jackpham-rgb/MEproject2026F/docs/draft/README.md

# Draft concept notes

`Project_Notes_ConceptA.docx` (also in the team Google Doc) is an **early draft written for the
concept / PDR stage**. Its numbers and parts (lazy-susan, 4.7 in can, 2 bushings, block CAD) are
out of date. The current design is in `docs/03_detail_design.md`, `docs/04_wiring.md` and
`docs/05_bom.md`.
