jackpham-rgb/MEproject2026F/docs/draft/Project_Notes_ConceptA.docx

# ME 2331 Project

notes on how robot works, what it is made of, why picked each part, and the parts list

# 1. What it has to do

An empty soda can (2.4 in wide, 4.7 in tall, about 15 g) stands upright on the table, 5 in from the robot. The robot has to flip it upside down and put it down, standing on its own, at a second spot. That spot is also 5 in from the robot, and 90 degrees from original position. It has to run on an Arduino Uno with no one touching it after the start button, assume we don't need fancy sensor to detect where is the can originally.

# 2. The main idea (Concept A: claw + wrist flip + turntable)

The robot sits at the corner, and works like a small crane:

- Turntable: the whole robot turns around a vertical axis at the robot's location. This is what moves the can 90 degrees, at 5 in.
- Lift: the arm can move up and down a little (about 0.6 in) on the column.
- Wrist: at the end of the arm, a wrist turns the gripper 180 degrees. This is what flips the can upside down.
- Gripper: 2 arms that close on the middle of the can.

So the robot does 4 simple moves one after another: grip, lift, flip, turn, then lower and let go. Every move is done by its own servo, so each step is easy to test by itself.

Since the turntable is right at the robot's location, the 90 degrees is exactly what the requirement asks for: the robot itself visibly turns 90 degrees, and the can stays 5 in away the whole time.

[PUT GIF HERE: conceptA_claw_turntable.gif] (Concept A, the full move)

## Why it needs the lift

The can is gripped in the middle, 2.35 in above the table. But the corner of the can (bottom edge) is 2.64 in from the middle (√(1.2² + 2.35²)). So if the wrist flips the can without lifting, the corner digs about 0.29 in into the table. Lifting 0.6 in first gives about 0.3 in of room.

[PUT GIF HERE: conceptA_claw_turntable_no_lift_hits_table.gif] (same move with no lift: the table turns red where the can hits it)

# 3. step by step

1. Home: at power-on, all 4 servos go to their start angles. Servos already know their own angle, so no home switch is needed.
2. Wait: the robot waits for someone to press the start button.
3. Optional: Detect: an IR sensor in the gripper checks that a can is really between the arms.
4. Grip: a small servo closes the arms to a set angle, just past where the pads touch the can (found by testing), so the can won't be dent. A normal servo can't tell the Arduino when it has stopped, so we use a fixed angle and let the soft pads do the squeezing.
5. Lift: the lift servo raises the arm about 0.6 in, so the can is off the table.
6. Flip: the wrist servo turns the gripper 180 degrees, so the can is now upside down. It starts slow, speeds up, and slows down again at the end, to make sure the whole thing won't shake and the can won't slip out.
7. Turn: the turntable servo turns the whole arm 90 degrees, slowly in the same way, so the can is now above the target.
8. Lower: the lift servo goes back down the same 0.6 in. The can was flipped around its own middle, so it lands exactly on the table, no drop.
9. Release: the arms open. The can stands upside down on the target spot.
10. Optional: Return: only after the can is taken away, press the button again: the lift goes up, the wrist turns back, and the arm turns back to the start. Not before: the open arms are still on both sides of the can and would knock it over.
11. Optional: the LED stays on when done.

If anything goes wrong (no can, can slips), the robot stops and opens the arms. That is called a fault.

Why slow at the start and end of every move? The can is empty and only 15 g. A fast stop can make it swing in the arms or shake loose, so every servo move is eased in and out (about 1–1.5 s per move).

# 4. Why this design and not the others

looked at 4 ideas. Our ranking: A → B → D → C.

## A. Claw + wrist flip + turntable (picked)

The most natural one: most people would vote for it, because it moves the can the way a person would. The robot turns 90 degrees right in front of you, so it clearly meets the requirement.

Downside: lots of failure points. 4 servos work one after another, and each can be a little off (turntable angle, lift binding, wrist not reaching a full 180 degrees). And it needs the lift, or the can hits the table (see the GIF in section 2).

[PUT GIF HERE: conceptA_claw_turntable.gif] (optional here, same GIF as section 2)

## B. Cradle flip + drag

A tall cradle holds the can, flips it in place, sets it down upside down, then drags it 90 degrees along the table. It is more complicated in movement: dragging an upside-down can on its thin rim can wobble or tip it.

[PUT GIF HERE: conceptB_cradle_drag.gif]

## D. Mirror flip

One arm turns 180 degrees around a diagonal shaft, and that flips and moves the can in one motion, with only 2 motors. It is technically true to the requirement (the can ends 90 degrees away at 5 in, measured from the robot's corner), but it can be called the lazy option: the arm swings 180 degrees and the robot never turns 90 degrees itself. So it won't be the first pick. It also needs a precise gear motor with encoder and a shaft height built to ±0.04 in.

[PUT GIF HERE: conceptD_mirror_flip.gif]

## C. Multi-joint pincer arm

A real robot arm (base, shoulder, elbow, wrist) that lifts, swings and rolls the can. The most beautiful one, but the hardest and most complicated: 5 servos, hard math (inverse kinematics), and it gets wobbly at a 5 in reach.

[PUT GIF HERE: conceptC_pincer_arm.gif]

## Decision matrix

Each idea scored 1 (bad) to 5 (good) on what matters most for our team. Weight = how important.

Criteria | Weight | A | B | D | C
Clearly meets the 90° around the robot requirement | 0.25 | 5 | 5 | 2 | 4
Can lands upright and upside down reliably | 0.20 | 4 | 2 | 4 | 4
Few failure points (fewer motors) | 0.15 | 2 (4 servos) | 2 (4) | 5 (2) | 1 (5)
Simple parts and electronics | 0.15 | 4 (servos only) | 4 | 2 (motor + encoder + driver) | 3
Simple movement and code | 0.15 | 4 (one move at a time) | 3 | 3 | 1 (inverse kinematics)
Easy to build (tolerances) | 0.10 | 3 | 3 | 2 (±0.04 in) | 2
Total (out of 5) | | 3.85 | 3.30 | 3.00 | 2.75

## How the total is calculated

For each idea: multiply each score by its weight, then add them up. The weights add up to 1.00, so the total is still out of 5.

Example, Concept A:

- 90° requirement: 5 × 0.25 = 1.25
- Lands reliably: 4 × 0.20 = 0.80
- Few failure points: 2 × 0.15 = 0.30
- Simple parts: 4 × 0.15 = 0.60
- Simple movement: 4 × 0.15 = 0.60
- Easy to build: 3 × 0.10 = 0.30

Total = 1.25 + 0.80 + 0.30 + 0.60 + 0.60 + 0.30 = 3.85

Same way: B = 1.25 + 0.40 + 0.30 + 0.60 + 0.45 + 0.30 = 3.30, D = 0.50 + 0.80 + 0.75 + 0.30 + 0.45 + 0.20 = 3.00, C = 1.00 + 0.80 + 0.15 + 0.45 + 0.15 + 0.20 = 2.75.

Check: even if every criteria is weighted the same (just the average of the 6 scores), the order stays A (3.67), B (3.17), D (3.00), C (2.50).

# 5. Main parts and what each one does

- Base plate: holds everything down and keeps the robot in the right spot on the table. It would be helpful to add weight to keep the base heavy, since the arm reaches out 5 in and could tip the robot.
- Turntable (lazy susan bearing + turntable servo): turns the whole robot 90 degrees. The bearing carries the weight, so the servo only has to turn it.
- Column: stands on the turntable and holds the lift.
- Lift carriage + lift servo: slides up and down the column on 2 guide rods with LM6UU bearings, about 0.6 in, so the can can flip without hitting the table.
- Arm: reaches out from the column so the middle of the can is 5 in from the robot's turning point.
- Wrist + wrist servo: at the end of the arm, turns the gripper 180 degrees to flip the can.
- Gripper (palm + 2 arms): V-shaped arms that center the can by themselves when they close, with soft pads. Grips the can in the middle (2.35 in high).

# 6. Materials and why

Part | Material | Why
Base, turntable plate, column, lift carriage, arm, wrist mount, palm, arms | PLA (3D printed) | Cheap, easy to print, stiff enough for these small loads. No heat or outdoor use, so we don't need ABS or PETG.
arm pads | TPU (flexible print) or silicone sheet | Grippy. The can doesn't slip with a light squeeze, and the soft pad keeps the can from denting.
Turntable bearing | Lazy susan bearing, 3–4 in (steel) | Holds the weight of the arm and can so the turntable servo doesn't carry it on its own shaft. Makes the turn smooth and less wobbly.
Lift guide | 2 × 6 mm steel rods + 2 LM6UU linear bearings | Smooth up and down. The arm sticks out about 3 in, which tilts the carriage like a drawer pulled by one corner: a printed plastic slide would jam (we calculated it), the LM6UU bearings slide freely.
Base weight | Steel washers or bolts | Keeps the robot from tipping when the arm reaches out 5 in with the can.
Fasteners | M3 screws and nuts | Standard size, fits most small electronics and printed parts.

# 7. Electronics:

- Arduino Uno: the brain, required.
- Turntable servo (MG996R, 180°): strong servo for turning the whole arm 90 degrees.
- Lift servo (MG90S): raises and lowers the arm about 0.6 in, through a small lever or rack.
- Wrist servo (micro servo that really reaches 180°, or a 270° micro servo): flips the can. Many cheap servos stop around 170°, so this one has to be checked or we use a 270° one.
- Gripper servo (SG90 or MG90S): opens and closes the arms.
- 5–6 V power supply for the servos, 5 A or more (buck converter or adapter): 4 servos can pull a lot of current at the same time (the MG996R alone can pull about 2.5 A). If the servos ran off the Uno's 5 V pin, it would reset the Uno in the middle of a move.
- Big capacitor (1000 µF) on the servo power: smooths out the current spikes when servos start moving.
- Start button: starts the run.
- Optional: IR sensor: checks the can is in the arms before starting.
- Optional: FSR (force sensor): measures grip force (stop at about 1.5 N) and confirms the can is really held before lifting.

No motor driver and no encoder needed: servos already hold their own angle, and the Arduino Servo library runs all 4 from any pins.

# 8. Bill of Materials (BOM)

# | Item | Qty | Source | Est. cost | Notes

1 | Arduino Uno R3 | 1 | ELEGOO kit | —
2 | MG996R servo (180°) | 1 | Buy | $8–10 | Turntable
3 | MG90S servo | 1 | Buy | $4 | Lift
4 | Micro servo with full 180° (or 270° micro servo) | 1 | Buy | $5–8 | Wrist flip, check the range
5 | SG90 or MG90S servo | 1 | Kit / buy | $0–4 | Gripper
6 | Lazy susan bearing, 3–4 in | 1 | Buy / hardware store | $4 | Turntable
7 | 6 mm steel rod ~3 in + LM6UU linear bearings | 2 + 2 | Buy | $6 | Lift guide (needed, a printed slide jams)
8 | 5–6 V buck converter, 5 A or more | 1 | Buy | $6 | Servo power
9 | Power supply 7–12 V, 3 A or more | 1 | Buy / lab | $10
10 | 1000 µF capacitor | 1 | Kit / buy | $1 | Servo power
11 | Push button | 1 | Kit | — | Start
12 | IR proximity module (TCRT5000 or KY-032) | 1 | Kit / buy | $1–2 | Optional, can detect
13 | FSR 402 force sensor + 10 kΩ resistor | 1 | Buy | $7 | Optional
14 | TPU filament or silicone sheet | A small sheet | Buy | $2 | arm pads
15 | Steel washers / bolts | Some | Hardware store | $2 | Base weight
16 | 3D printed parts (base, turntable plate, column, lift carriage, arm, wrist mount, palm, 2 arms) | 9 | Print (PLA) | filament
17 | M3 screws, nuts, wires, headers | — | Kit / buy | $5
| Total to buy (beyond the Arduino kit) | | | about $50–65 | about $40–55 without the optional parts

# 9. Check after buying

- Check the wrist servo really turns a full 180 degrees. If not, switch to a 270° servo.
- Find the exact servo angles: turntable at start and at 90°, lift up and down, gripper open and closed on a can.
- Check the lift slides smoothly and goes up at least 0.6 in.
- Squeeze a few scrap cans to see when they dent, then set the gripper angle below that.
- Model the parts in SolidWorks and check the robot doesn't tip with the arm reaching out.
- Measure the can's top rim size.
