jackpham-rgb/MEproject2026F/docs/drawings/CA-101_base.png

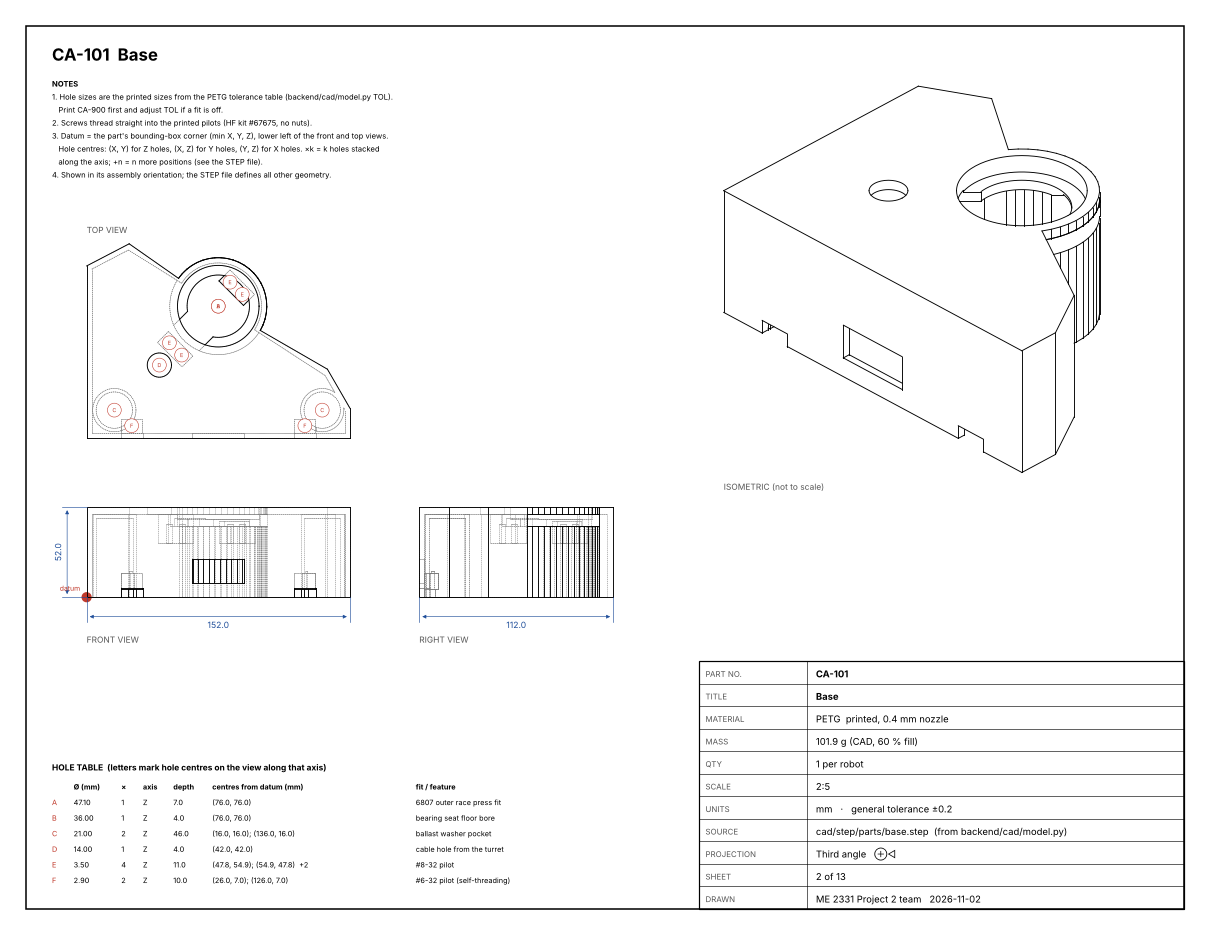
docs/drawings/CA-101_base.png
