jackpham-rgb/MEproject2026F/docs/drawings/CA-102_electronics_tray.png

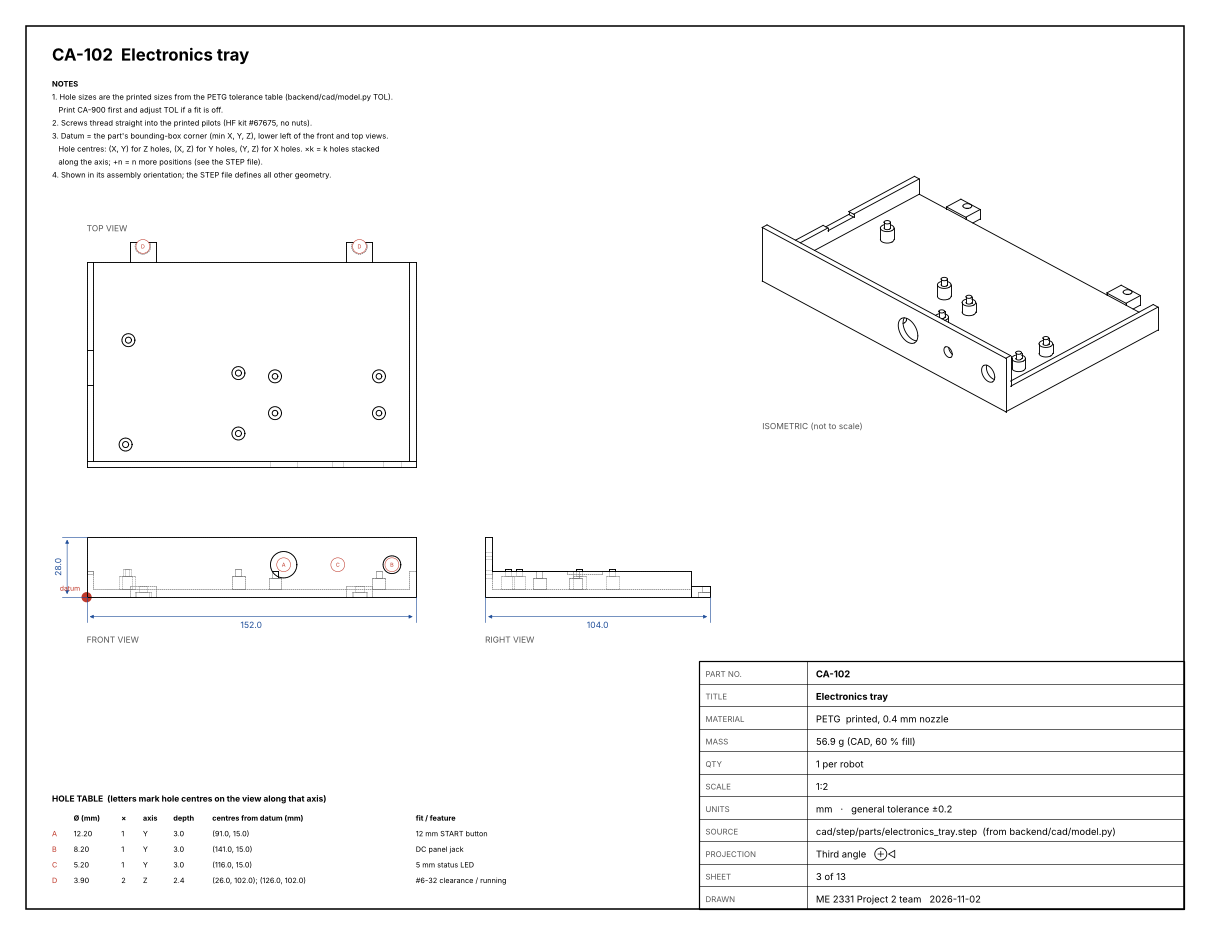
docs/drawings/CA-102_electronics_tray.png
