jackpham-rgb/MEproject2026F/docs/drawings/CA-201_turret_plate.png

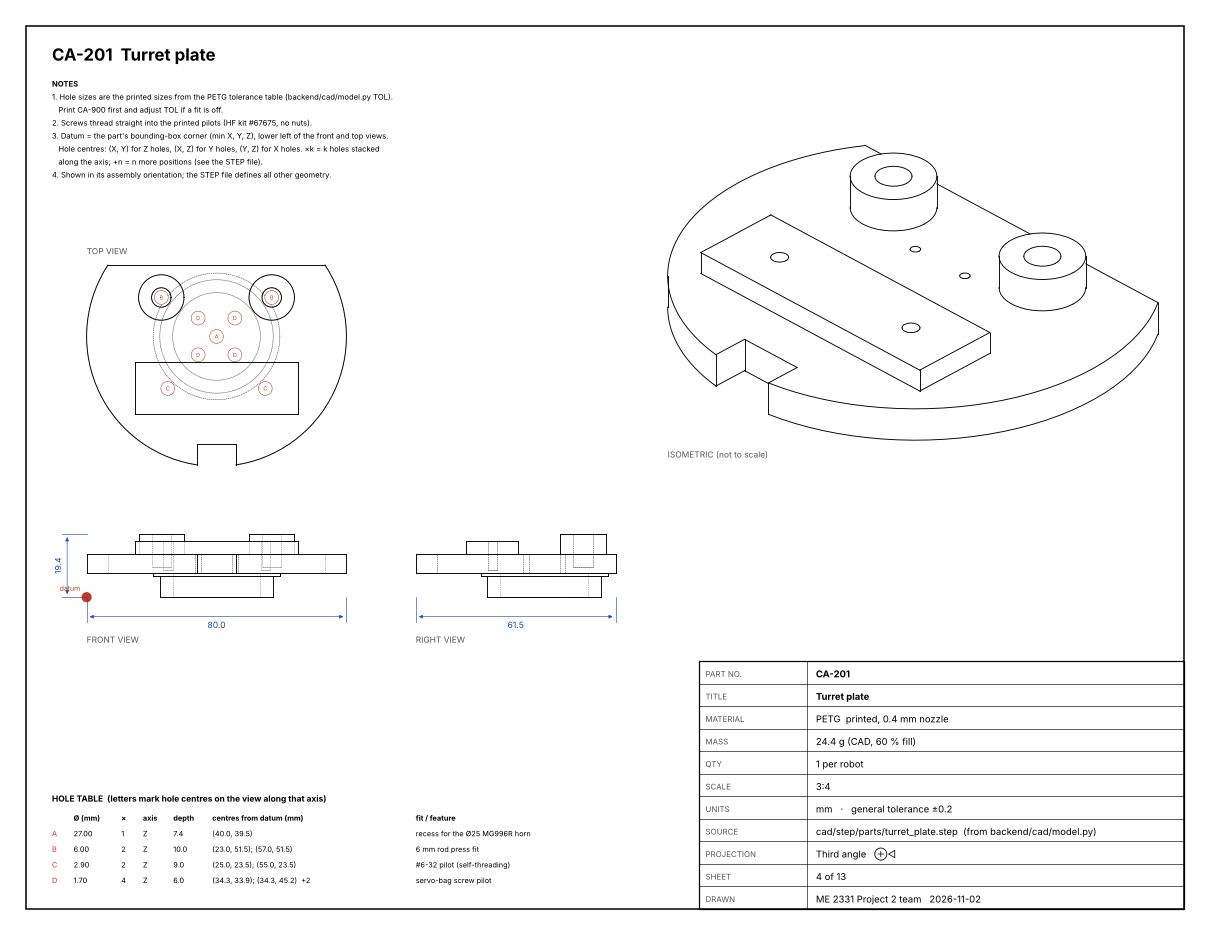
docs/drawings/CA-201_turret_plate.png
