jackpham-rgb/MEproject2026F/docs/drawings/CA-202_spine.png

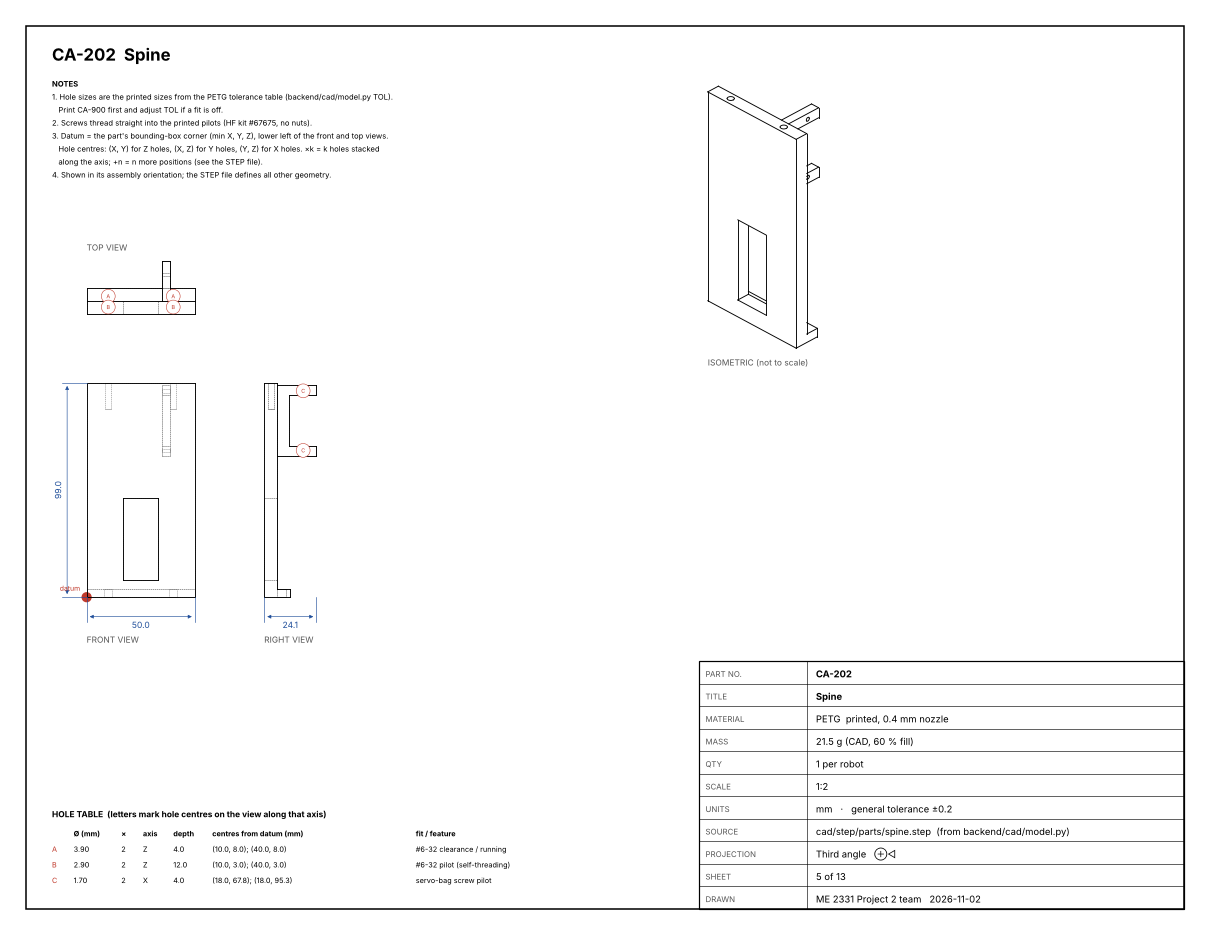
docs/drawings/CA-202_spine.png
