jackpham-rgb/MEproject2026F/docs/drawings/CA-203_top_cap.png

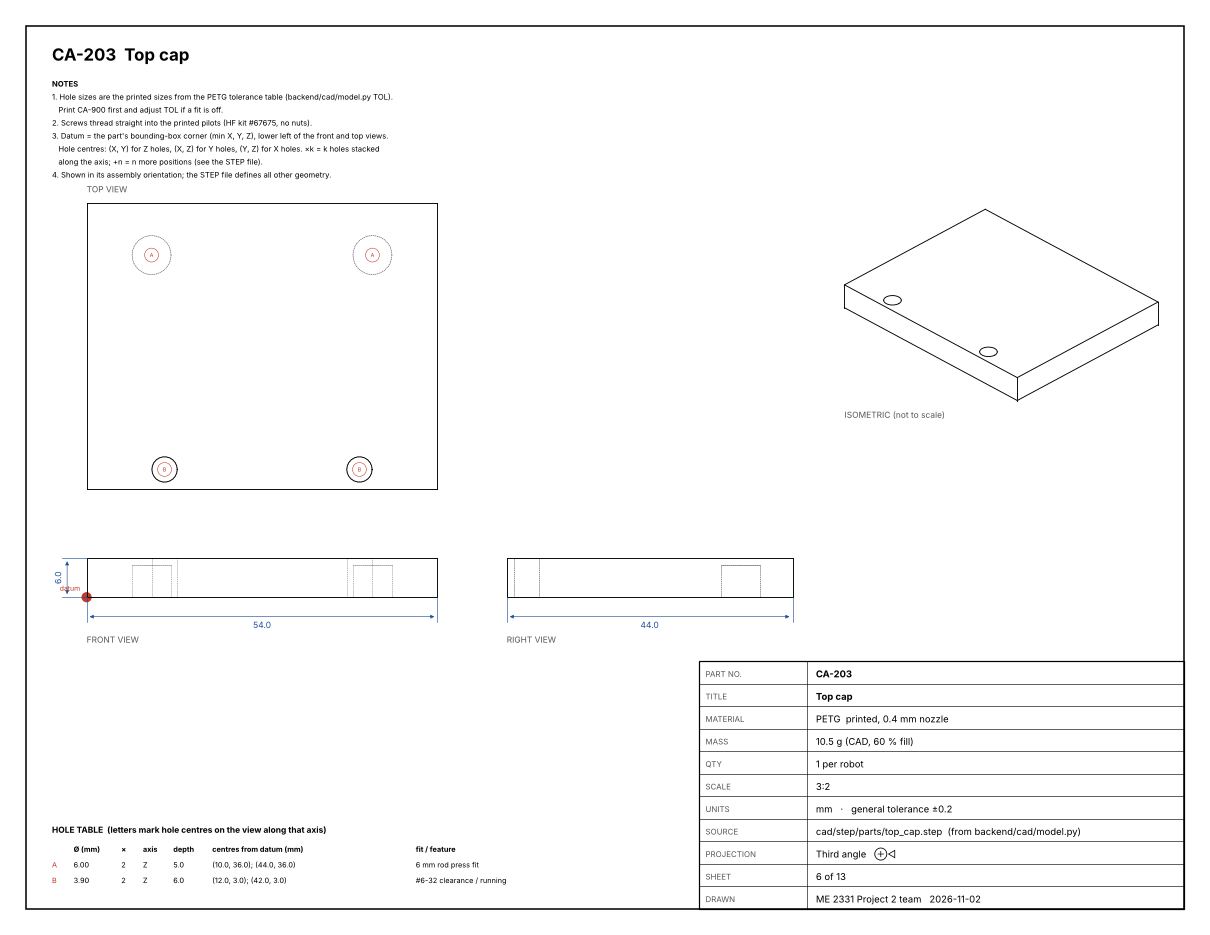
docs/drawings/CA-203_top_cap.png
