jackpham-rgb/MEproject2026F/docs/drawings/CA-301_carriage_arm.png

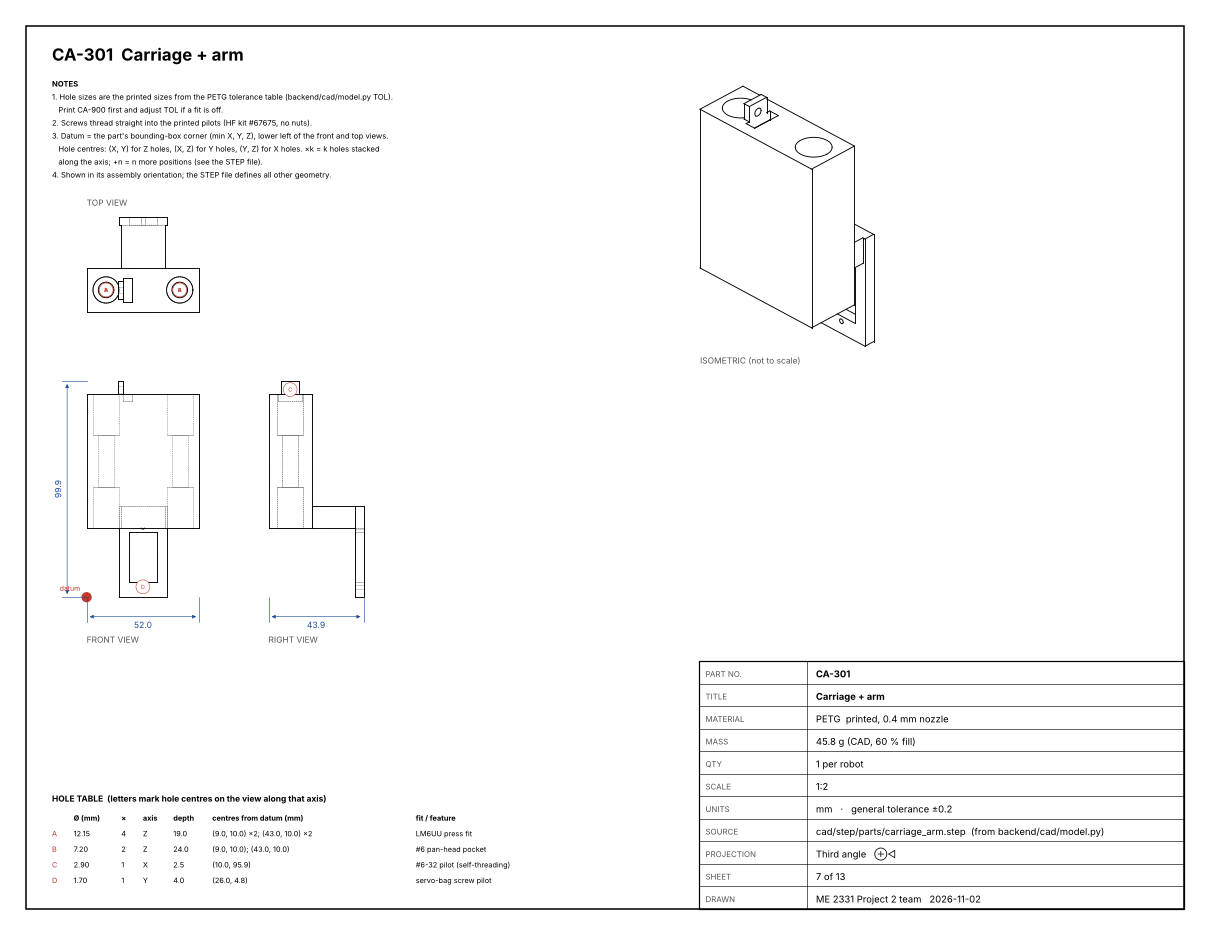
docs/drawings/CA-301_carriage_arm.png
