jackpham-rgb/MEproject2026F/docs/drawings/CA-302_lift_link.png

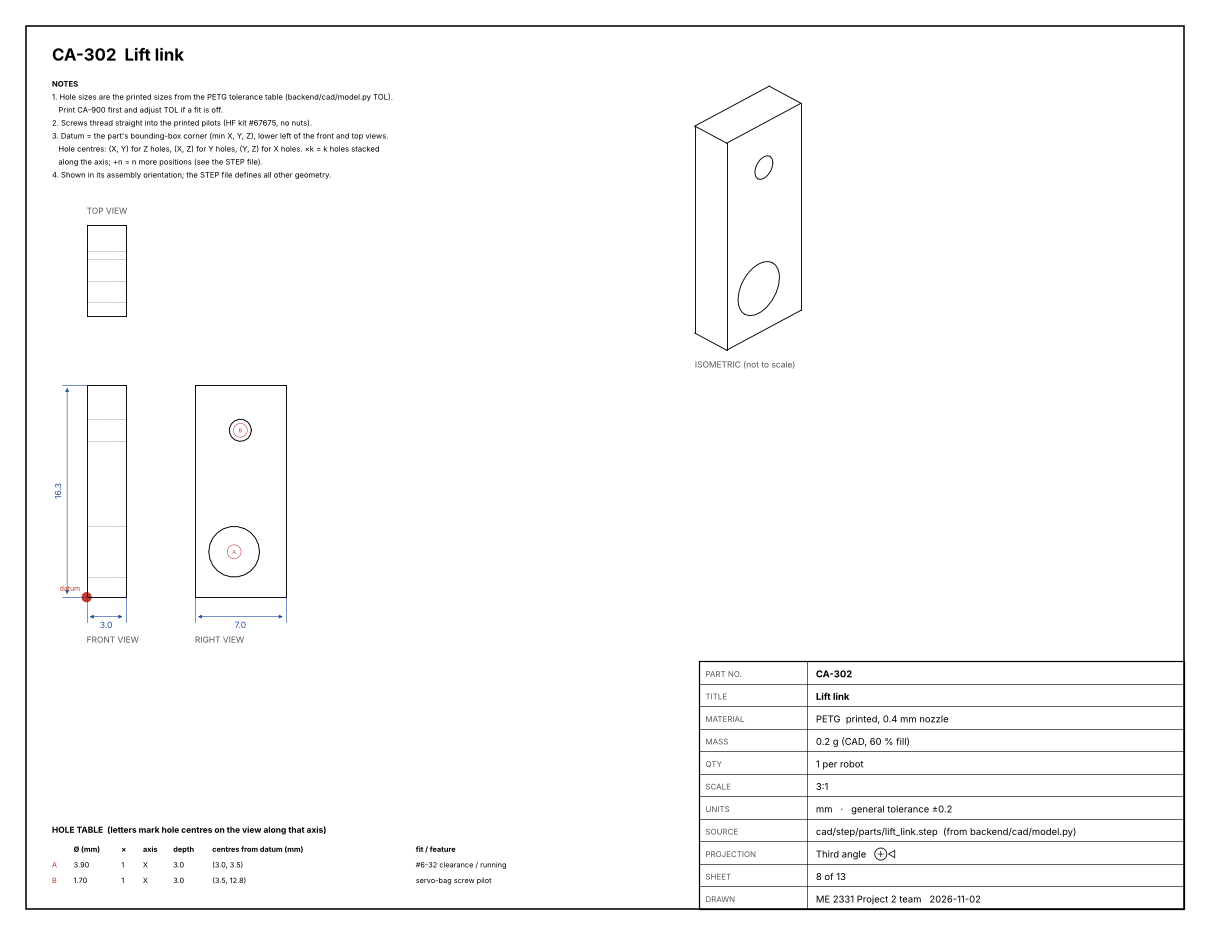
docs/drawings/CA-302_lift_link.png
