jackpham-rgb/MEproject2026F/docs/drawings/CA-401_gripper_frame.png

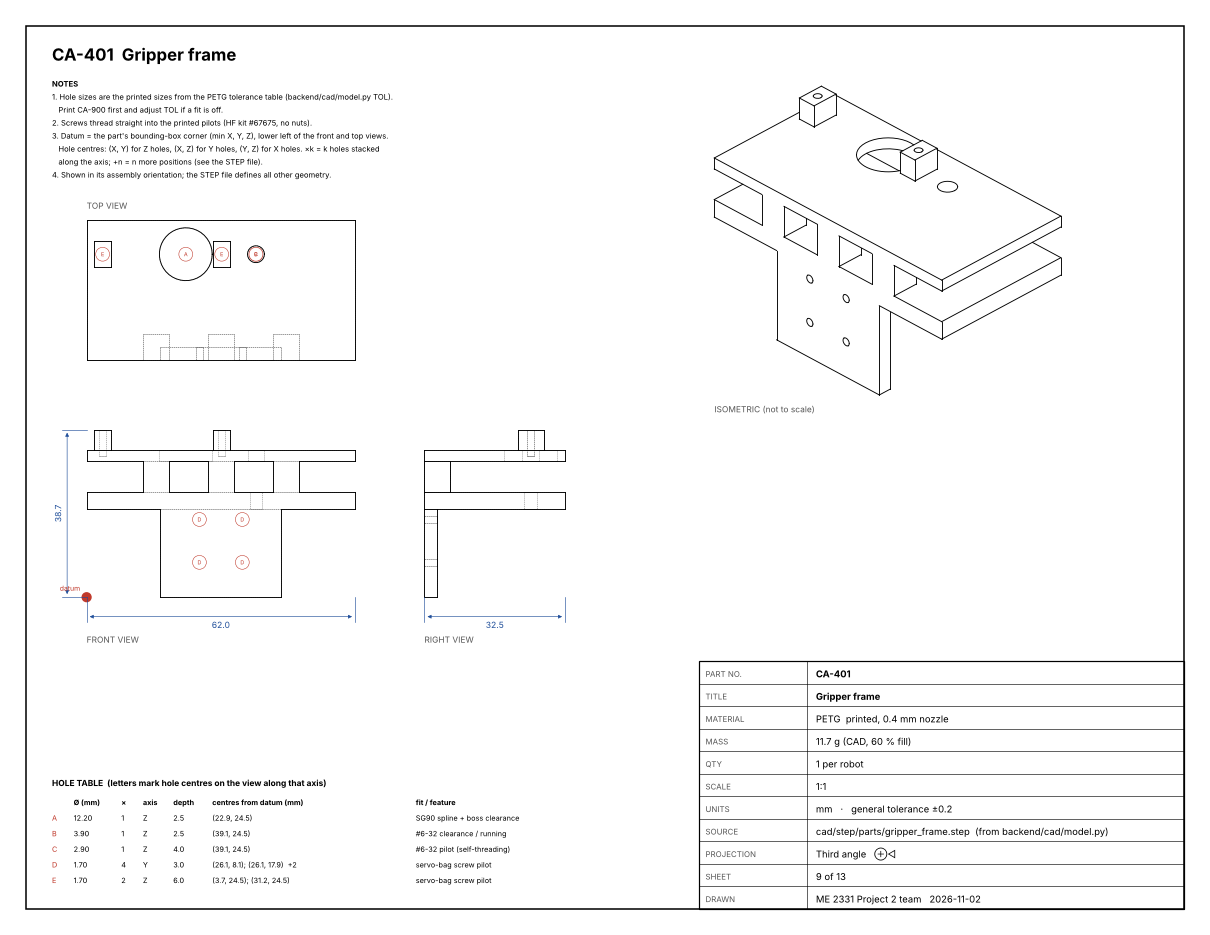
docs/drawings/CA-401_gripper_frame.png
