jackpham-rgb/MEproject2026F/docs/drawings/CA-402_finger_R.png

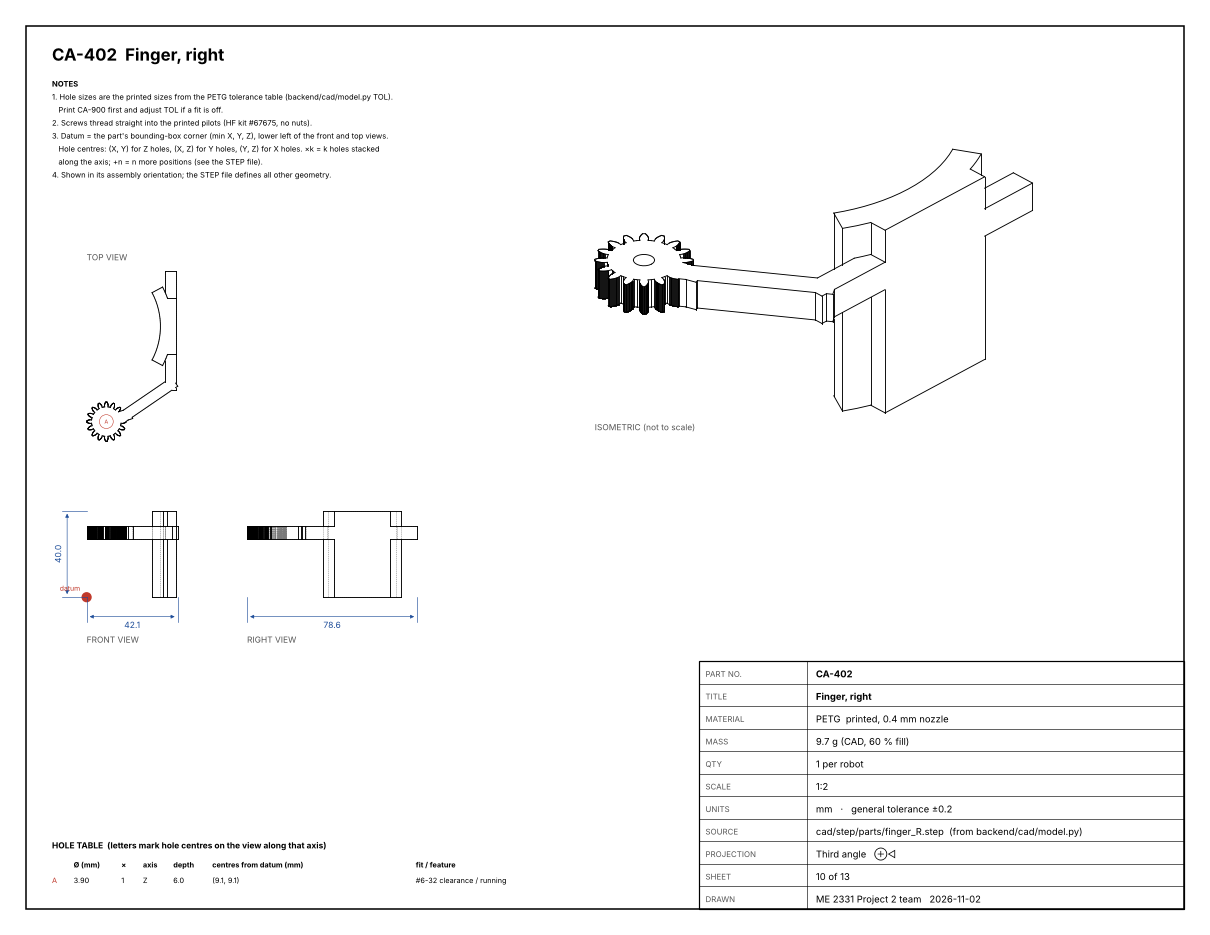
docs/drawings/CA-402_finger_R.png
