jackpham-rgb/MEproject2026F/docs/drawings/CA-403_finger_L.png

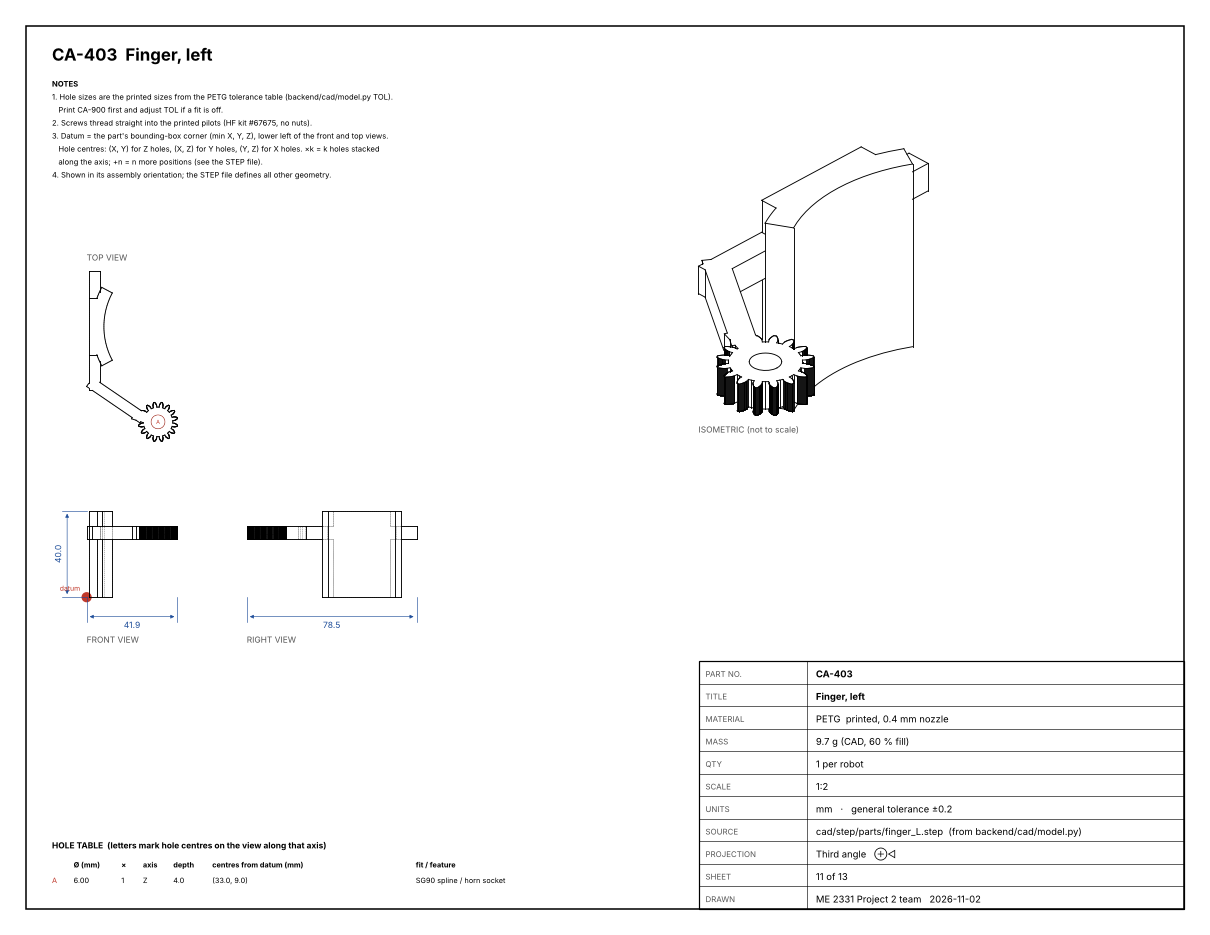
docs/drawings/CA-403_finger_L.png
