jackpham-rgb/MEproject2026F/docs/drawings/CA-404_can_bumper.png

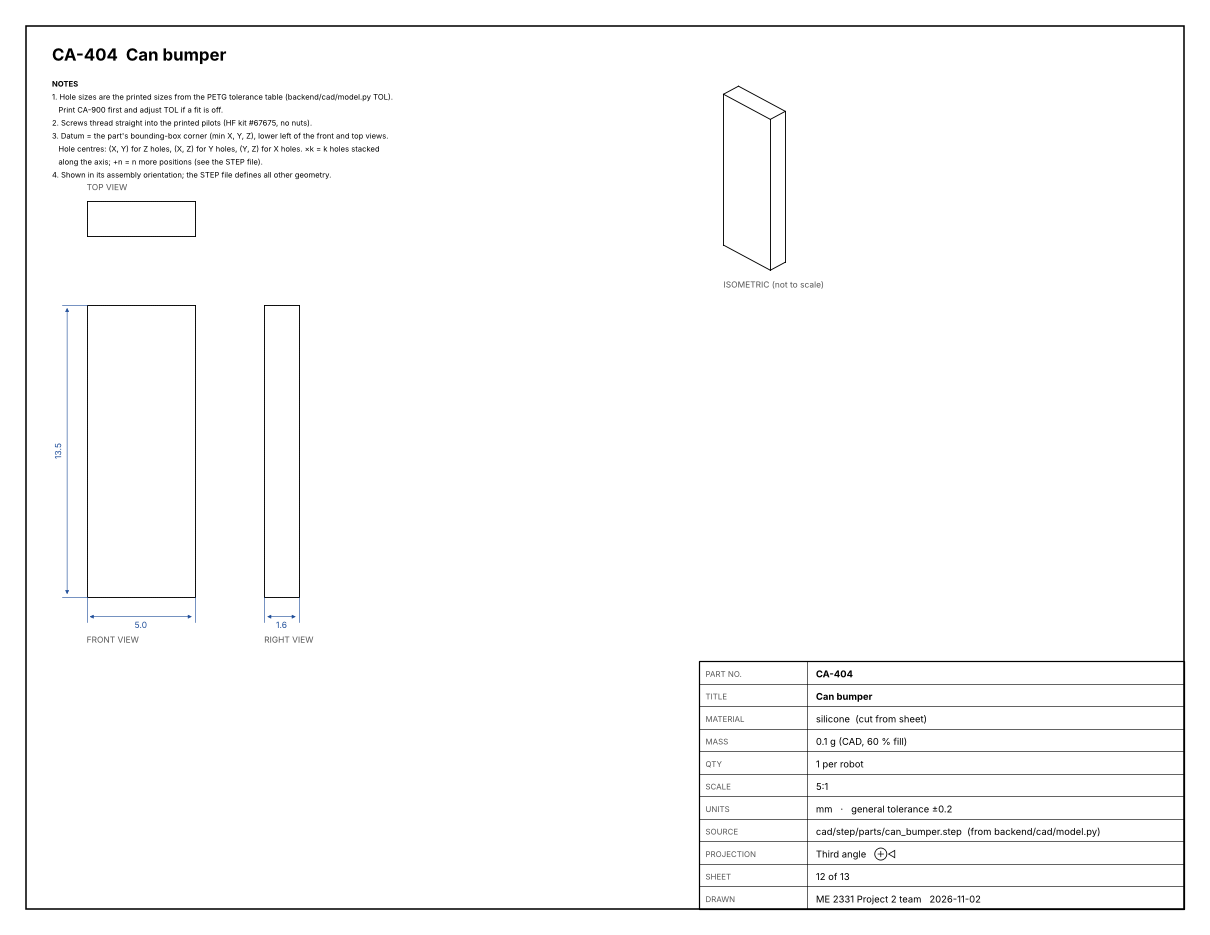
docs/drawings/CA-404_can_bumper.png
