jackpham-rgb/MEproject2026F/docs/drawings/CA-900_tolerance_coupon.png

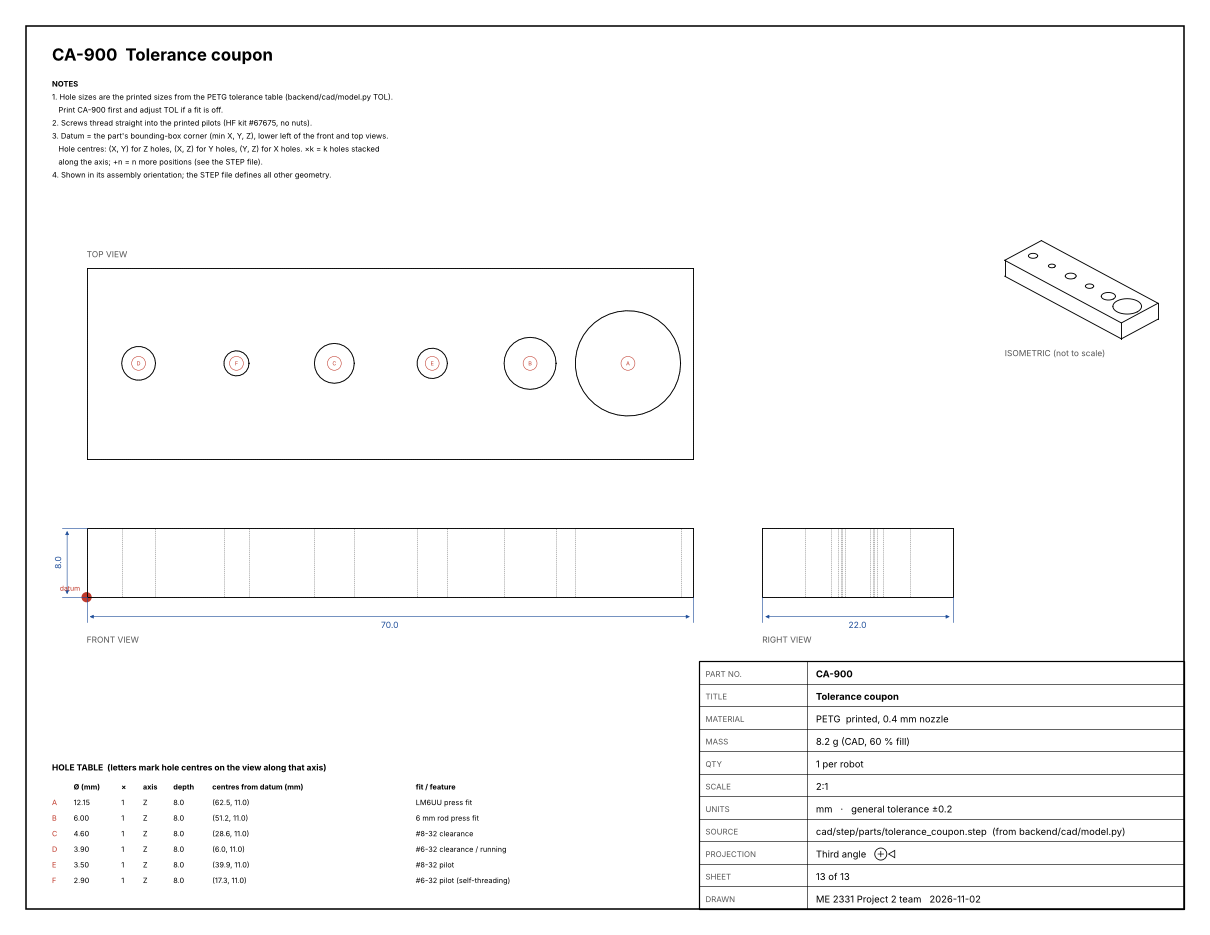
docs/drawings/CA-900_tolerance_coupon.png
