jackpham-rgb/MEproject2026F/docs/manual/part_electronics_tray.png

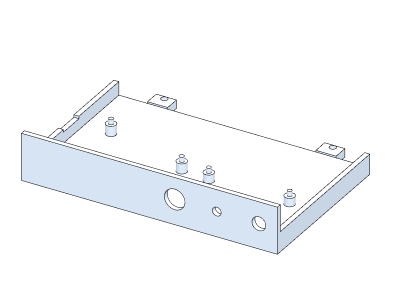
docs/manual/part_electronics_tray.png
