jackpham-rgb/MEproject2026F/EE/out/power_final.png

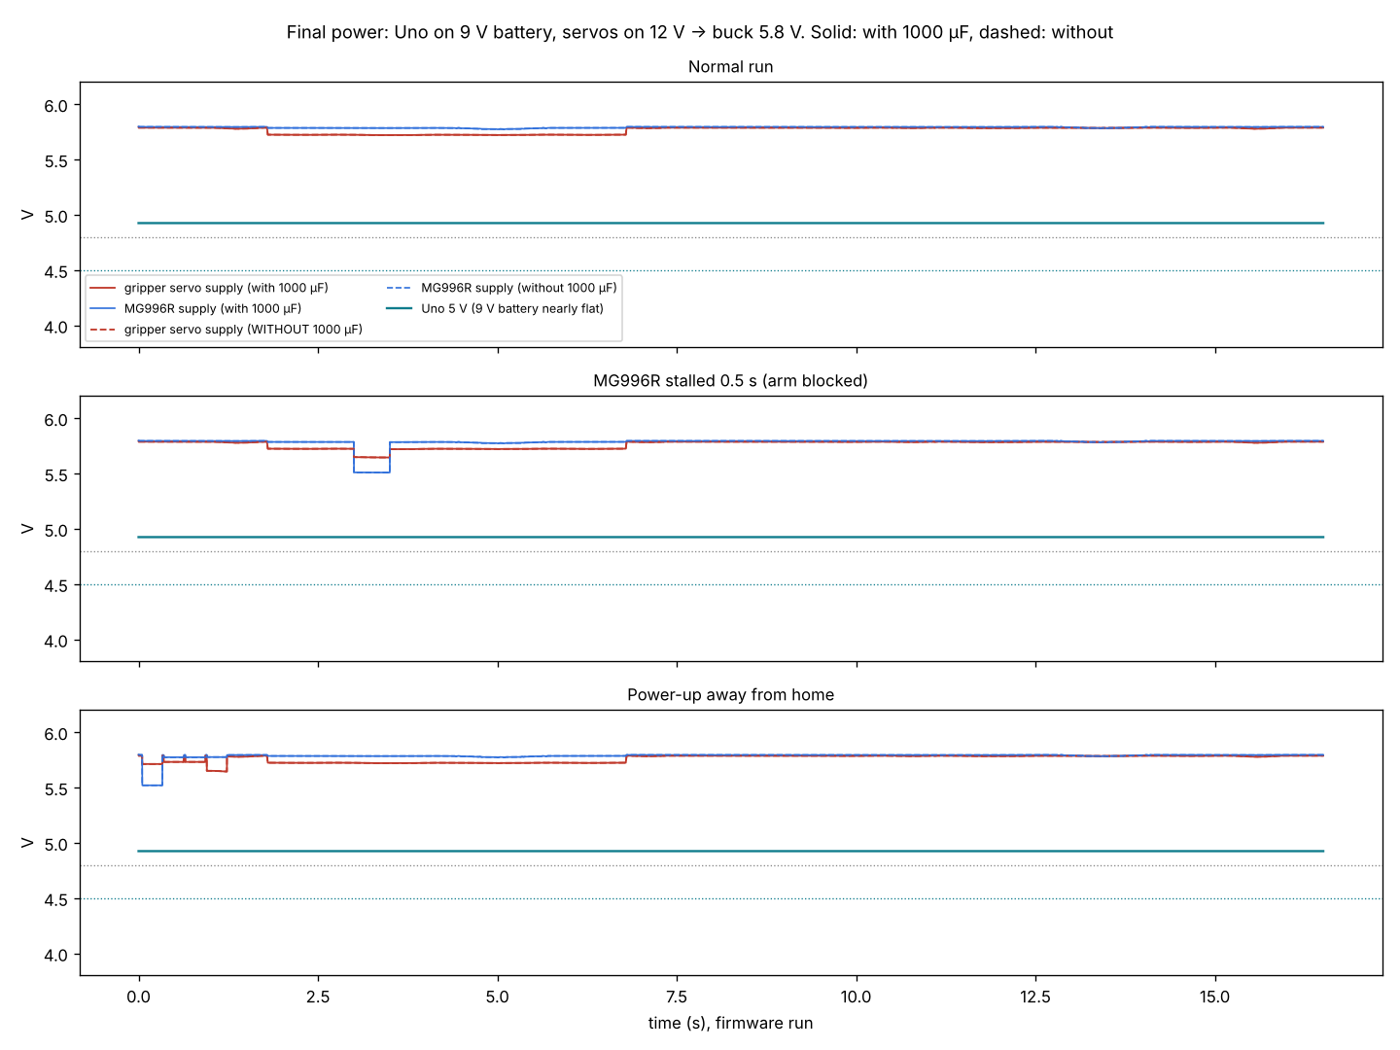
EE/out/power_final.png
