jackpham-rgb/MEproject2026F/sim/concept_a_clearance.png

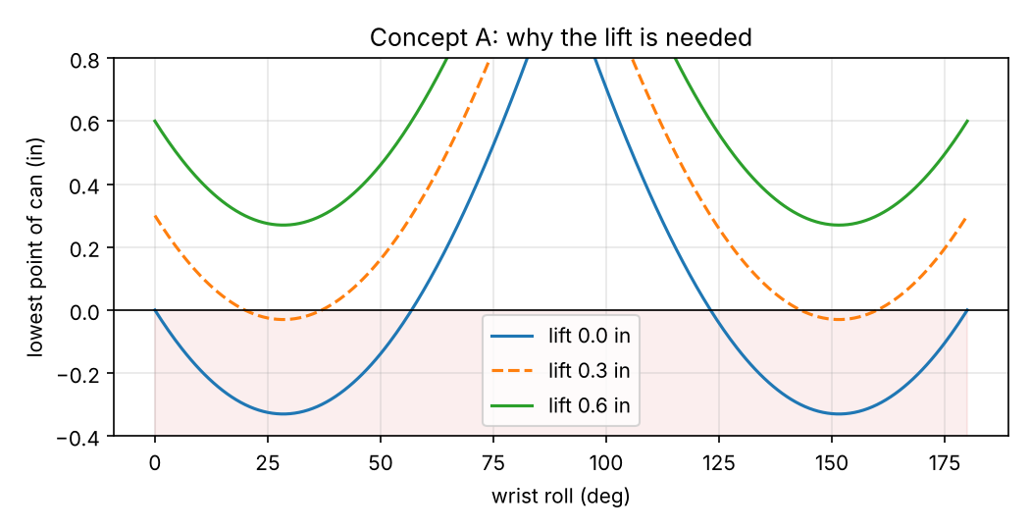
sim/concept_a_clearance.png
