jackpham-rgb/MEproject2026F/sim/concept_a_sequence.png

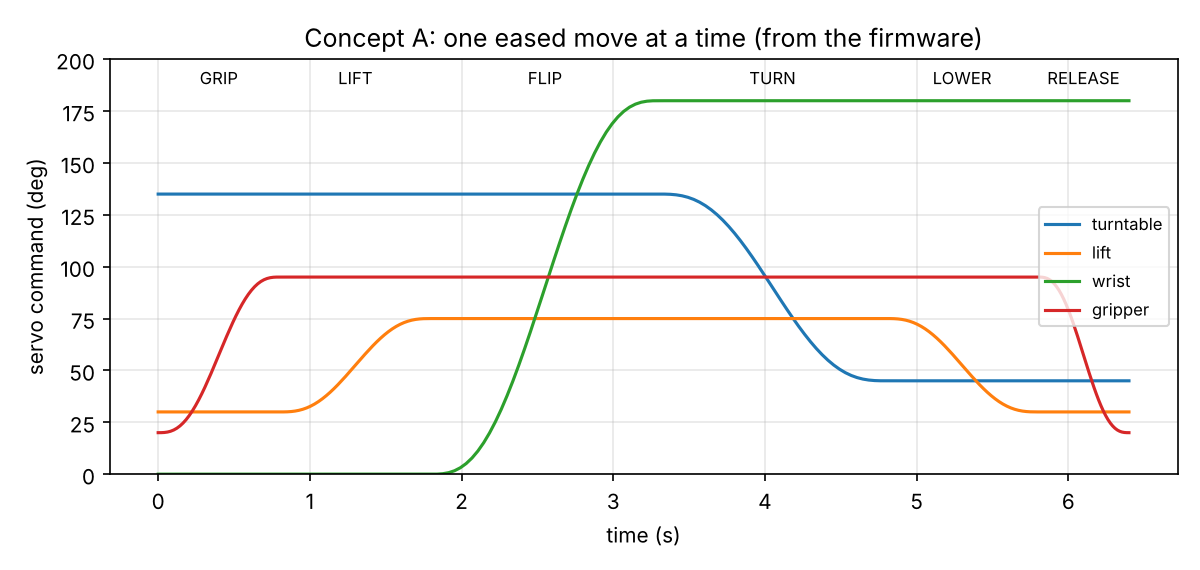
sim/concept_a_sequence.png
