jackpham-rgb/MEproject2026F/viewer/gifs/conceptA_claw_turntable.gif

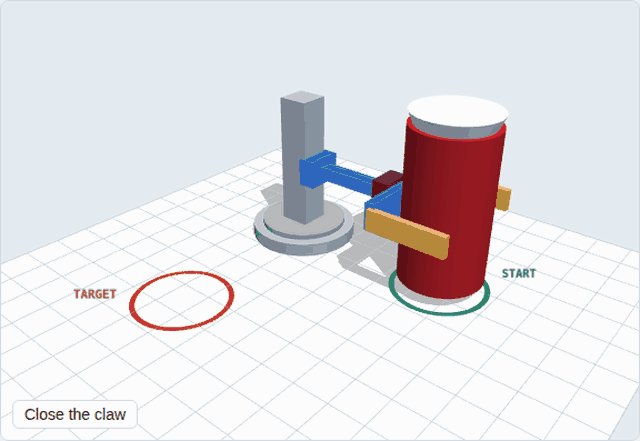
viewer/gifs/conceptA_claw_turntable.gif
