jackpham-rgb/MEproject2026F/viewer/gifs/conceptB_cradle_drag.gif

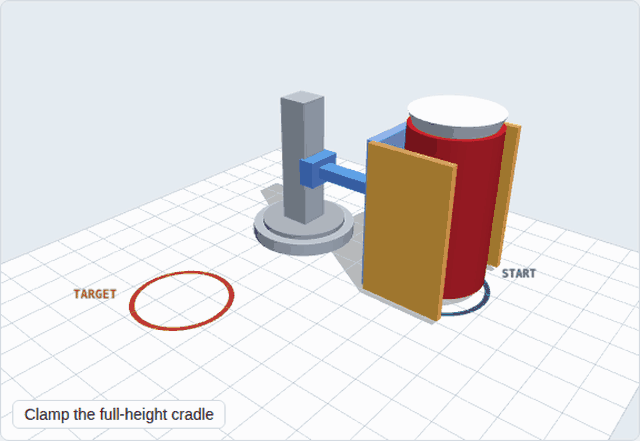
viewer/gifs/conceptB_cradle_drag.gif
