jackpham-rgb/MEproject2026F/viewer/gifs/conceptD_mirror_flip.gif

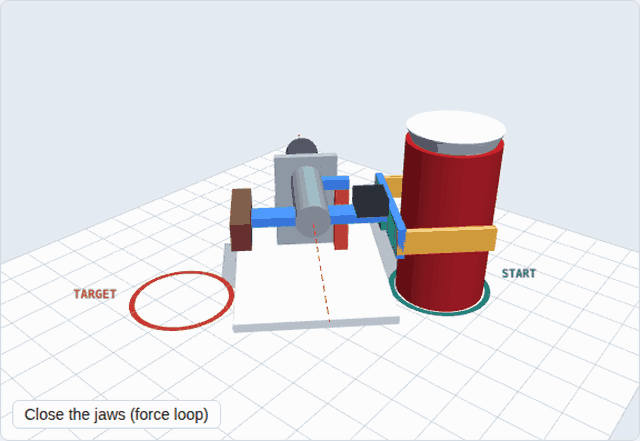
viewer/gifs/conceptD_mirror_flip.gif
