jackpham-rgb/MEproject2026F/docs/decision_matrix_and_bom.xlsx

Sheet: Concepts
Concept decision matrix (binary)
1 = yes / good, 0 = no / bad. Totals and ranks are formulas: change a blue score and they update. B and D tie on points; the tie goes to the concept that meets criterion 1 (the spec's 90° turn), which matches the team's weighted matrix (A 3.85, B 3.30, D 3.00, C 2.75).
# | Criterion (1 = yes / good, 0 = no / bad) | A: claw + wrist flip + turntable | Why (the number behind the score) | B: cradle flip + drag | Why (the number behind the score) | C: multi-DOF pincer arm | Why (the number behind the score) | D: mirror flip (diagonal axis) | Why (the number behind the score)
1 | Robot visibly turns 90° about its own location | 1 | Turntable at the corner turns 90°; can stays 5 in (127 mm) out | 1 | Same turntable, 90° | 1 | Base yaw joint turns 90° | 0 | One 180° roll about a 45° axis; the robot never rotates, the 90° only shows in plan view
2 | Can is held for the whole move (never slid or dropped) | 1 | Held GRIP → RELEASE; lowered to z = 0.00 mm before opening (CAD check) | 0 | Dragged 7.9 in (5 in × π/2) on its thin rim | 1 | Held until set down | 1 | Held; released 2 mm (0.08 in) above the table
3 | Landing spot set by geometry, not fine tuning | 1 | Flip about the can centre: lowering 0.6 in = lift 0.6 in; ±2° turn = ±0.17 in | 0 | Rim friction on the table decides where it stops | 0 | 3-joint inverse kinematics; ~1° backlash per servo stacks to ~0.3 in | 1 | Exact by symmetry of the 180° roll
4 | 3 or fewer actuators (fewer failure points) | 0 | 4 servos | 0 | 4 actuators | 0 | 5 servos | 1 | 2: gearmotor + grip servo
5 | Hobby servos only (no encoder, motor driver or PID) | 1 | 4 servos, open loop | 1 | Servos | 1 | Servos | 0 | Gearmotor + encoder + driver; closed loop needed (overshoot > 0.9° hits the table)
6 | One move at a time, each testable on its own | 1 | 6 steps: grip, lift, flip, turn, lower, release | 1 | Clamp, lift, flip, drag, release | 0 | Joints must move together for a straight path | 1 | One flip move
7 | No build-critical dimension tighter than ±1 mm | 1 | Lift gives +0.27 in (6.9 mm) table clearance; slots and pilots from the tolerance coupon | 1 | Cradle fits loosely around the can | 0 | Link lengths feed the IK; errors add up at the 5 in reach | 0 | Axis height ±0.04 in (±1 mm) or the rim hits the table
8 | Servo torque margin ≥ 3× | 1 | CAD loads: lift 5×, wrist 30×, turntable > 100× (weight on the bearing) | 1 | Similar servos and loads to A | 0 | Shoulder holds arm + can at 5 in: ~1.5 kg·cm vs 1.8 for an MG90S (1.2×) | 1 | 18 mN·m (0.18 kg·cm) after the counterweight
9 | Can path stays clear of the robot body | 1 | No collisions in 289 poses (CAD solid check) | 1 | Can stays outside the base | 1 | Can stays outside the base | 0 | Can passes over the robot; base must stay low
10 | No separate lift axis needed | 0 | Needs a 0.6 in lift: without it the can digs 0.33 in into the table | 0 | Same in-place flip, same lift | 1 | Shoulder lifts the can | 1 | Can arrives moving straight down; +0.06 in clearance mid-flip
 | TOTAL (number of 1s)
 | Share of criteria met
 | Rank (ties broken by criterion 1)

Sheet: Power source
Power source decision matrix (binary)
Stall currents: MG996R 2.5 A, MG90S 0.7 A, SG90 0.65 A. Normal run peak 0.65 A. Rows 1 and 5-7 are ngspice results (backend/ee/ee_calcs.py): the 12 V + buck design keeps the Uno at 5.00 V and the servos at >= 5.5 V in a stall; the 5 V direct design is simpler but dips below both limits.
# | Criterion (1 = yes / good, 0 = no / bad) | 9 V battery (PP3) + buck | Why (the number behind the score) | 4×AA NiMH (servos) + 9 V (Uno) | Why (the number behind the score) | 2S LiPo 7.4 V + buck | Why (the number behind the score) | 12 V wall adapter + XL4015 buck 5.8 V (selected) | Why (the number behind the score) | 5 V 4 A wall adapter, direct | Why (the number behind the score)
1 | Covers a 2.5 A MG996R stall without current-limiting | 0 | A PP3 gives ~0.5–1 A; under 2.5 A it collapses | 1 | NiMH AA cells handle 2–3 A | 1 | LiPo handles > 10 A | 1 | ngspice: 12 V side 1.79 A of 2 A; buck 3.1 A of 5 A | 1 | ngspice: 3.16 A of 4 A
2 | No batteries to charge, replace or monitor | 0 | ~500 mAh, voltage drops as it drains | 0 | Two packs to keep charged | 0 | Needs balance charging | 1 | Wall power | 1 | Wall power
3 | One power source for the whole robot | 1 | One battery | 0 | Two packs (servos and Uno) | 1 | One pack | 1 | One plug | 1 | One plug
4 | No extra power board to set up | 0 | Buck must be set with a meter | 1 | 4.8 V pack, nothing to set | 0 | Buck must be set | 0 | Buck set to 5.8 V once with a meter | 1 | Fixed 5 V
5 | Servos stay ≥ 4.8 V (rated) in a stall | 0 | Battery sags below the buck's input need | 0 | 4.8 V nominal pack sags under 2.5 A | 1 | Buck holds its output | 1 | ngspice: min 5.50 V | 0 | ngspice: min 4.25 V (cord + adapter drop)
6 | Uno stays ≥ 4.5 V (16 MHz minimum) in a stall | 0 | Same sagging battery feeds VIN | 1 | Uno on its own 9 V | 1 | 7.4 V on VIN → 5 V | 1 | ngspice: 5.00 V, Uno on its own regulator | 0 | ngspice: min 4.43 V, shares the servo rail
7 | USB can stay plugged in for calibration (Serial Monitor) | 1 | Uno on VIN: switches USB power off | 1 | Uno on VIN | 1 | Uno on VIN | 1 | Uno on VIN above 6.6 V: switches USB power off | 0 | Adapter on the 5V pin: two 5 V sources fight
8 | No special charger, no fire-risk cell | 1 | Alkaline, disposable | 0 | Needs a NiMH charger | 0 | LiPo charger + fire-safe bag | 1 | None | 1 | None
9 | Power parts cost ≤ $12 | 1 | ~$3 battery + $5 buck | 0 | ~$12 cells + $2 holder + $15 charger | 0 | ~$15 pack + $20 charger + $5 buck | 0 | ~$8 adapter + $5 buck = $13 | 1 | ~$9 adapter
 | TOTAL (number of 1s)
 | Share of criteria met
 | Rank

Sheet: BOM
Bill of materials: Concept A
Prices are typical online prices (EST). Printed masses from the CAD (cad/check/mass_table.csv).
Type | Part no. | Item | Spec / material | Qty | Source | Unit $ (EST) | Line $ | Mass (g) | What it does / used for | Why we need it | Alternative considered → why not
designed | CA-101 | Base | PETG | 1 | 3D print |  |  | 101.9 | Bearing tower, MG996R pocket, ballast pockets; sweep sector cut away | Holds the turntable and gives the robot its footprint (CG stays ≥ 39 mm inside it in every pose) | Flat plywood/acrylic plate → the tower, servo pocket and sweep cut-out would be several glued pieces
designed | CA-102 | Electronics tray | PETG | 1 | 3D print |  |  | 56.9 | Uno, buck, servo rail, button / LED / DC-jack panel | Keeps the electronics and wires out of the arm's 175° sweep | Loose on the table → wires can snag the turning arm and the button moves around
designed | CA-201 | Turret plate | PETG | 1 | 3D print |  |  | 24.4 | D plate + hub pressed into the 6807 bore, rod bosses | Puts the column's weight and tipping load on the bearing, so the servo only turns it | Column screwed to the servo horn → the servo spline carries all the bending load
designed | CA-202 | Spine | PETG | 1 | 3D print |  |  | 21.5 | Column back + lift-servo bracket | Ties the rods to the turret and holds the lift servo | Aluminium extrusion → extra cost and brackets for no gain at this load
designed | CA-203 | Top cap | PETG | 1 | 3D print |  |  | 10.5 | Captures the rod tops | Keeps the 2 rods parallel so the 4 LM6UU slide without binding | Rods held only at the bottom → they splay and the carriage jams
designed | CA-301 | Carriage + arm | PETG | 1 | 3D print |  |  | 45.8 | 4 LM6UU pockets, arm, wrist-servo bracket | One print: the arm can't work loose; bearings 43 mm apart keep the jam ratio at 0.018 | Separate arm screwed on → the joint sags under the can's 2.6 in offset
designed | CA-302 | Lift link | PETG | 1 | 3D print |  |  | 0.2 | Crank pin to carriage | Turns the lift servo's 45° swing into a 15.3 mm (0.6 in) straight lift | Printed rack and pinion → more teeth to print, more backlash
designed | CA-401 | Gripper frame | PETG | 1 | 3D print |  |  | 11.7 | Flange + 2 plates + posts | Holds the gripper servo and both finger axles on the wrist horn | Servo bracket from a kit → doesn't hold geared fingers at the right centre distance (16.2 mm)
designed | CA-402 | Finger, right | PETG | 1 | 3D print |  |  | 9.7 | Gear m1 16T + arm + curved pad | Geared to the left finger so one servo closes both arms equally and centres the can | One fixed + one moving arm → pushes the can off-centre
designed | CA-403 | Finger, left | PETG | 1 | 3D print |  |  | 9.7 | Mirror; gear has the servo-spline socket | As CA-402 | As CA-402
designed | CA-404 | Can bumper | Silicone sheet | 1 | Cut |  |  | 0.1 | Cut from the pad sheet, glued to the gripper frame | Sets how deep the can sits in the gripper, so every grip and landing is the same | No stop → grip depth varies with how the can is placed
designed | CA-900 | Tolerance coupon | PETG | 1 | 3D print |  |  | 8.2 | 6 test holes | Checks screw, rod and bearing fits on our printer before ~300 g of parts | Print the parts first → one wrong fit wastes hours of printing
purchased | CA-P01 | Arduino Uno R3 | ATmega328P board + USB cable | 1 | Kit (have) | $0 |  |  | Controller | Required by the assignment; runs the 4 servos and the button | Nano / ESP32 → no benefit, the Uno is in the kit
purchased | CA-P02 | Servo MG996R | Metal gear, 180°, 9.4 kg·cm | 1 | Amazon | $9 |  |  | Turntable (D9) | Metal gears keep the swinging arm from wobbling at the 5 in reach | SG90 → plastic gears, backlash shows up as ±0.1 in at the can
purchased | CA-P03 | Servo MG90S | Metal gear micro, 1.8 kg·cm | 2 | Amazon | $4 |  |  | Lift (D10) + wrist (D6) | Lift margin 5×, wrist 30×; metal gears so the wrist lands at 180° (500–2500 µs pulse in code) | Stepper motors → need drivers and homing switches; 270° servo → a 2nd servo type for no gain
purchased | CA-P04 | Servo SG90 | Micro, 1.6 kg·cm | 1 | Kit (have) | $0 |  |  | Gripper (D5) | A light squeeze is what we want: 0.4 N holds the can, it dents at ~8 N per arm | MG90S → stronger than needed, more risk of crushing the can
purchased | CA-P05 | Ball bearing 6807-2RS | 35 × 47 × 7 mm | 1 | Amazon / VXB | $5 |  |  | Turntable | Carries the arm's weight and tipping moment so the servo only turns it | 4 in lazy-susan → too tall, it collided with the wrist in the CAD check; servo alone → side load on the spline
purchased | CA-P06 | Linear bearing LM6UU | 6 mm ID × 12 mm OD × 19 mm | 4 | Amazon | $1 |  |  | Lift carriage | Jam ratio 0.018, the lift can't stick | Printed slide → jam ratio 0.55, it can bind
purchased | CA-P07 | Steel rod 6 mm (h6), 300 mm long | Cut to 2 × 112 mm | 1 | Amazon | $5 |  |  | Lift guide rods | Straight, hard track for the LM6UU | Printed rails → too rough and soft for the bearings
purchased | CA-P08 | Wall adapter 12 V, 2 A | Regulated, 5.5 × 2.1 mm plug | 1 | Amazon | $8 |  |  | Uno VIN + buck input | Power matrix 7/9: wall power, one plug, and the Uno keeps its own regulator (5.00 V even in a servo stall) | 5 V 4 A adapter direct → simpler (6/9) but Uno dips to 4.43 V in a stall and USB can't stay plugged in; 9 V battery → can't supply 2.5 A (4/9)
purchased | CA-P09 | Buck converter XL4015 | 5 A, set to 5.8 V | 1 | Amazon | $5 |  |  | Servo rail | Holds the servos at 5.8 V (≥ 5.5 V in a stall, ngspice) and keeps their current off the Uno's supply | No buck (5 V adapter direct) → servos sag to 4.25 V and the Uno to 4.43 V in a stall
purchased | CA-P10 | DC panel jack | 5.5 × 2.1 mm, panel mount | 1 | Amazon | $1 |  |  | Power input | Adapter plugs into the robot; no loose wires to pull out | Screw terminal → wires pull out when bumped
purchased | CA-P11 | Electrolytic capacitor | 1000 µF, ≥ 10 V | 1 | Kit (have) | $0 |  |  | Servo rail | Covers fast current steps at the servo rail (1 A for 100 µs → 0.10 V droop) | None → larger dips each time a servo starts
purchased | CA-P12 | Push button | 12 mm momentary | 1 | Kit (have) | $0 |  |  | START (D4) | Spec: one start, then no human input. A button is one wire, one pin, nothing to pair or lose | IR remote → receiver + library + batteries, stray IR can trigger it; timer → can't choose when it starts
purchased | CA-P13 | LED + 220 Ω resistor | 5 mm | 1 | Kit (have) | $0 |  |  | Status (D13) | Blinking = moving, on = done: tells you when to lift the can off before homing | Serial Monitor only → needs a laptop at the demo
purchased | CA-P14 | Mini breadboard | 170 tie points | 1 | Kit (have) | $0 |  |  | Servo rail | Splits the buck's 5.8 V to the 3 micro servos (each < 1 A, inside a contact's rating) | Soldered perfboard → harder to change while calibrating
purchased | CA-P15 | Jumper wires | M-M / M-F | 20 | Kit (have) | $0 |  |  | Signals, ground | Connects the servo signals, button and LED | Soldered wires → harder to fix
purchased | CA-P16 | Servo extension lead | 300 mm ×3 + 500 mm ×1 (mixed pack) | 4 | Amazon | $1 |  |  | Lift, wrist: 300; gripper: 500; 1 × 300 cut for the MG996R | Routed in 3D (cad/wiring/wiring_report.txt): gripper lead runs 500 mm with its 3 loops (wrist flip, lift, 90° turn), so 250 + 300 is too short; lift / wrist need 340 / 411 mm. One is cut so the MG996R's + / − go to the buck terminals | None → leads pull tight at the end of the turn; MG996R stall current would run through breadboard contacts (~1 A)
purchased | CA-P17 | Zip ties + adhesive tie mounts | 100 mm × 2.5 mm ties, 20 mm mounts | 8 | Amazon / hardware store | $0.5 |  |  | Tie points: arm beam, carriage side, back of spine, base floor, tray | Holds each lead at the rigid points so only the 3 service loops move (cad/wiring/) | Hot glue only → hard to re-route while calibrating; loose wires → snag in the 175° sweep
purchased | CA-P18 | Machine screw #6-32 × ½″ | Pan Phillips, HF kit #67675 | 8 | Have | $0 |  |  | Tray 2, spine 2, top cap 2, link 1, gear axle 1 | Threads into printed pilots, no nuts needed | Glue → can't take apart to fix or adjust
purchased | CA-P19 | Machine screw #8-32 × ½″ | Pan Phillips, HF kit #67675 | 4 | Have | $0 |  |  | MG996R flange | The MG996R's 4.6 mm flange holes fit #8 | #6 → loose in the flange
purchased | CA-P20 | Servo-bag screws | Come with the servos | 14 | With servos | $0 |  |  | Servo tabs, horns, crank | Sized for the servo tabs and horns | Kit screws → too big for the micro-servo tabs
purchased | CA-P21 | Silicone rubber sheet | 1/16 in (1.6 mm), ~6 × 6 in | 1 | Amazon | $6 |  |  | Finger pads + can bumper | Grippy pads (μ ≈ 0.6) keep the squeeze needed low (0.4 N), so the can isn't dented | Bare PETG pads → slippery, needs a harder squeeze; TPU → a second filament for 1 g of parts
purchased | CA-P22 | Steel washers + rubber feet | ~100 g of washers, 4 feet | 1 | Hardware store | $3 |  |  | Base | Weight and friction so the turning reaction doesn't slide the base | Clamp to the table → the demo table may not allow it
purchased | CA-P23 | PETG filament | 1.75 mm, ~0.35 kg | 1 | Have | $0 |  |  | Printed parts | Tougher than PLA and creeps less under the press fits (bearing, LM6UU, rods) | PLA → press fits loosen over time
 |  | Total spend beyond what we have
 |  | Printed PETG (robot parts, excl. coupon)
