jackpham-rgb/MEproject2026F/cad/step/concept_a_assembly.step

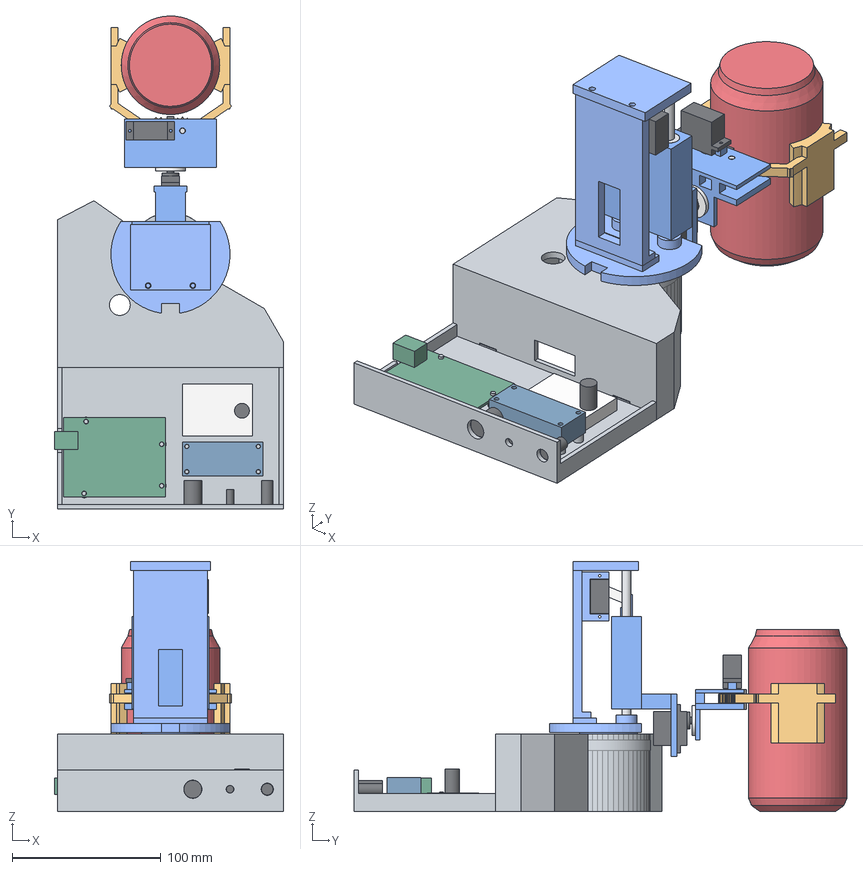
[picture p34: CAD file, 2026-11-05]
cad/step/concept_a_assembly.step
154.0 x 331.1 x 168.0 mm
base
electronics_tray
bearing_6807
turntable_servo_MG996R
arduino_uno
buck_XL4015
mini_breadboard
capacitor_1000uF
start_button
status_led
dc_jack
turret_plate
turntable_horn
rod_L
rod_R
spine
top_cap
lift_servo_MG90S
lift_crank
carriage_arm
LM6UU_L1
LM6UU_L2
LM6UU_R1
LM6UU_R2
lift_link
wrist_servo
wrist_horn
gripper_frame
can_bumper
gripper_servo_SG90
axle_R
finger_R
finger_L
test_can
