jackpham-rgb/MEproject2026F/cad/claw/claw.step

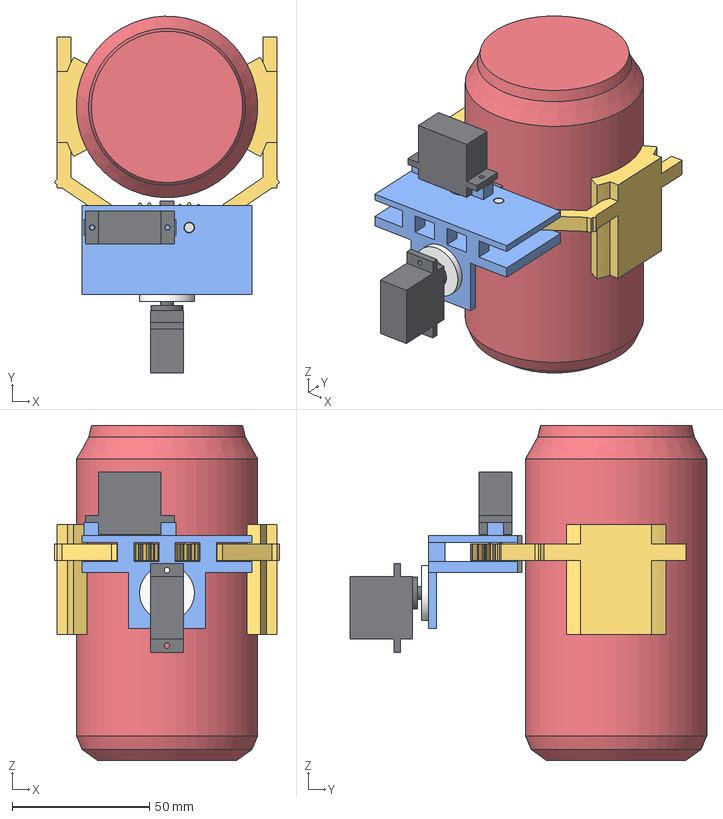
[picture p35: CAD file, 2026-11-03]
cad/claw/claw.step
82.1 x 130.1 x 122.2 mm
gripper_frame
can_bumper
gripper_servo_SG90
axle_R
wrist_horn
wrist_servo
finger_L
finger_R
test_can
