jackpham-rgb/MEproject2026F/cad/print/plates/plate0_coupon.3mf

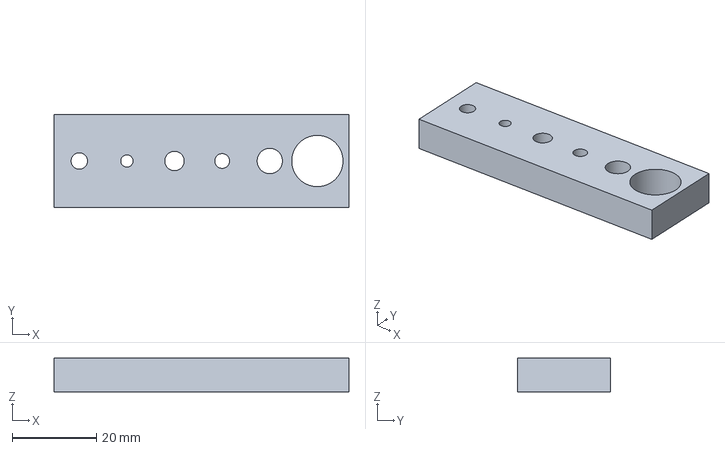
[picture p36: CAD file, 2026-11-08]
cad/print/plates/plate0_coupon.3mf
70.0 x 22.0 x 8.00 mm
