jackpham-rgb/MEproject2026F/cad/print/stl/CA-101_base.stl

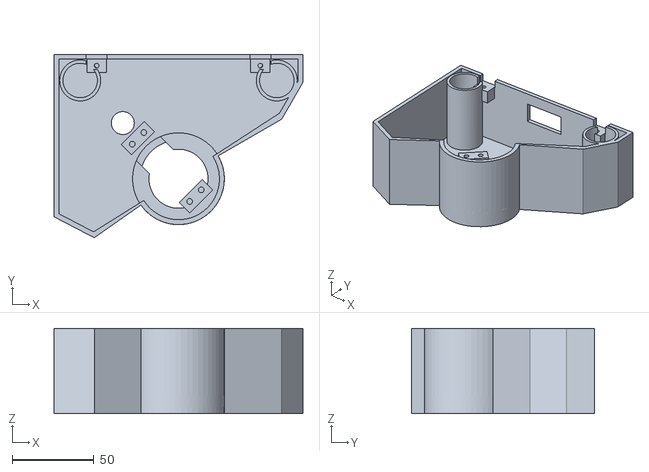
[picture p37: CAD file, 2026-11-05]
cad/print/stl/CA-101_base.stl
152.0 x 112.0 x 52.0
