jackpham-rgb/MEproject2026F/cad/step/parts/lift_link.step

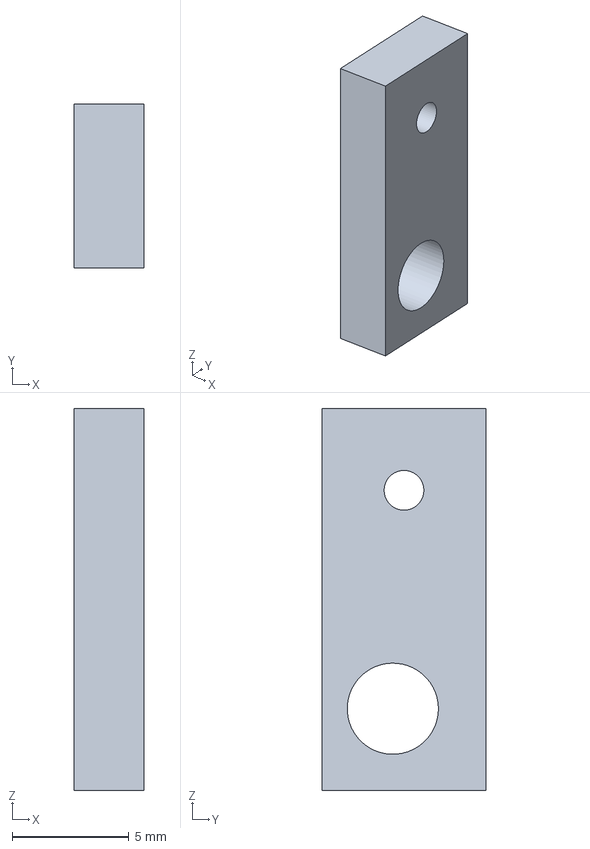
[picture p38: CAD file, 2026-11-05]
cad/step/parts/lift_link.step
3.00 x 7.00 x 16.3 mm
