jackpham-rgb/MEproject2026F/cad/wiring/wiring_harness.step

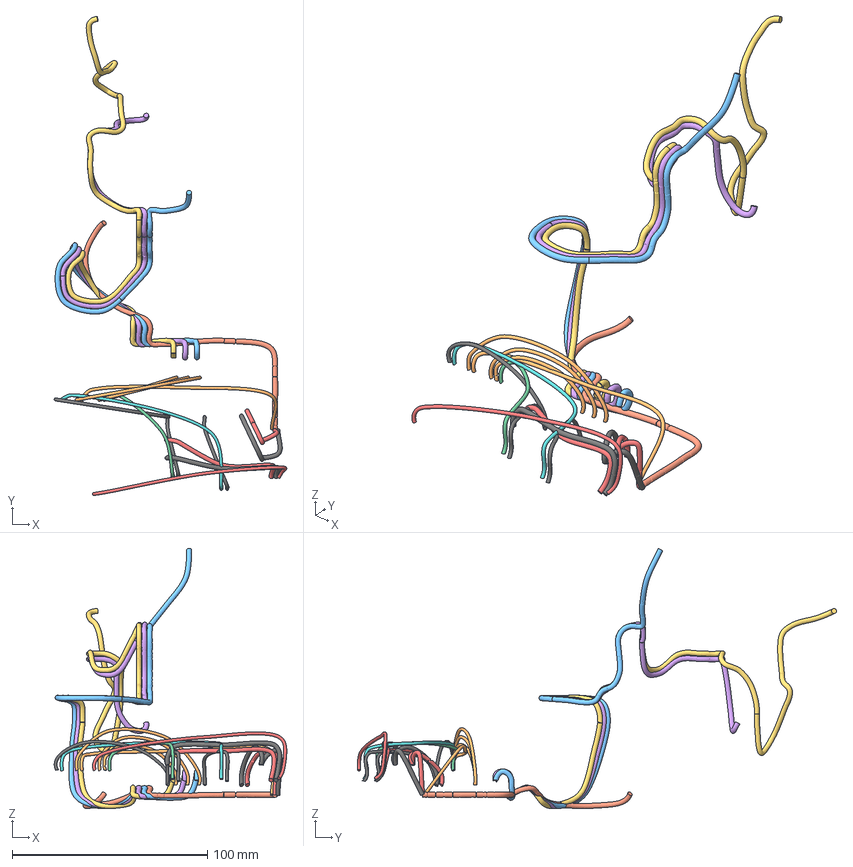
[picture p39: CAD file, 2026-11-05]
cad/wiring/wiring_harness.step
119.3 x 245.6 x 133.3 mm
w00_SG90_gripper_lead__D5_
w01_Wrist_servo_lead__D6_
w02_MG90S_lift_lead__D10_
w03_MG996R_turntable_lead__D9__power_on_the_
w04_MG996R___to_buck_OUT_
w05_MG996R___to_buck_OUT_
w06_MG996R_signal_to_D9
w07_grip_signal_jumper_to_D5
w08_wrist_signal_jumper_to_D6
w09_lift_signal_jumper_to_D10
w10_buck_OUT__to_servo_rail
w11_buck_OUT__to_rail__
w12_Uno_GND_to_rail__
w13_12_V_jack___to_buck_IN_
w14_12_V_jack___to_buck_IN_
w15_12_V_jack___to_Uno_VIN
w16_START_button_to_D4
w17_START_button_to_GND_rail
w18_status_LED_to_D13
w19_status_LED_to_GND_rail
