jackpham-rgb/MEproject2026F/cad/print/plates/plate3_arm_claw.3mf

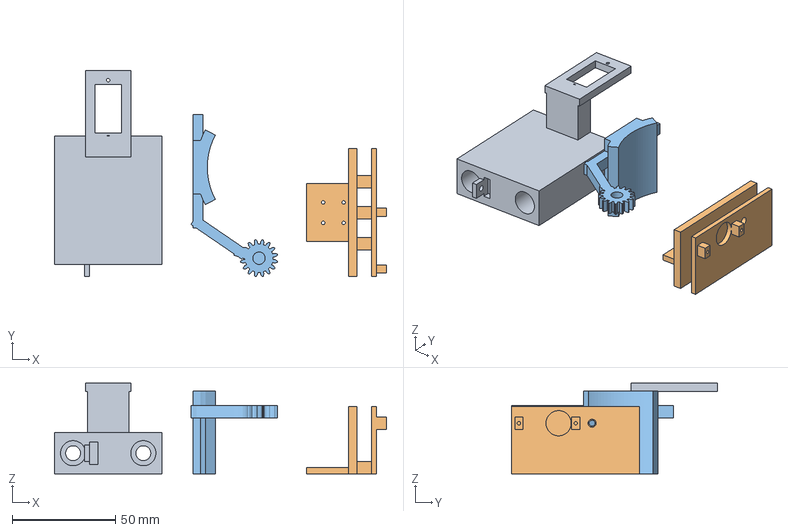
[picture p40: CAD file, 2026-11-08]
cad/print/plates/plate3_arm_claw.3mf
160.6 x 99.9 x 43.9 mm
CA-301 Carriage + arm
CA-401 Gripper frame
CA-403 Finger, left
