jackpham-rgb/MEproject2026F/cad/print/stl/CA-301_carriage_arm.stl

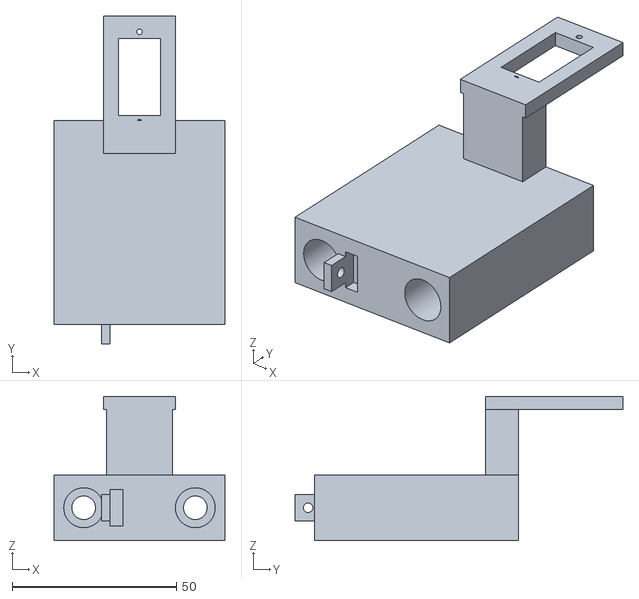
[picture p41: CAD file, 2026-11-05]
cad/print/stl/CA-301_carriage_arm.stl
52.0 x 99.9 x 43.9
