jackpham-rgb/MEproject2026F/cad/step/parts/finger_R.step

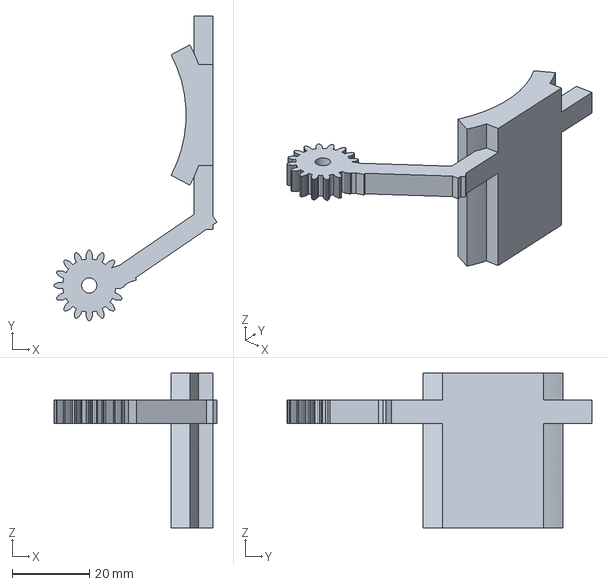
[picture p42: CAD file, 2026-11-05]
cad/step/parts/finger_R.step
42.1 x 78.6 x 40.0 mm
