jackpham-rgb/MEproject2026F/cad/print/plates/planP_1_claw.3mf

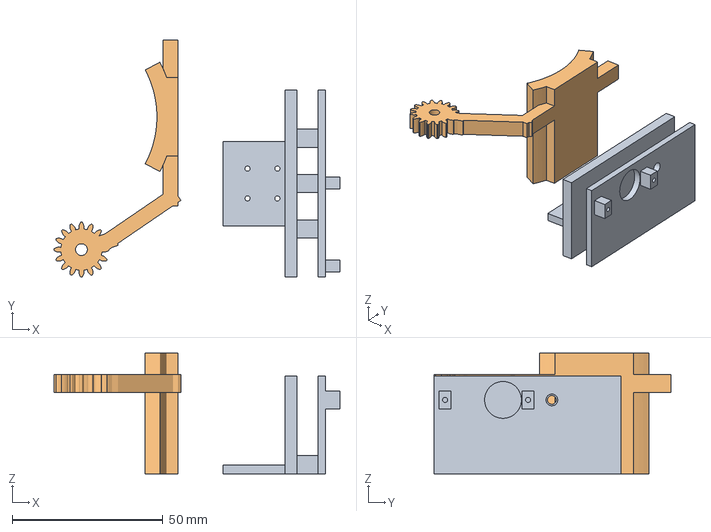
[picture p43: CAD file, 2026-11-08]
cad/print/plates/planP_1_claw.3mf
94.8 x 78.6 x 40.0 mm
CA-401 Gripper frame
CA-402 Finger, right
