jackpham-rgb/MEproject2026F/cad/print/stl/CA-401_gripper_frame.stl

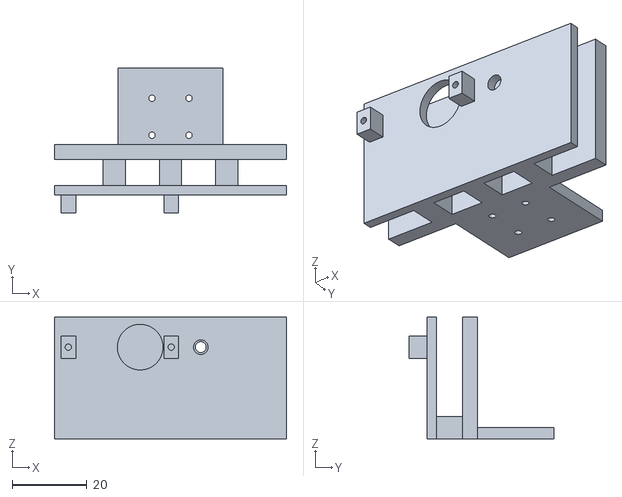
[picture p44: CAD file, 2026-11-05]
cad/print/stl/CA-401_gripper_frame.stl
62.0 x 38.7 x 32.5
