jackpham-rgb/MEproject2026F/cad/step/parts/LM6UU_R1.step

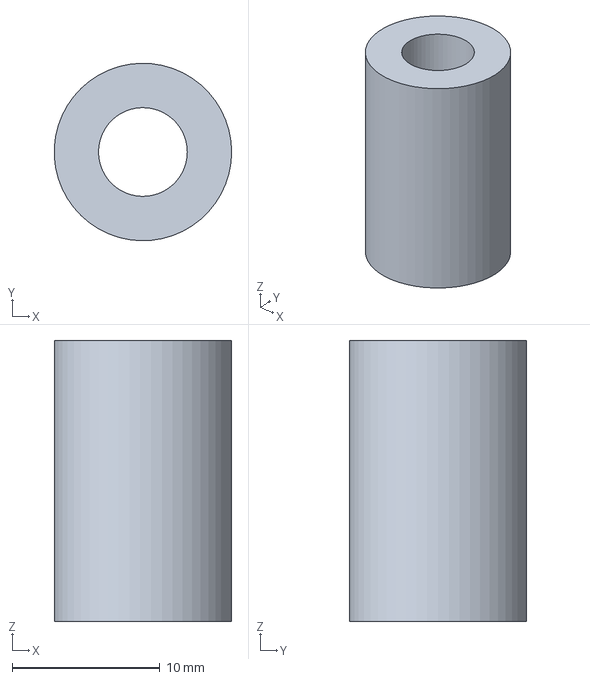
[picture p45: CAD file, 2026-11-05]
cad/step/parts/LM6UU_R1.step
12.0 x 12.0 x 19.0 mm
