jackpham-rgb/MEproject2026F/cad/print/plates/planP_2_finger.3mf

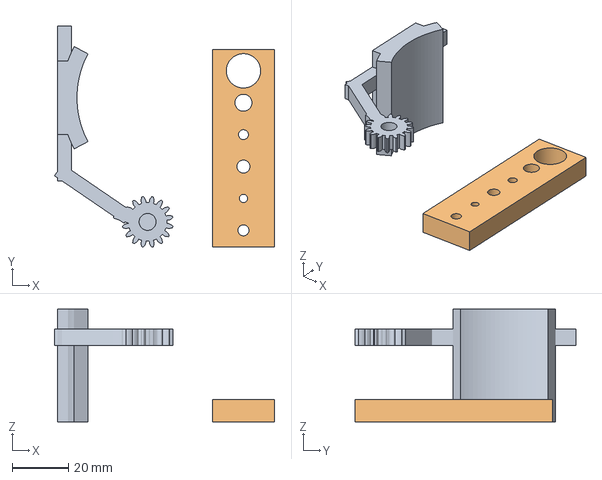
[picture p46: CAD file, 2026-11-08]
cad/print/plates/planP_2_finger.3mf
77.9 x 78.5 x 40.0 mm
CA-403 Finger, left
CA-900 Tolerance coupon
