jackpham-rgb/MEproject2026F/cad/print/stl/CA-202_spine.stl

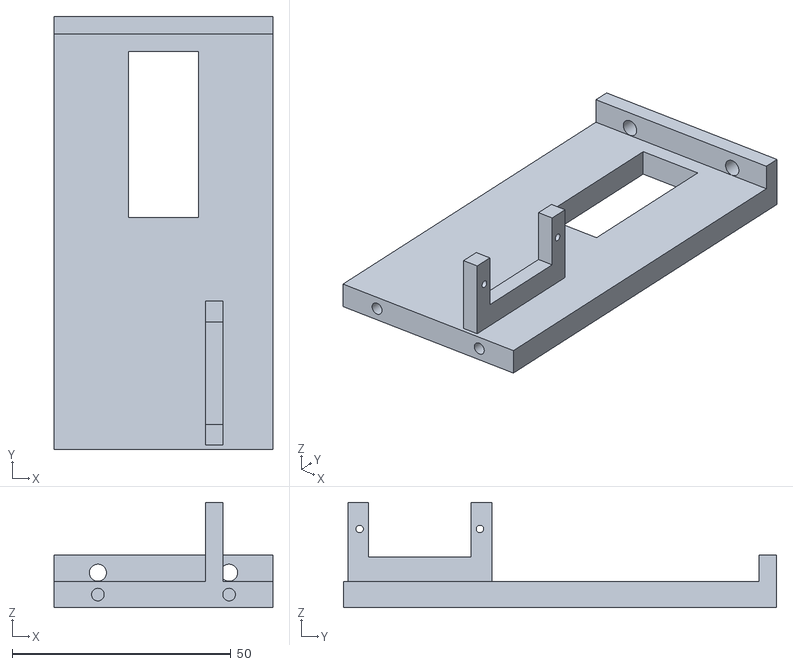
[picture p47: CAD file, 2026-11-05]
cad/print/stl/CA-202_spine.stl
50.0 x 99.0 x 24.1
