jackpham-rgb/MEproject2026F/cad/step/parts/axle_R.step

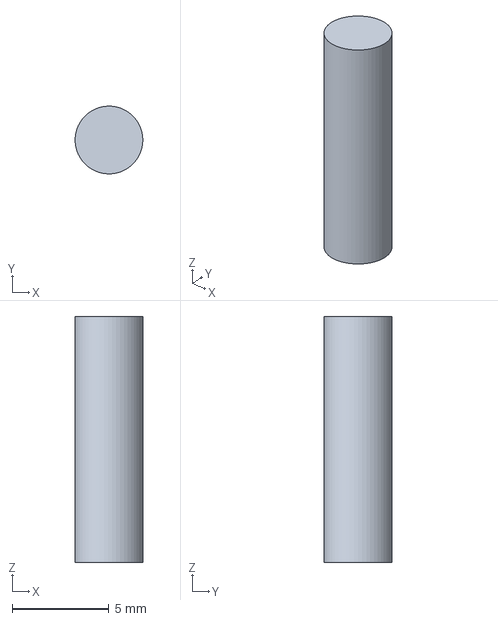
[picture p48: CAD file, 2026-11-05]
cad/step/parts/axle_R.step
3.50 x 3.50 x 12.7 mm
