jackpham-rgb/MEproject2026F/cad/print/plates/plate1_base.3mf

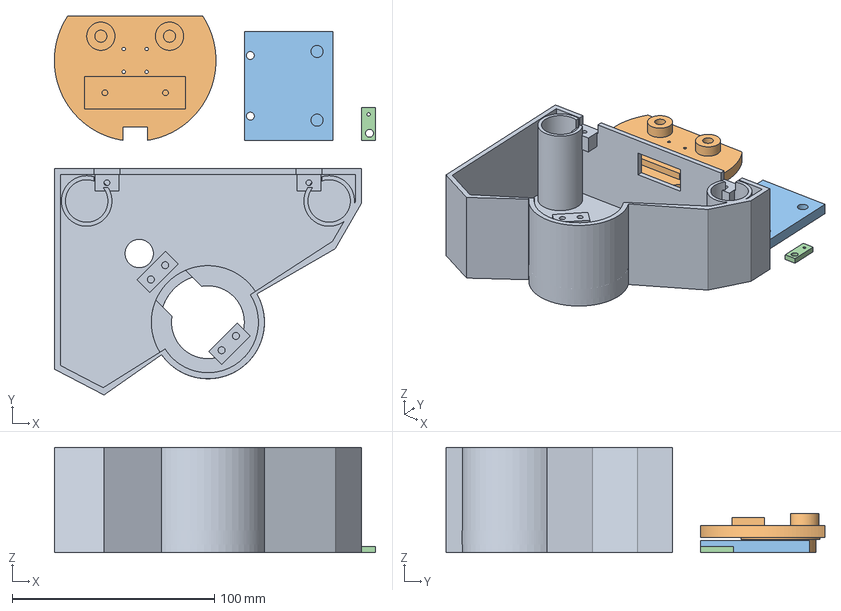
[picture p49: CAD file, 2026-11-08]
cad/print/plates/plate1_base.3mf
159.0 x 187.6 x 52.0 mm
CA-101 Base
CA-201 Turret plate
CA-203 Top cap
CA-302 Lift link
