jackpham-rgb/MEproject2026F/cad/print/stl/CA-102_electronics_tray.stl

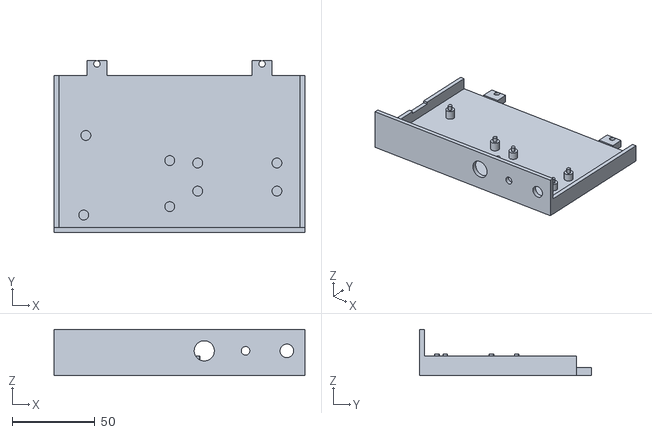
[picture p50: CAD file, 2026-11-05]
cad/print/stl/CA-102_electronics_tray.stl
152.0 x 104.0 x 28.0
