jackpham-rgb/MEproject2026F/cad/step/parts/rod_R.step

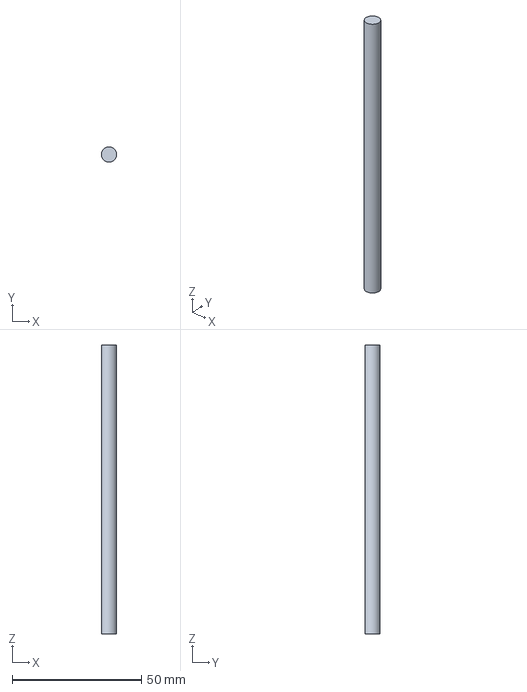
[picture p51: CAD file, 2026-11-05]
cad/step/parts/rod_R.step
5.97 x 5.98 x 112.0 mm
