jackpham-rgb/MEproject2026F/cad/print/plates/plate2_tray_spine.3mf

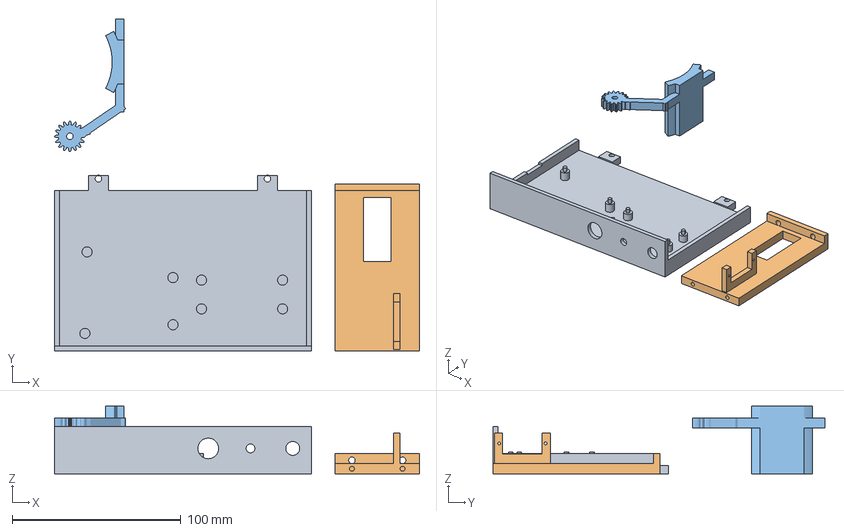
[picture p52: CAD file, 2026-11-08]
cad/print/plates/plate2_tray_spine.3mf
216.0 x 196.6 x 40.0 mm
CA-102 Electronics tray
CA-202 Spine
CA-402 Finger, right
