jackpham-rgb/MEproject2026F/cad/print/stl/CA-403_finger_L.stl

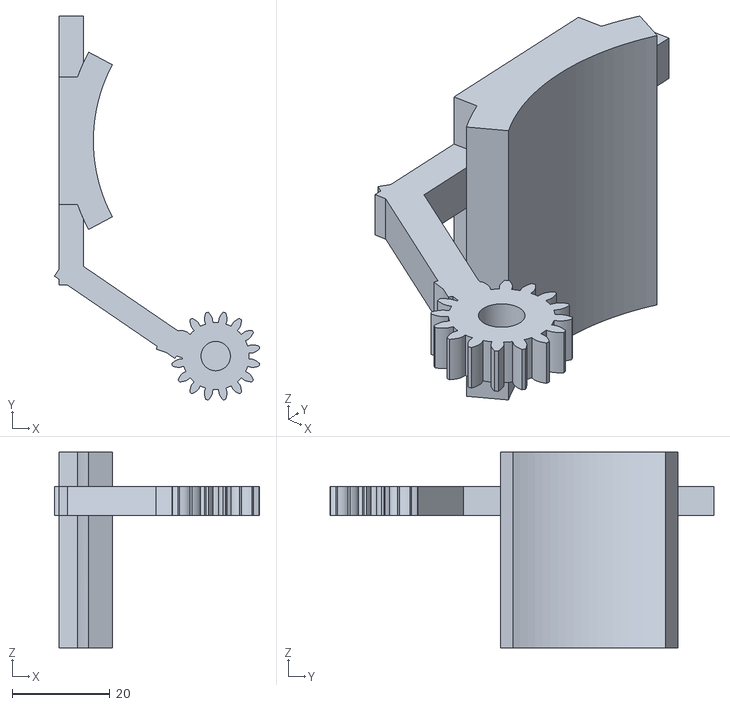
[picture p53: CAD file, 2026-11-03]
cad/print/stl/CA-403_finger_L.stl
41.9 x 78.5 x 40.0
