jackpham-rgb/MEproject2026F/cad/step/parts/capacitor_1000uF.step

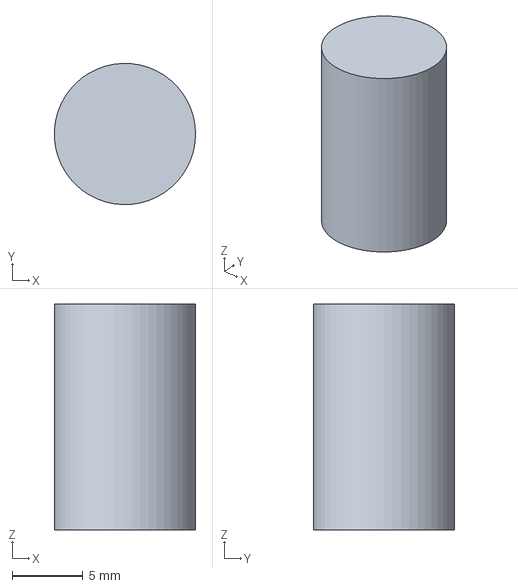
[picture p54: CAD file, 2026-11-05]
cad/step/parts/capacitor_1000uF.step
9.99 x 10.00 x 16.0 mm
