jackpham-rgb/MEproject2026F/cad/step/parts/start_button.step

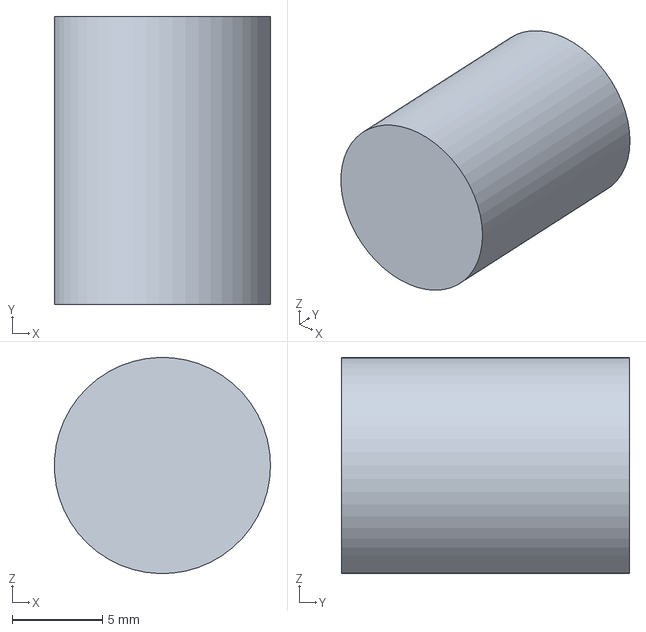
[picture p55: CAD file, 2026-11-05]
cad/step/parts/start_button.step
12.0 x 16.0 x 12.0 mm
