jackpham-rgb/MEproject2026F/cad/print/stl/CA-203_top_cap.stl

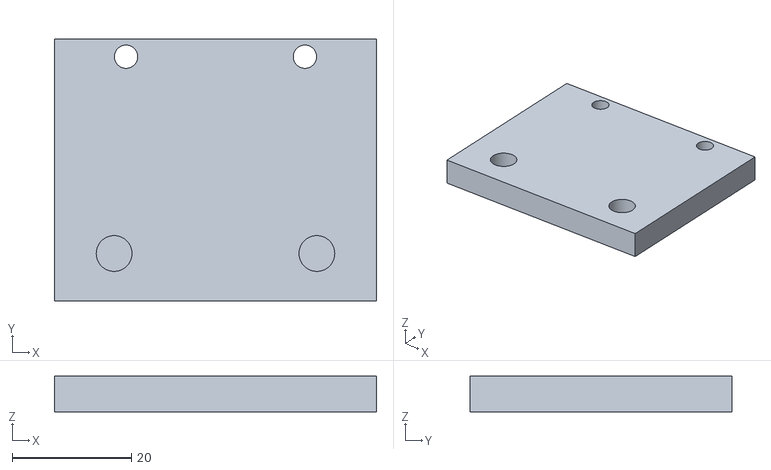
[picture p56: CAD file, 2026-11-02]
cad/print/stl/CA-203_top_cap.stl
54.0 x 44.0 x 6.00
