jackpham-rgb/MEproject2026F/cad/print/stl/CA-201_turret_plate.stl

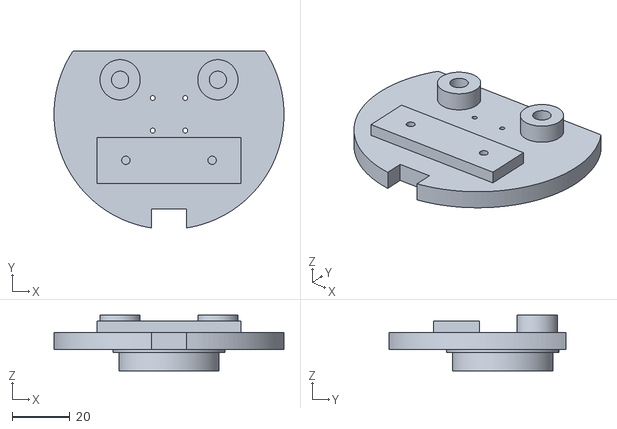
[picture p57: CAD file, 2026-11-02]
cad/print/stl/CA-201_turret_plate.stl
80.0 x 61.5 x 19.4
