jackpham-rgb/MEproject2026F/cad/step/parts/status_led.step

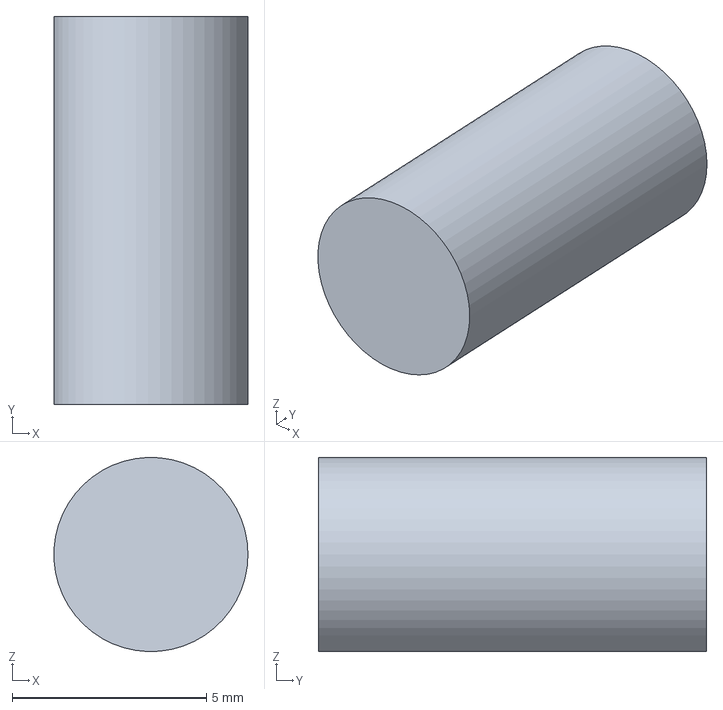
[picture p58: CAD file, 2026-11-05]
cad/step/parts/status_led.step
5.00 x 10.0 x 5.00 mm
