jackpham-rgb/MEproject2026F/cad/step/parts/turntable_horn.step

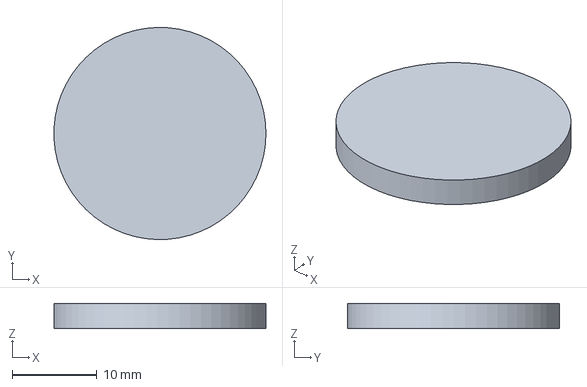
[picture p59: CAD file, 2026-11-05]
cad/step/parts/turntable_horn.step
25.0 x 25.0 x 3.00 mm
