jackpham-rgb/MEproject2026F/cad/step/parts/wrist_horn.step

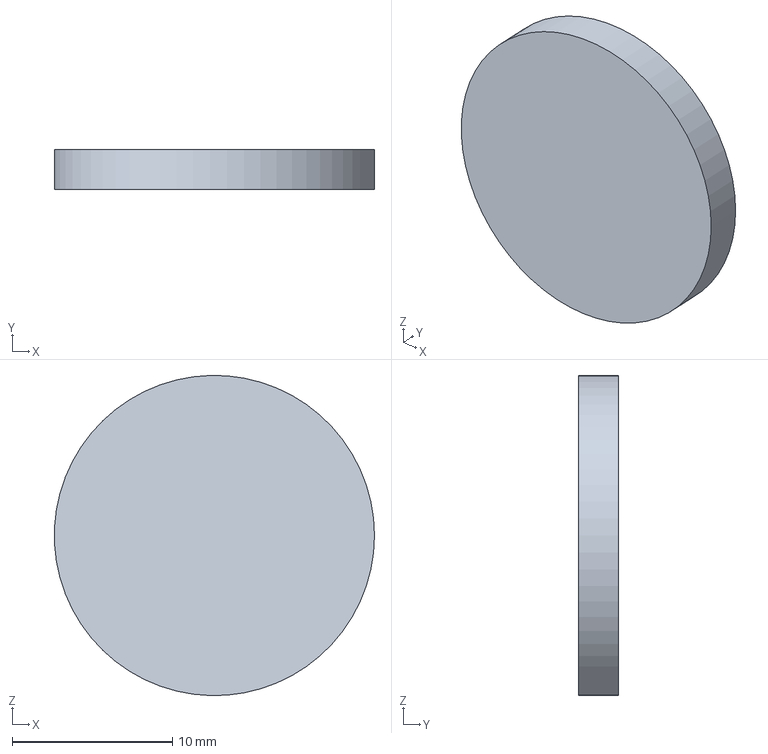
[picture p60: CAD file, 2026-11-05]
cad/step/parts/wrist_horn.step
20.0 x 2.50 x 20.0 mm
