jackpham-rgb/MEproject2026F/cad/step/parts/gripper_servo_SG90.step

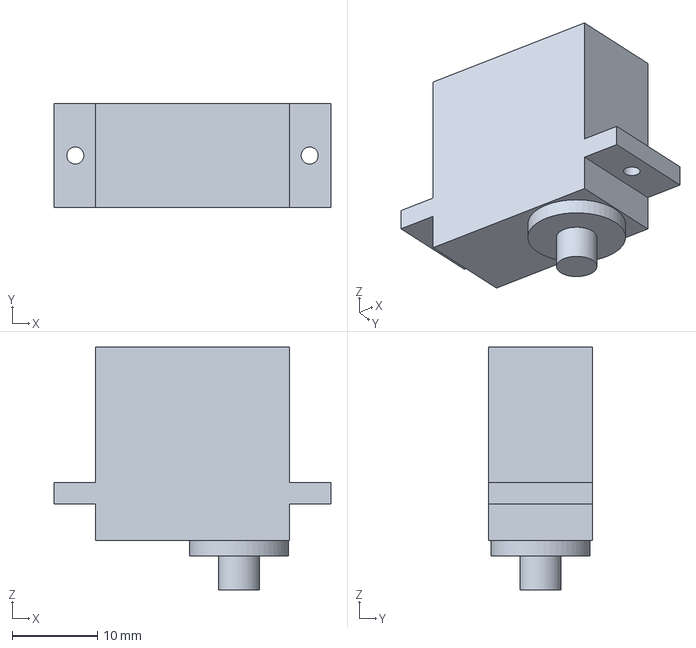
[picture p61: CAD file, 2026-11-05]
cad/step/parts/gripper_servo_SG90.step
32.5 x 12.2 x 28.5 mm
