jackpham-rgb/MEproject2026F/cad/step/parts/turntable_servo_MG996R.step

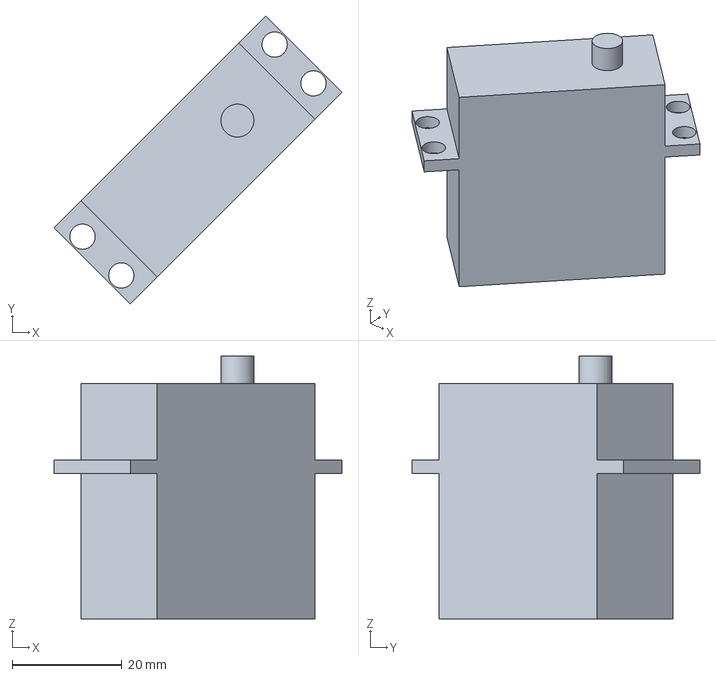
[picture p62: CAD file, 2026-11-05]
cad/step/parts/turntable_servo_MG996R.step
52.5 x 52.5 x 47.9 mm
