jackpham-rgb/MEproject2026F/cad/step/parts/wrist_servo.step

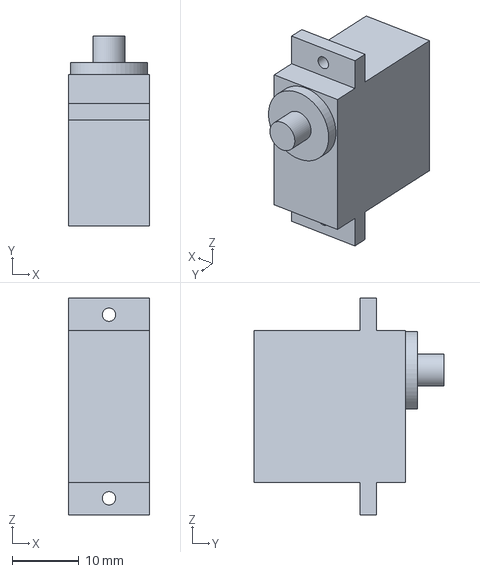
[picture p63: CAD file, 2026-11-05]
cad/step/parts/wrist_servo.step
12.2 x 28.5 x 32.5 mm
