jackpham-rgb/MEproject2026F/cad/step/parts/lift_crank.step

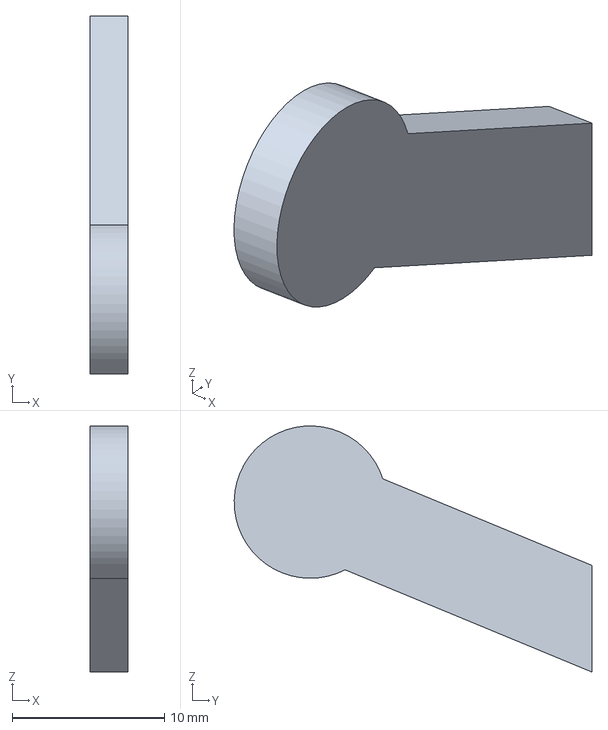
[picture p64: CAD file, 2026-11-05]
cad/step/parts/lift_crank.step
2.50 x 23.5 x 16.1 mm
