jackpham-rgb/MEproject2026F/cad/step/parts/mini_breadboard.step

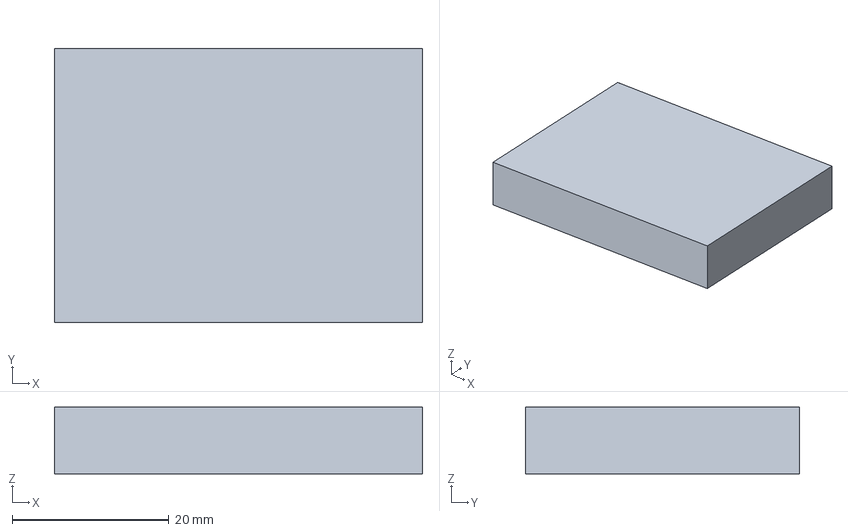
[picture p65: CAD file, 2026-11-05]
cad/step/parts/mini_breadboard.step
47.0 x 35.0 x 8.50 mm
