jackpham-rgb/MEproject2026F/cad/step/parts/can_bumper.step

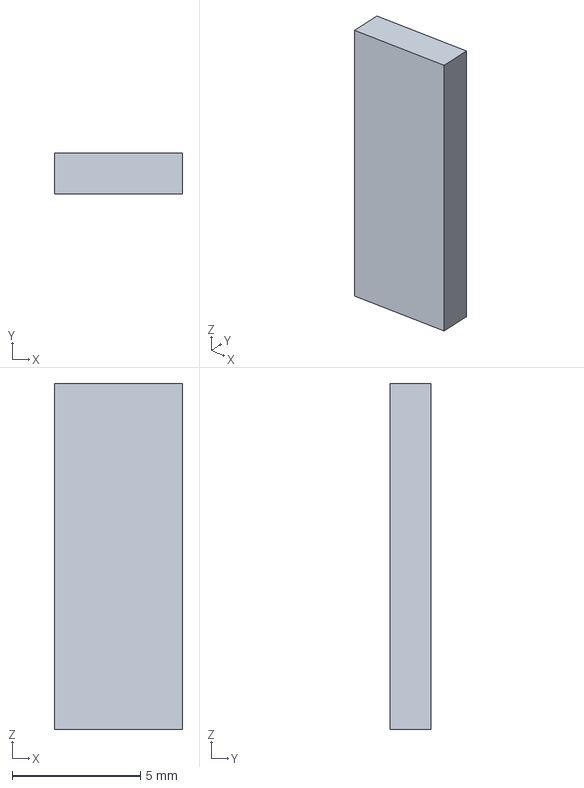
[picture p66: CAD file, 2026-11-05]
cad/step/parts/can_bumper.step
5.00 x 1.60 x 13.5 mm
