jackpham-rgb/MEproject2026F/cad/step/parts/dc_jack.step

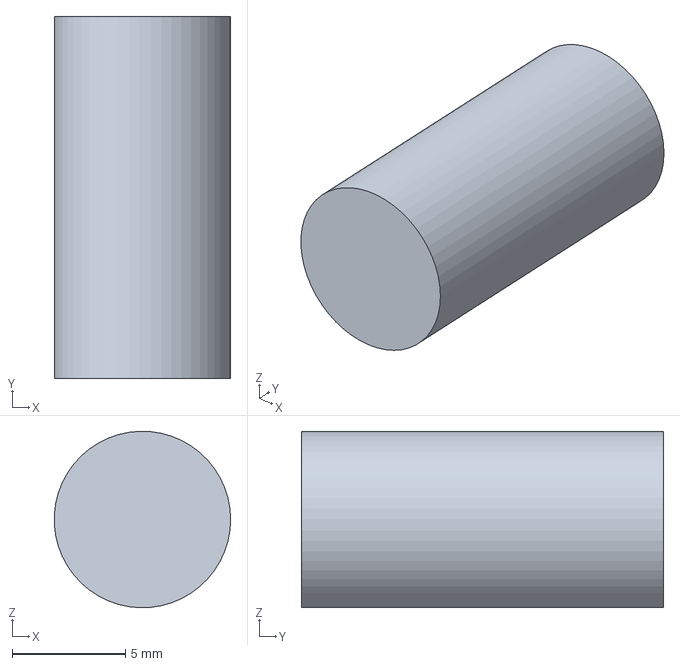
[picture p67: CAD file, 2026-11-05]
cad/step/parts/dc_jack.step
7.79 x 16.0 x 7.80 mm
