jackpham-rgb/MEproject2026F/cad/step/parts/buck_XL4015.step

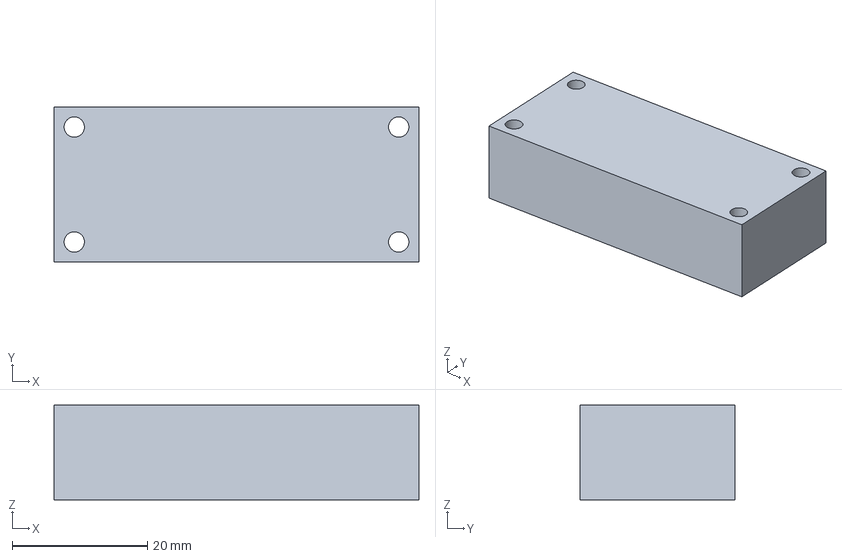
[picture p68: CAD file, 2026-11-05]
cad/step/parts/buck_XL4015.step
54.0 x 23.0 x 14.0 mm
