jackpham-rgb/MEproject2026F/cad/step/parts/test_can.step

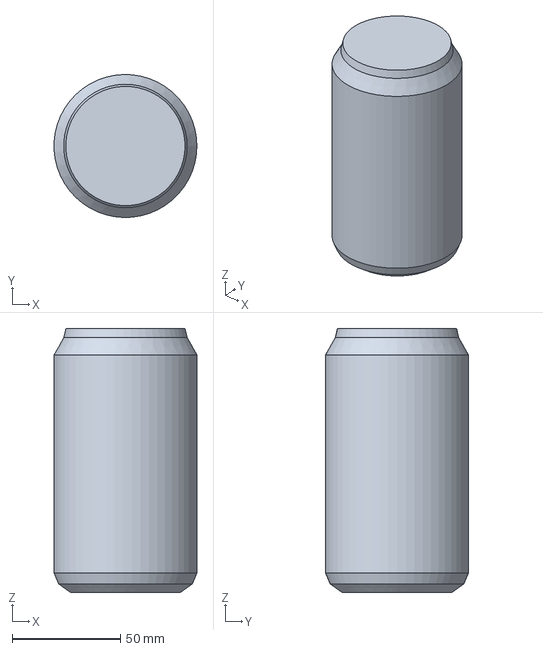
[picture p69: CAD file, 2026-11-05]
cad/step/parts/test_can.step
66.1 x 66.2 x 122.2 mm
