jackpham-rgb/MEproject2026F/cad/step/parts/bearing_6807.step

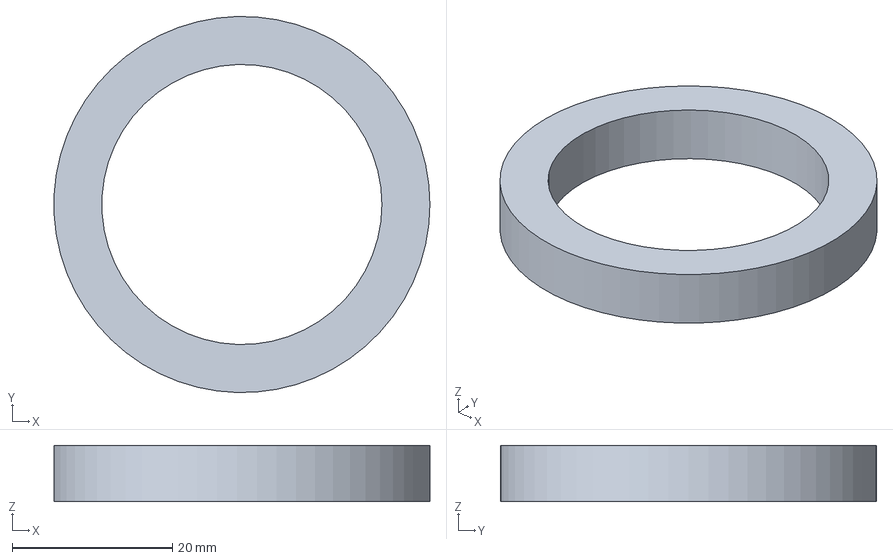
[picture p70: CAD file, 2026-11-05]
cad/step/parts/bearing_6807.step
47.0 x 47.0 x 7.00 mm
