jackpham-rgb/MEproject2026F/cad/step/parts/arduino_uno.step

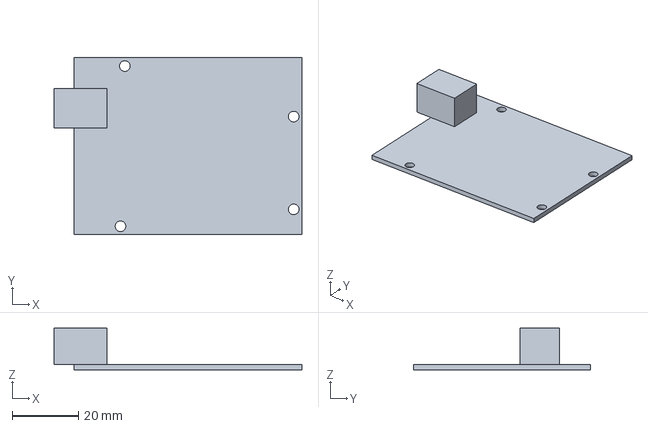
[picture p71: CAD file, 2026-11-05]
cad/step/parts/arduino_uno.step
74.6 x 53.3 x 12.6 mm
