jackpham-rgb/MEproject2026F/(list of files, cad)

Other CAD files:
cad/print/stl/CA-402_finger_R.stl
cad/step/parts/LM6UU_L1.step
cad/print/stl/CA-900_tolerance_coupon.stl
cad/step/parts/finger_L.step
cad/print/stl/CA-302_lift_link.stl
cad/step/parts/LM6UU_R2.step
cad/step/parts/tolerance_coupon.step
cad/step/parts/LM6UU_L2.step
cad/step/parts/turret_plate.step
cad/step/parts/spine.step
cad/step/parts/top_cap.step
cad/step/parts/electronics_tray.step
cad/step/parts/base.step
cad/step/parts/gripper_frame.step
cad/step/parts/rod_L.step
cad/step/parts/carriage_arm.step
cad/step/parts/lift_servo_MG90S.step
cad/print/plates/planP_1_claw.stl
cad/print/plates/planP_2_finger.stl
cad/print/plates/plate0_coupon.stl
cad/print/plates/plate1_base.stl
cad/print/plates/plate2_tray_spine.stl
cad/print/plates/plate3_arm_claw.stl
