jackpham-rgb/MEproject2026F/docs/08_build_guide.md

# Build Guide: Concept A

Everything needed to go from files to a running robot, in order. Generated by `backend/tools/make_build_guide.py` from the BOM and the print files.

**Order of work:** buy → print the coupon → adjust fits → print the rest → set the buck → assemble with the servo-setup sketch → wire → calibrate → test.

## 1. Shopping list

For prototype v1 with the real cart prices, links and what to look for at home first, see [11_bom_prototype_v1.md](11_bom_prototype_v1.md).

### Must buy

| ✓ | Part no. | Item | Qty | Search for | Note |
|---|---|---|---:|---|---|
| ☐ | CA-P02 | Servo MG996R (Metal gear, 180°, 9.4 kg·cm) | 1 | MG996R metal gear servo 180 degree |  |
| ☐ | CA-P03 | Servo MG90S (Metal gear micro, 1.8 kg·cm) | 2 | MG90S metal gear micro servo (2-pack is usually cheaper) |  |
| ☐ | CA-P05 | Ball bearing 6807-2RS (35 × 47 × 7 mm) | 1 | 6807-2RS bearing 35x47x7 | A skateboard / fidget-spinner bearing (608, 22 mm) is too small for the 47 mm pocket |
| ☐ | CA-P06 | Linear bearing LM6UU (6 mm ID × 12 mm OD × 19 mm) | 4 | LM6UU linear bearing 6mm (packs of 4-12) | Buy together with the rod so they fit each other |
| ☐ | CA-P07 | Steel rod 6 mm (h6), 300 mm long (Cut to 2 × 112 mm) | 1 | 6mm linear rod 300mm (chrome / hardened) | Must be hard steel, exactly 6.00 mm: a hardware-store 1/4 in rod is 6.35 mm and won't enter the LM6UU; an aluminium knitting needle is too soft. **Free option:** a dead inkjet printer, scanner or 3D printer often has 6 mm smooth steel rods (need ≥ 112 mm, measure first) |
| ☐ | CA-P09 | Buck converter XL4015 (5 A, set to 5.8 V) | 1 | XL4015 5A buck converter (with screw terminals) | An old 5 V phone charger can't safely take the MG996R stall current (EE/README.md) |

Buy one spare MG90S if the price difference is small: the wrist servo is the one most likely to fall short of 180°. Rod + LM6UU: a set sold together fits for sure.

### Buy, or use something from home

| ✓ | Part no. | Item | Qty | Household swap | Watch out | Or search for |
|---|---|---|---:|---|---|---|
| ☐ | CA-P08 | Wall adapter 12 V, 2 A (Regulated, 5.5 × 2.1 mm plug) | 1 | An old router / monitor / LED-strip / speaker adapter | Label: **12 V, ≥ 1.5 A**, round 5.5 × 2.1 mm plug, centre pin + (⊖–●–⊕) | 12V 2A power adapter 5.5x2.1mm |
| ☐ | CA-P10 | DC panel jack (5.5 × 2.1 mm, panel mount) | 1 | Salvaged from a dead gadget | Must take a 5.5 × 2.1 mm plug. Don't feed the buck from the Uno's VIN pin instead (its 1 A diode) | DC-022 panel mount jack 5.5x2.1mm |
| ☐ | CA-P16 | Servo extension lead (300 mm ×3 + 500 mm ×1 (mixed pack)) | 4 | Chains of M-F jumper wires from the kit | Works, but 20 jumpers won't cover it all; keep every joint in a tied run (never in a loop) and tape it. Gripper needs ~270 mm added | servo extension cable assorted 300mm 500mm (JR/Futaba) |
| ☐ | CA-P17 | Zip ties + adhesive tie mounts (100 mm × 2.5 mm ties, 20 mm mounts) | 8 | Bread twist ties, ties from packaging, electrical / masking tape, hot glue | Tie only at the tie points; the 3 loops must hang free | small zip ties + adhesive mounts kit |
| ☐ | CA-P21 | Silicone rubber sheet (1/16 in (1.6 mm), ~6 × 6 in) | 1 | Bike inner tube, wide rubber band over each pad, non-slip shelf liner, cut-up silicone phone case | Keep it 1–2 mm thick; grip has a 5.4× slip margin, so any grippy rubber works. Re-check the closed angle with servo_setup | silicone rubber sheet 1/16 inch 40A-60A |
| ☐ | CA-P22 | Steel washers + rubber feet (~100 g of washers, 4 feet) | 1 | Weight: rocks, coins (pennies fit, quarters don't), nuts / bolts, fishing weights (~100 g). Feet: hot-glue dots, mouse-pad or shelf-liner pieces | The corner pockets (21 mm wide) are open underneath: **hot-glue or tape the weight to the base**, or it just sits on the table and does nothing. A big rock can be glued to the tray floor between the Uno and the base wall. Not on the base top (turn loop + arm sweep). Feet are optional (uses 1–2 % of bare-plastic friction) | 1/4 in or M6 flat washers (bulk) + adhesive rubber feet |

Everything on both lists bought new ≈ $62 (typical online prices, EST); with the household swaps only the must-buy list is needed.

Already have (check before you start):

- ☐ Arduino Uno R3 × 1 (ATmega328P board + USB cable)
- ☐ Servo SG90 × 1 (Micro, 1.6 kg·cm)
- ☐ Electrolytic capacitor × 1 (1000 µF, ≥ 10 V)
- ☐ Push button × 1 (12 mm momentary)
- ☐ LED + 220 Ω resistor × 1 (5 mm)
- ☐ Mini breadboard × 1 (170 tie points)
- ☐ Jumper wires × 20 (M-M / M-F)
- ☐ Machine screw #6-32 × ½″ × 8 (Pan Phillips, HF kit #67675)
- ☐ Machine screw #8-32 × ½″ × 4 (Pan Phillips, HF kit #67675)
- ☐ Servo-bag screws × 14 (Come with the servos)
- ☐ PETG filament × 1 (1.75 mm, ~0.35 kg)

**Tools:** Phillips #1 and #2 screwdrivers, multimeter, hot-glue gun, wire stripper, small flat screwdriver (buck pot and terminals), hacksaw or rotary tool (cut the 6 mm rod), file, a vise or clamp (pressing the bearing), superglue (silicone liners), a 12 mm drill bit turned by hand (to ream the LM6UU seats if tight).

## 2. Printing

**Print by plate:** `cad/print/plates/plate0_coupon` → `plate1_base` (overnight) → `plate2_tray_spine` → `plate3_arm_claw` (.3mf keeps every part separate; layout in `cad/print/plates/plates.png`). **Settings:** `cad/print/settings/printer_settings.txt` (all slicers) and `concept_a_PETG_prusaslicer.ini` (PrusaSlicer: File → Import → Import Config, then set the Printer preset back to Creality CR-6 SE). The .3mf files already carry the per-part settings (supports, 100 % infill fingers, brim on the link): every plate was test-sliced in PrusaSlicer.

Single parts: `cad/print/stl/` (already turned to the best side). Orientation preview: `cad/print/print_orientations.png`. Printer: Creality CR-6 SE, 235 × 235 mm bed.

**PETG settings (start here, tune for your printer):** nozzle 0.4 mm at 235 °C, bed 80 °C, layer 0.2 mm, 3 walls (1.2 mm), 4 top / 4 bottom layers, 30 % gyroid infill, cooling fan 30–50 %, elephant-foot compensation 0.15 mm (holes on the bed side), print speed ~60 mm/s. Use glue stick on smooth PEI so PETG doesn't weld to the bed.

| Order | Part no. | Part | Qty | Lay it on the bed with | Size on bed (mm) | Supports | PETG (g) | ≈ hours |
|---:|---|---|---:|---|---|---|---:|---:|
| 1 | CA-900 | Tolerance coupon | 1 | -Z (as modelled, bottom down) | 70 × 22 × 8 | none | 8.2 | 0.8 |
| 2 | CA-101 | Base | 1 | +Z (upside down, top face down) | 152 × 112 × 52 | yes: supports on build plate | 101.9 | 9.8 |
| 3 | CA-102 | Electronics tray | 1 | -Z (as modelled, bottom down) | 152 × 104 × 28 | none | 56.9 | 5.5 |
| 4 | CA-201 | Turret plate | 1 | -Z (as modelled, bottom down) | 80 × 62 × 19 | yes: supports on build plate | 24.4 | 2.3 |
| 5 | CA-202 | Spine | 1 | -Y face down | 50 × 99 × 24 | none | 21.5 | 2.1 |
| 6 | CA-203 | Top cap | 1 | +Z (upside down, top face down) | 54 × 44 × 6 | none | 10.5 | 1.0 |
| 7 | CA-301 | Carriage + arm | 1 | -Y face down | 52 × 100 × 44 | yes: supports on build plate | 45.8 | 4.4 |
| 8 | CA-302 | Lift link | 1 | +X face down | 16 × 7 × 3 | none | 0.2 | 0.3 |
| 9 | CA-401 | Gripper frame | 1 | -Y face down | 62 × 39 × 33 | none | 11.7 | 1.1 |
| 10 | CA-402 | Finger, right | 1 | -Z (as modelled, bottom down) | 42 × 79 × 40 | yes: supports on build plate | 9.7 | 0.9 |
| 11 | CA-403 | Finger, left | 1 | -Z (as modelled, bottom down) | 42 × 78 × 40 | yes: supports on build plate | 9.7 | 0.9 |

Total ≈ 300 g of PETG (+ ~15 % for supports and purge) and ≈ 29 h of printing (EST).

**Print CA-900 first.** Check each hole with the real part:

| Coupon hole | Test with | Good fit | If not |
|---|---|---|---|
| 3.9 mm (#6 clearance) | #6-32 screw | slides through | change `TOL['n6_clear']` |
| 2.9 mm (#6 pilot) | #6-32 screw | threads in firmly by hand with a screwdriver | `n6_pilot` |
| 4.6 mm (#8 clearance) | #8-32 screw | slides through | `n8_clear` |
| 3.5 mm (#8 pilot) | #8-32 screw | threads in firmly | `n8_pilot` |
| 6.0 mm (rod) | 6 mm rod | presses in by hand, doesn't fall out | `rod_press` |
| 12.15 mm (LM6UU) | LM6UU | presses in with thumb pressure | `lm_press` |

Then edit `TOL` in `backend/cad/model.py` and re-run `python3.13 backend/cad/export.py && python3.13 backend/cad/print_prep.py` before printing the rest. The carriage (CA-301) prints lying on its back, so its 4 LM6UU seats are horizontal: if one is tight, turn a 12 mm drill bit through it by hand.

Cut from the silicone sheet (or the rubber you use instead, 1–2 mm thick): 2 pad liners 32 × 40 mm (superglue to the curved pads, CA-402/403) and the can bumper CA-404, 9 × 13.5 mm (superglue to the gripper frame).

Cut the 6 mm rod into 2 × 112 mm; file the ends square and deburr.

## 3. Before any servo is connected: set the buck

1. Connect only the 12 V adapter → DC jack → XL4015 IN+ / IN−. Nothing on the output.
2. Meter on OUT+ / OUT−. Turn the pot (it usually needs many turns) until it reads **5.8 V**.
3. Unplug. Mark the pot with a dot of nail polish so it isn't turned by accident.

## 4. Assembly

**Picture manual (IKEA style): [12_assembly_manual.pdf](12_assembly_manual.pdf).** Electronics bench test first: [13_electronics_bench_test.md](13_electronics_bench_test.md).

Servos are fitted **at their HOME angle**, so the horns go on at the right orientation. Load `firmware/servo_setup/servo_setup.ino` on the Uno, wire the servos as in section 5, power up: every servo goes to HOME (turntable 135°, lift 30°, wrist 0°, gripper 20°). Type `t 135`, `l 30`, etc. in the Serial Monitor (9600 baud, Newline) to move one.

Fasteners: #6-32 × ½″ ×8 (tray 2, spine 2, top cap 2, link pivot 1, right gear axle 1); #8-32 × ½″ ×4 (MG996R); servo-bag screws for horns and servo tabs.

### 4.1 Base (CA-101)

1. Press the 6807 bearing into the tower pocket (Ø47.1). Press on the **outer** race only, evenly, with a flat block in a vise. It should sit flat on the pocket floor.
2. Fit the MG996R in its pocket under the tower, spline up through the bearing bore, body pointing away from the arm sweep. 4 × #8-32 × ½″ up through the flange into the printed pilots.
3. Fill the two corner pockets with ~100 g of weight (washers, pennies, nuts or small rocks) and hot-glue or tape it in: the pockets are open underneath. Stick 4 rubber feet (or hot-glue dots) under the base.

### 4.2 Turret (CA-201)

1. Servo at **135°** (`t 135`). Put the round horn on the spline so its screw holes sit at 45°, 135°, 225°, 315°, and fit its centre screw.
2. Lower the turret plate: the hub presses into the bearing bore (Ø34.95), and the plate's front (the rod bosses) points at the START can.
3. 4 servo-bag screws from above through the plate into the horn.
4. `t 45` then `t 135`: the plate turns 90° freely, with no rubbing.

### 4.3 Column and lift (CA-202, CA-203, CA-301, CA-302)

1. Press 2 LM6UU into each rod bore of the carriage (CA-301), flush with the faces.
2. Press the two 112 mm rods into the turret plate's blind holes (Ø6.0).
3. Slide the carriage down over both rods. It must drop under its own weight; if it sticks, the rods aren't parallel yet (the top cap fixes that).
4. Spine (CA-202) on the turret plate: 2 × #6-32 × ½″ from above. Top cap (CA-203) over the rod tops and onto the spine: 2 × #6-32 × ½″. Check again that the carriage slides freely.
5. Lift servo (MG90S) into the spine bracket, 2 servo-bag screws. Servo at **30°** (`l 30`).
6. Crank: an MG90S single-arm horn trimmed to a 20 mm pin radius, fitted at 30° so the carriage is at the bottom of its travel. Lift link (CA-302): crank end with a servo-bag screw, carriage end with #6-32 × ½″ as the pivot (don't over-tighten: it must turn).
7. `l 75` then `l 30`: the carriage rises 15 mm and returns, smoothly.

### 4.4 Wrist and gripper (CA-401, CA-402, CA-403, CA-404)

1. Wrist servo (MG90S) into the carriage's wrist bracket, 2 servo-bag screws. Servo at **0°** (`w 0`). Round horn on, centre screw in.
2. Gripper frame (CA-401) flange onto the horn, gripper **upright** (plates horizontal, can opening facing out): 4 servo-bag screws.
3. Gripper servo (SG90) into the frame, 2 servo-bag screws. Servo at **20°** (`g 20`).
4. Right finger (CA-402) on its axle: #6-32 × ½″ from the top, through the 3.9 mm bore, into the bottom plate's pilot. It must swing freely.
5. Left finger (CA-403) onto the SG90 spline (its socket replaces the horn), gears meshed so both arms are open by the same angle. Horn screw in.
6. `g 95`: both arms close together and the pads meet the can position evenly. `g 20` opens.
7. `w 180` then `w 0`: the gripper rolls a full half-turn. **If the wrist stops short of 180°, note the angle: this is the risk to settle first** (try another MG90S).

### 4.5 Electronics tray (CA-102)

1. Uno and XL4015 onto their printed pegs, a dab of hot glue on each. Mini breadboard: self-adhesive.
2. START button (12 mm), LED (5 mm) and DC jack (8 mm) through the front panel.
3. Tray onto the base: 2 × #6-32 × ½″ up through the tabs.

## 5. Wiring

Follow `docs/04_wiring.md` and the diagram `docs/wiring/wiring_diagram.png`:

1. Jack + → XL4015 IN+ and Uno VIN. Jack − → XL4015 IN− and Uno GND.
2. XL4015 OUT+ / OUT− → breadboard rail + / −. 1000 µF capacitor across the rail (− leg to −).
3. **MG996R red / brown straight into the XL4015 OUT terminals** (cut one extension lead to split them from the orange signal wire). Signal → D9.
4. Lift, wrist, gripper through 300 mm extensions to the rail; signals → D10, D6, D5.
5. Rail − → Uno GND (common ground).
6. Button: D4 → button → GND. LED: D13 → 220 Ω → LED long leg; short leg → GND.
7. Route the column servo leads down the spine with a loose loop: the turret turns 90° and the carriage moves 15 mm. Tie the loop to the spine so it can't catch the arm.

## 6. Calibration (laptop control panel)

Upload `firmware/concept_a/concept_a.ino`, close the IDE's Serial Monitor, open `viewer/control_panel.html` in Chrome / Edge and click **Connect** (docs/13, section 2b). Real empty can on the START mark (5.0 in from the turntable axis), against the can bumper; 12 V on.

For each constant in the panel's **Calibration** table: move that servo with its card (±5°, then ±1°) until it looks right, click **Use current angle**, and **Test** to check it again. Then **Copy code**, replace the angle lines at the top of `concept_a.ino`, upload, reconnect: the table's *firmware* column now shows your values and the presets follow them.

| Constant | Looks right when | Default |
|---|---|---:|
| `TURN_START` | the gripper is centred on the START can | 135 |
| `TURN_TARGET` | the gripper is centred on the TARGET mark (90° away) | 45 |
| `LIFT_DOWN` | the pads are at the can's mid-height and the can just touches the table | 30 |
| `LIFT_UP` | `LIFT_DOWN` + 45 (0.6 in higher); the flipped can clears the table | 75 |
| `WRIST_UP` | the gripper is level, can upright (phone level app on the frame) | 0 |
| `WRIST_FLIP` | the gripper is exactly upside down | 180 |
| `GRIP_OPEN` | the arms pass around the can without touching it | 20 |
| `GRIP_CLOSED` | the pads touch the can, then +3 to +5° for a light squeeze (0.5–1 N per arm: the can shouldn't dent, and shouldn't slide when you tug it) | 95 |
| `GRIP_RELEASE` | upside down at the target, the pads clear the can by a few mm (CAD: 13 mm at 70°); don't open further, the arm would reach the base | 70 |

The panel only moves each servo inside a window around its current constants (base ±10°, lift ±5°, grip −10/+5°). If a real angle is outside it, set that constant roughly in `concept_a.ino`, upload and fine-tune again. Without a laptop: `firmware/servo_setup` does the same over the Serial Monitor.

## 7. Tests (fill in the report's section 10)

| Test | Pass |
|---|---|
| Buck output under a full run (meter on the rail) | ≥ 5.5 V |
| Wrist range | 180° ± 3° |
| Turntable | 90° ± 2°, can within 0.17 in of the target |
| Grip | holds through the run, no dent, SG90 not hot |
| Full run × 10 | can inverted and free-standing at the target in ≥ 9 of 10 |

If a run fails, the Serial Monitor shows the last step reached (`> GRIP`, `> LIFT`, …). Fix that step's angle and run again.
