jackpham-rgb/MEproject2026F/cad/print/plates/plates.png

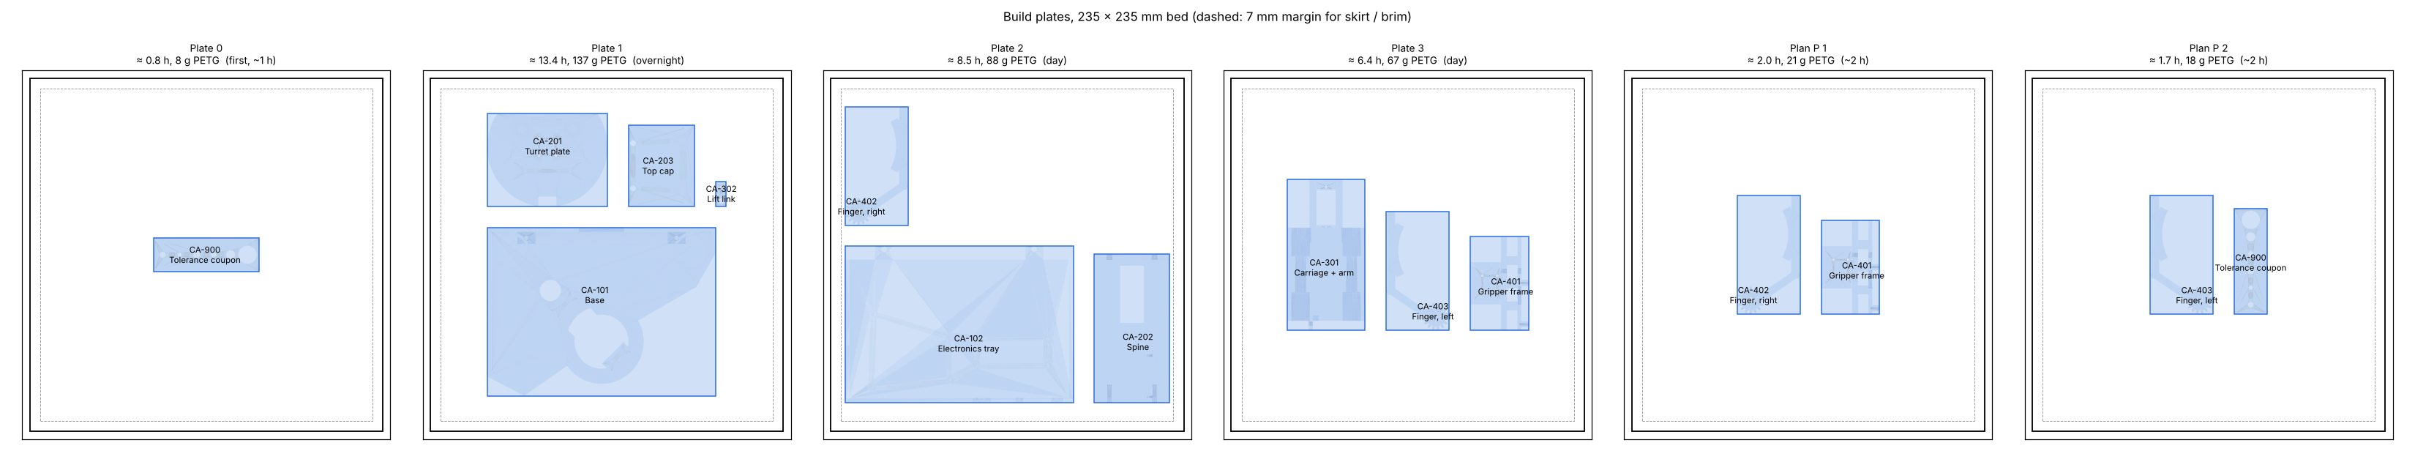
cad/print/plates/plates.png
