jackpham-rgb/MEproject2026F/docs/manual/cover.png

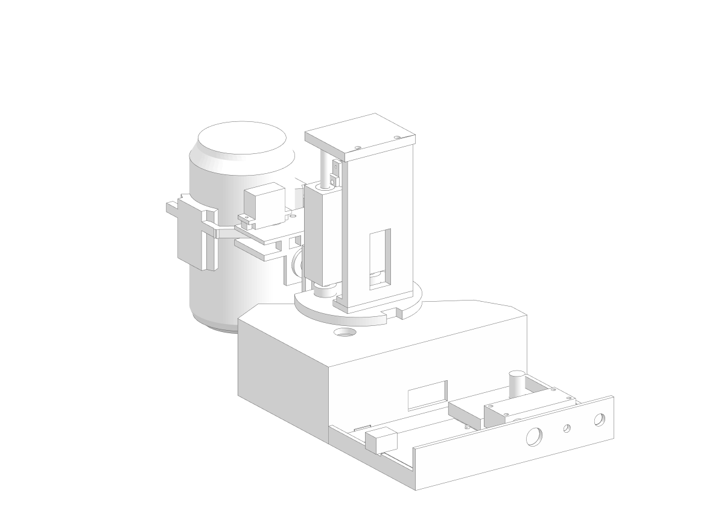
docs/manual/cover.png
