jackpham-rgb/MEproject2026F/docs/manual/part_base.png

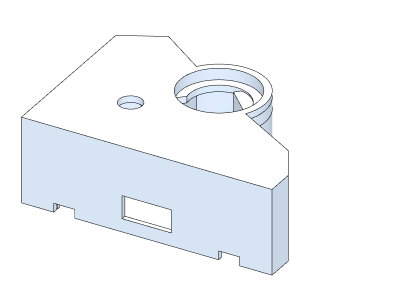
docs/manual/part_base.png
