jackpham-rgb/MEproject2026F/docs/manual/part_carriage_arm.png

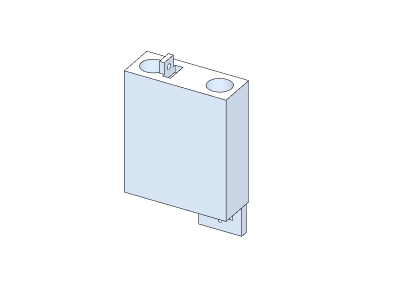
docs/manual/part_carriage_arm.png
