jackpham-rgb/MEproject2026F/docs/manual/part_finger_L.png

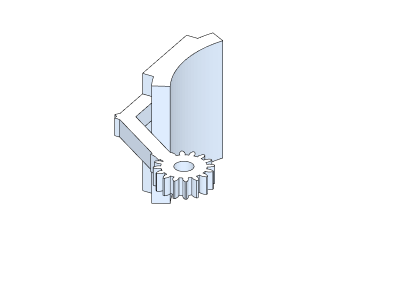
docs/manual/part_finger_L.png
