jackpham-rgb/MEproject2026F/docs/manual/part_finger_R.png

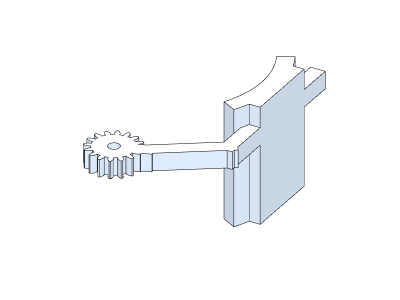
docs/manual/part_finger_R.png
