jackpham-rgb/MEproject2026F/docs/manual/part_gripper_frame.png

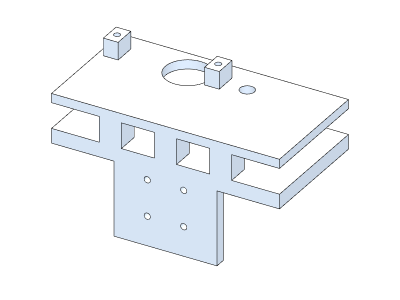
docs/manual/part_gripper_frame.png
