jackpham-rgb/MEproject2026F/docs/manual/part_lift_link.png

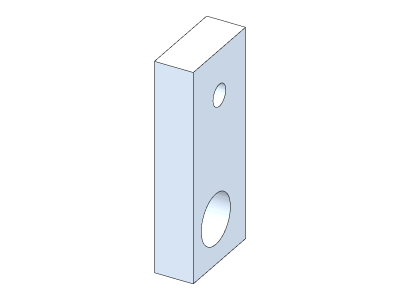
docs/manual/part_lift_link.png
