jackpham-rgb/MEproject2026F/docs/manual/part_spine.png

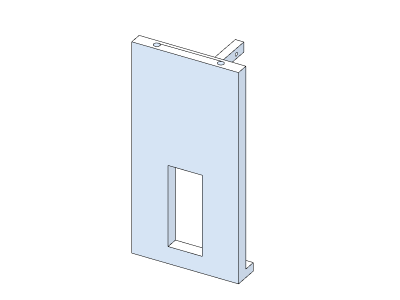
docs/manual/part_spine.png
