jackpham-rgb/MEproject2026F/docs/manual/part_top_cap.png

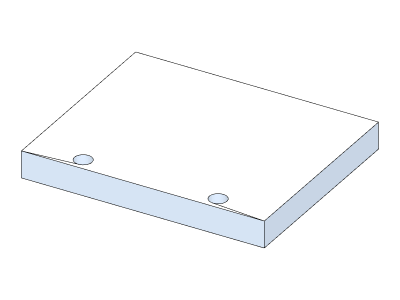
docs/manual/part_top_cap.png
