jackpham-rgb/MEproject2026F/docs/manual/part_turret_plate.png

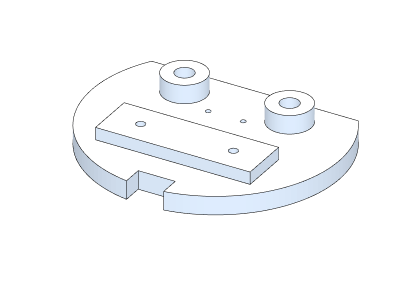
docs/manual/part_turret_plate.png
