jackpham-rgb/MEproject2026F/docs/manual/step_01.png

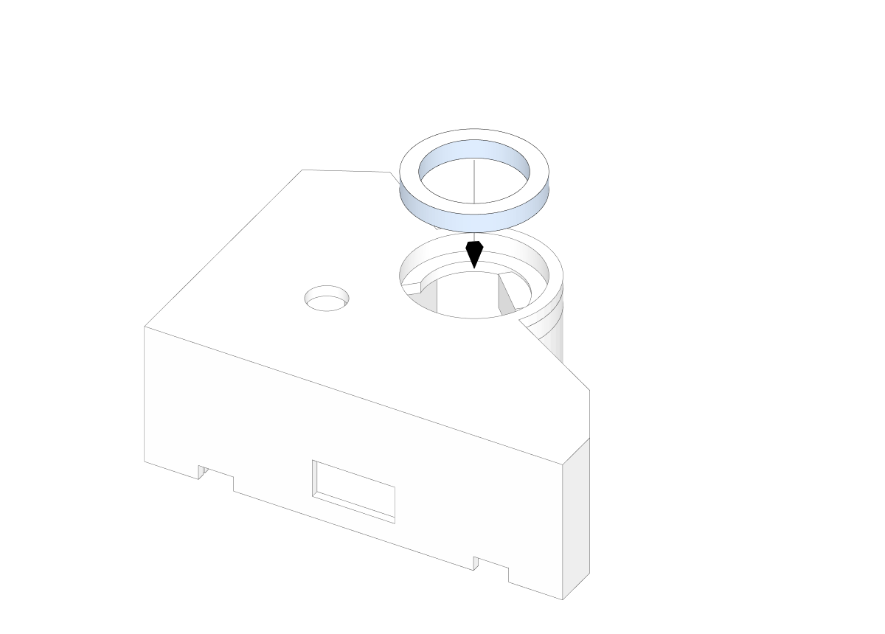
docs/manual/step_01.png
