jackpham-rgb/MEproject2026F/docs/manual/step_02.png

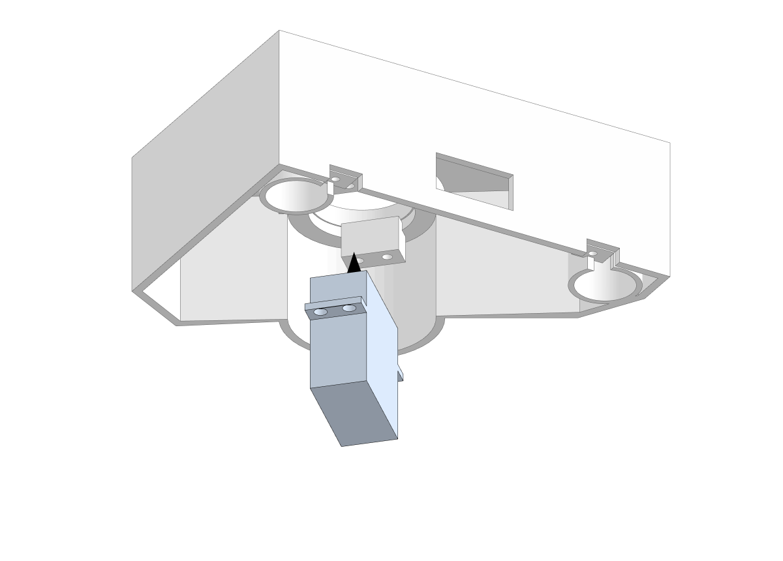
docs/manual/step_02.png
