jackpham-rgb/MEproject2026F/docs/manual/step_03.png

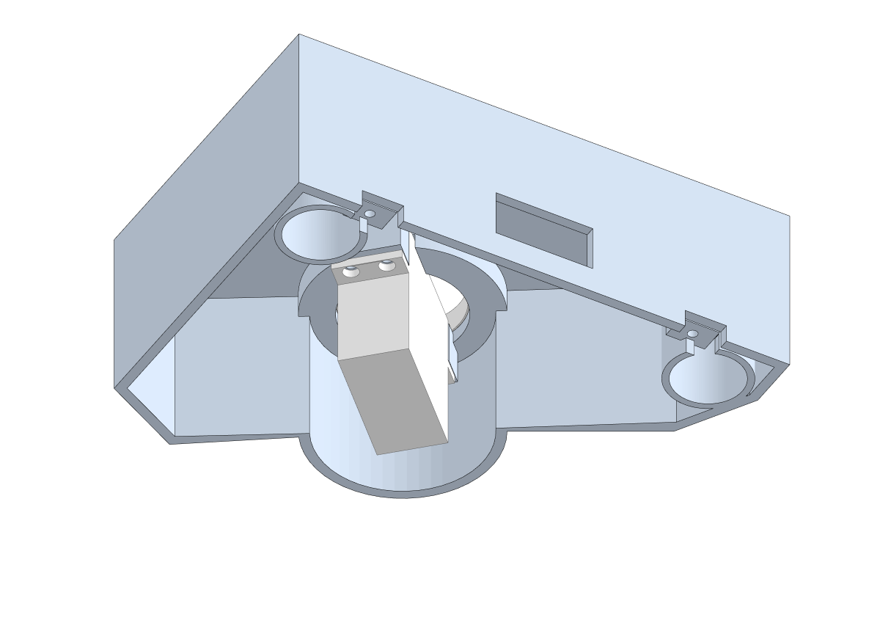
docs/manual/step_03.png
