jackpham-rgb/MEproject2026F/docs/manual/step_04.png

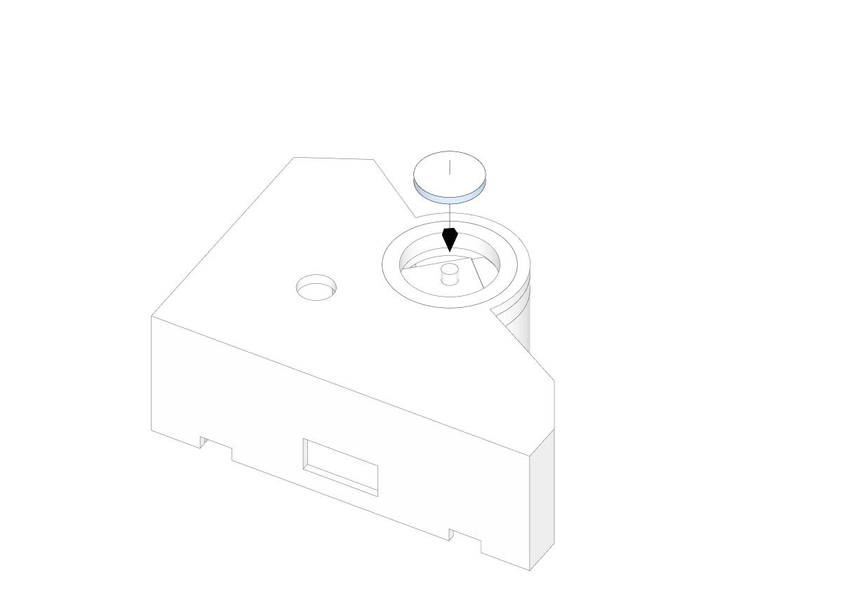
docs/manual/step_04.png
