jackpham-rgb/MEproject2026F/docs/manual/step_05.png

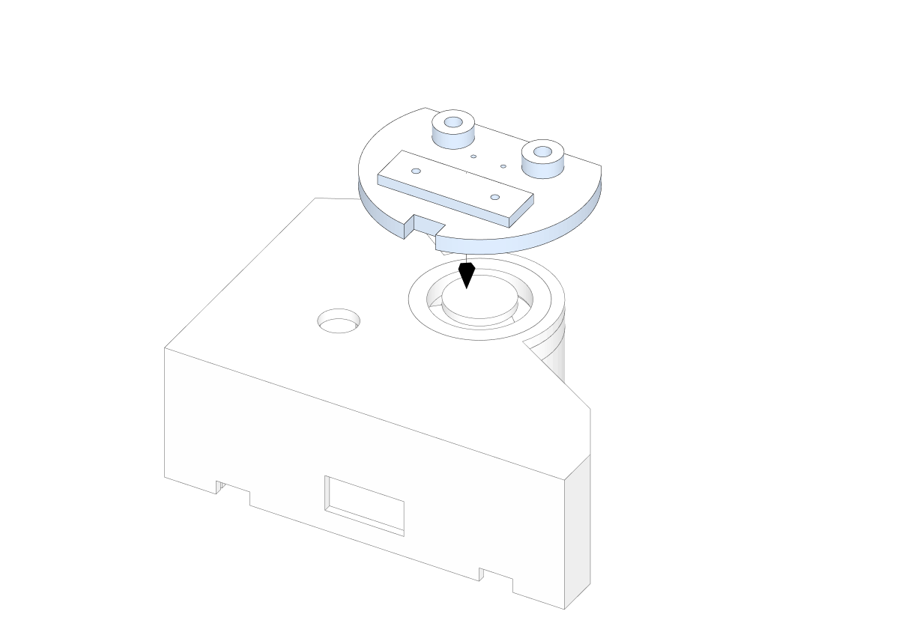
docs/manual/step_05.png
