jackpham-rgb/MEproject2026F/docs/manual/step_06.png

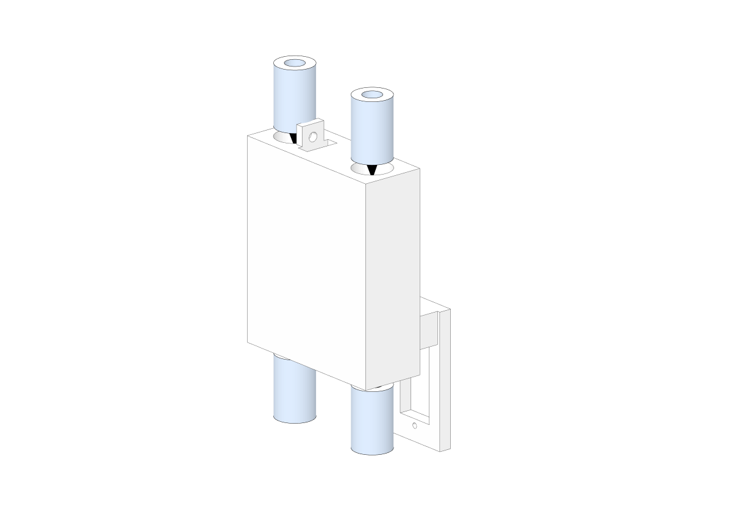
docs/manual/step_06.png
