jackpham-rgb/MEproject2026F/docs/manual/step_07.png

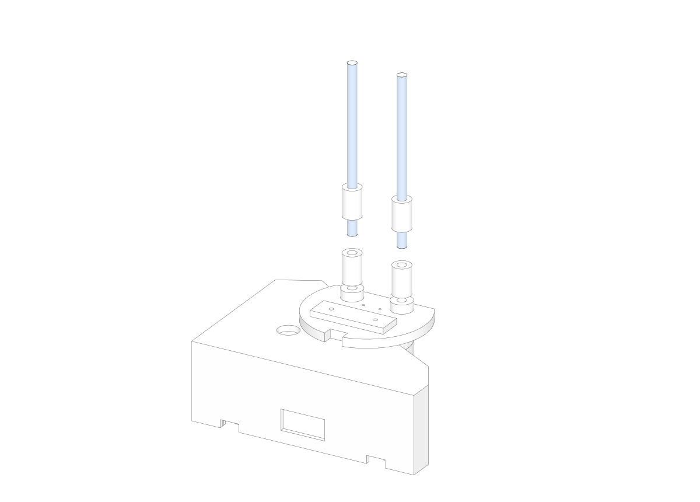
docs/manual/step_07.png
