jackpham-rgb/MEproject2026F/docs/manual/step_09.png

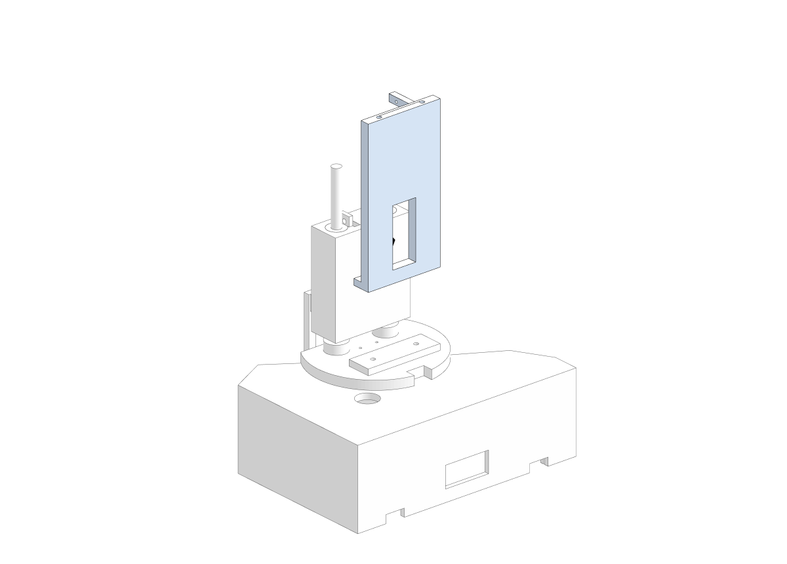
docs/manual/step_09.png
