jackpham-rgb/MEproject2026F/docs/manual/step_10.png

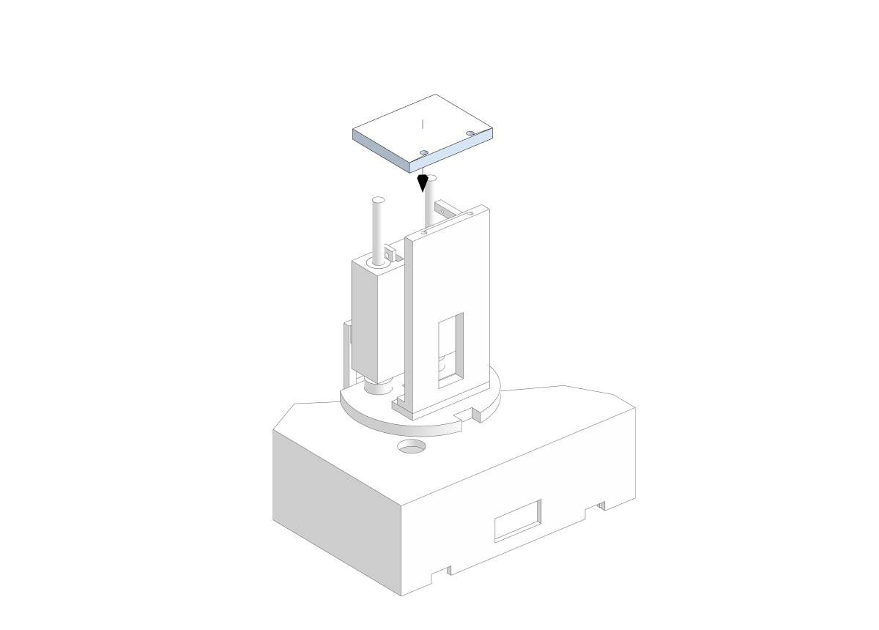
docs/manual/step_10.png
