jackpham-rgb/MEproject2026F/docs/manual/step_11.png

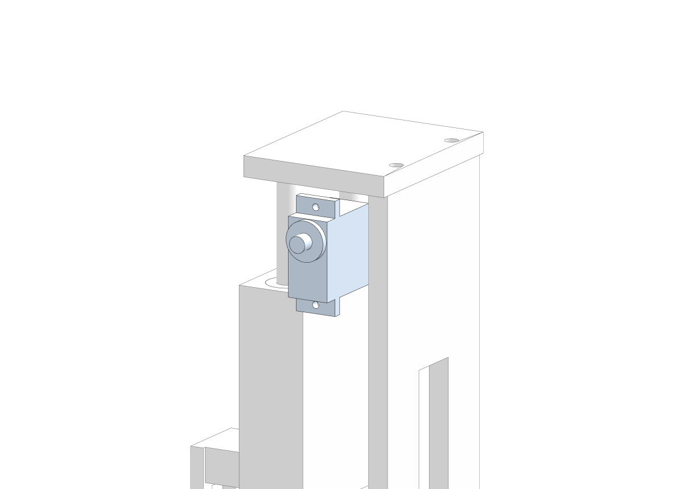
docs/manual/step_11.png
