jackpham-rgb/MEproject2026F/docs/manual/step_12.png

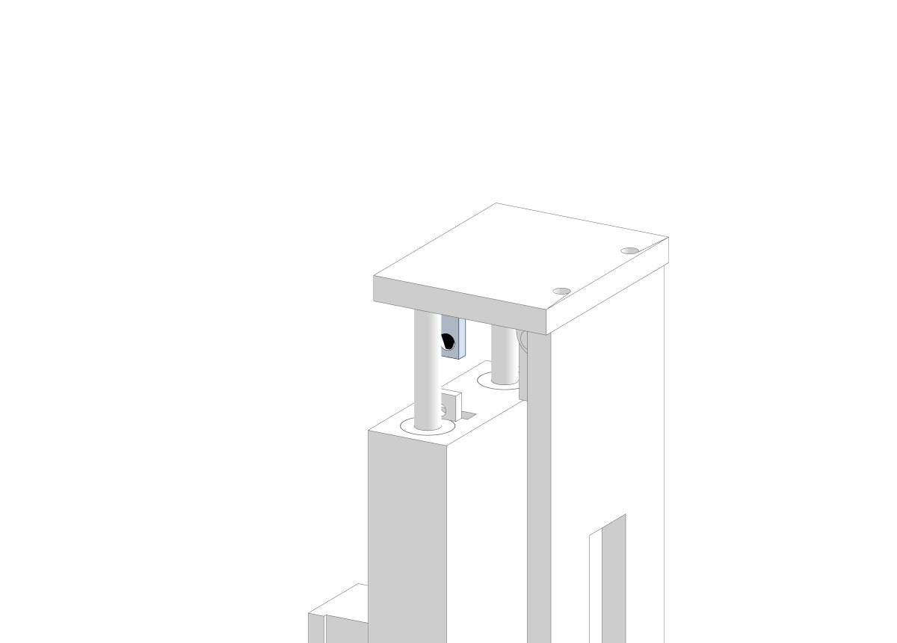
docs/manual/step_12.png
