jackpham-rgb/MEproject2026F/docs/manual/step_14.png

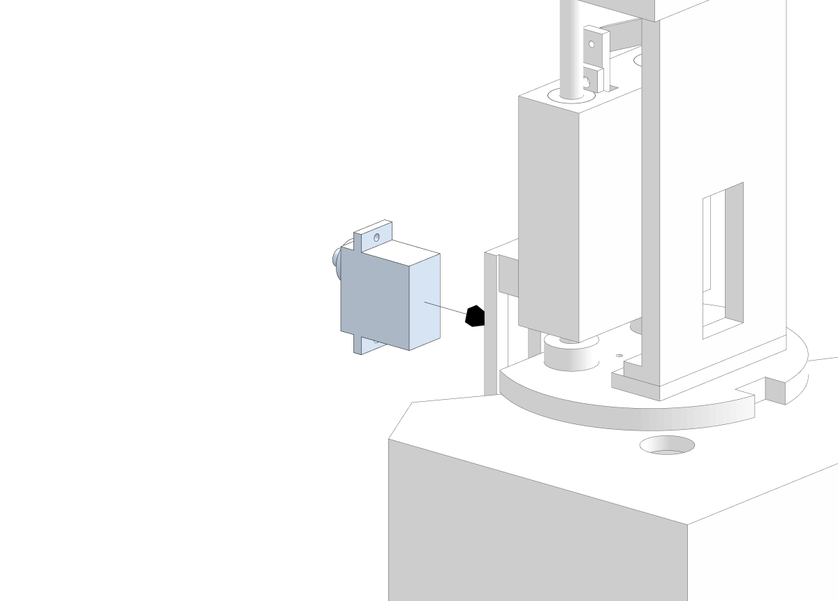
docs/manual/step_14.png
