jackpham-rgb/MEproject2026F/docs/manual/step_16.png

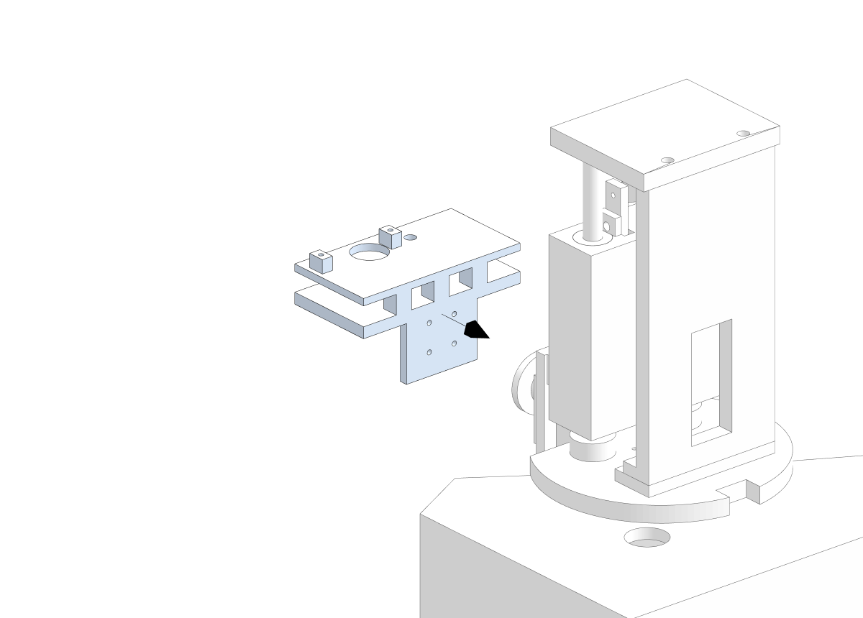
docs/manual/step_16.png
