jackpham-rgb/MEproject2026F/docs/manual/step_17.png

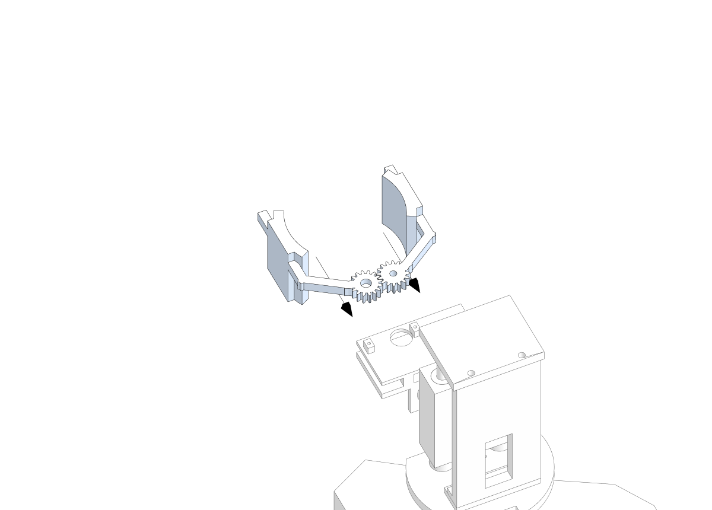
docs/manual/step_17.png
