jackpham-rgb/MEproject2026F/docs/manual/step_18.png

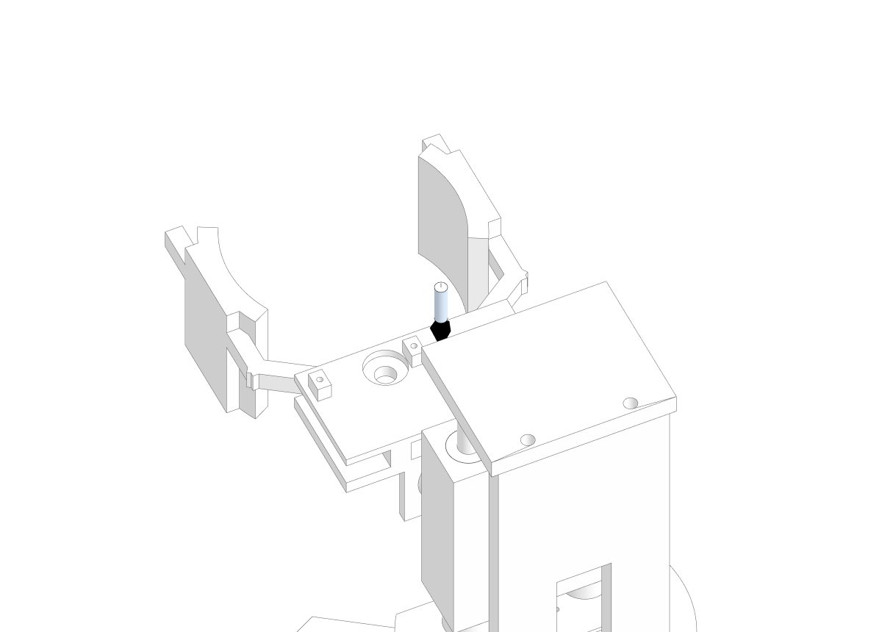
docs/manual/step_18.png
