jackpham-rgb/MEproject2026F/docs/manual/step_19.png

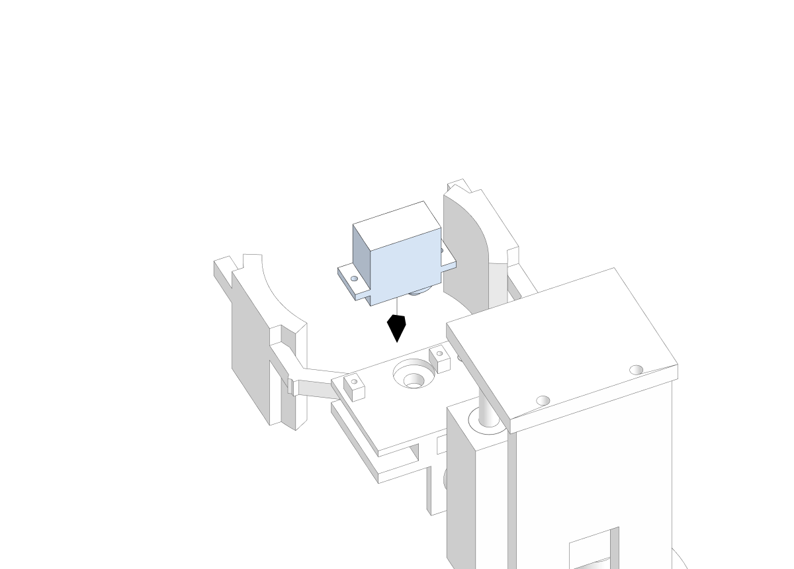
docs/manual/step_19.png
