jackpham-rgb/MEproject2026F/docs/manual/step_20.png

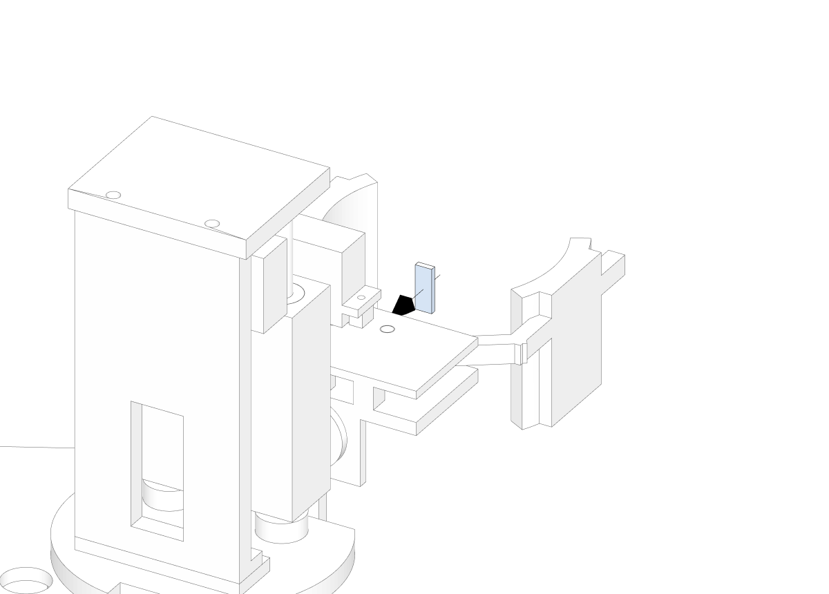
docs/manual/step_20.png
