jackpham-rgb/MEproject2026F/docs/manual/step_21.png

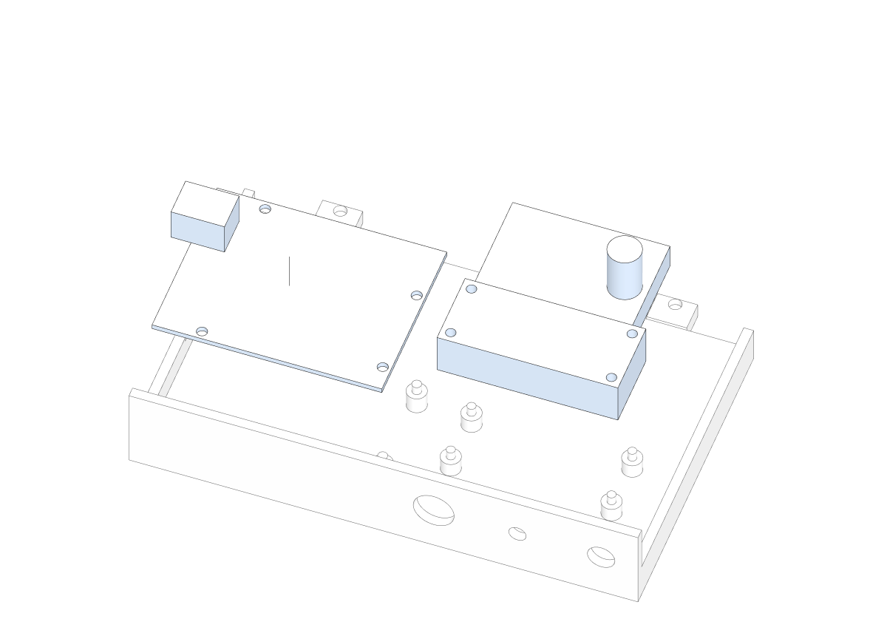
docs/manual/step_21.png
