jackpham-rgb/MEproject2026F/docs/manual/step_22.png

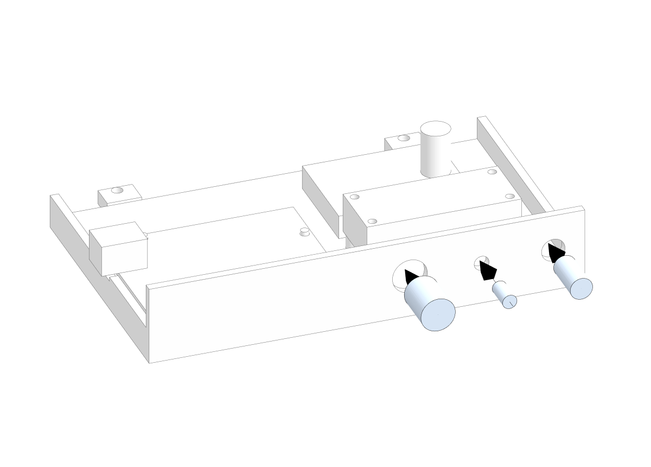
docs/manual/step_22.png
