jackpham-rgb/MEproject2026F/docs/manual/step_23.png

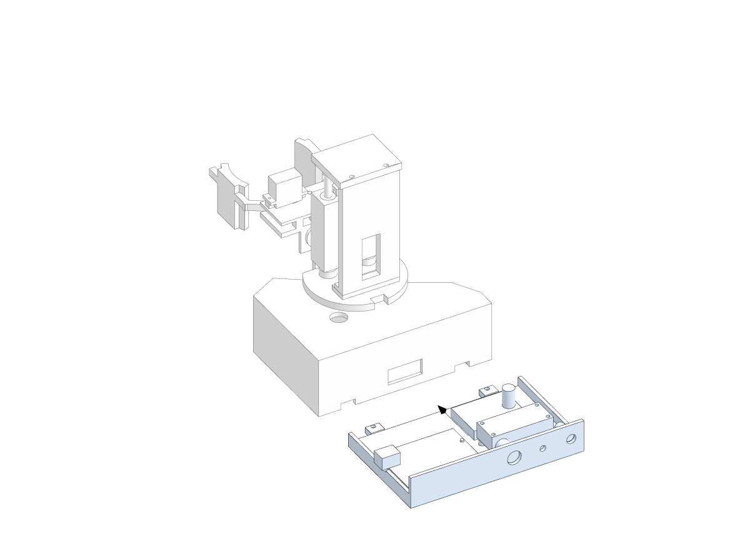
docs/manual/step_23.png
