jackpham-rgb/MEproject2026F/docs/wiring/motion/turn_end.png

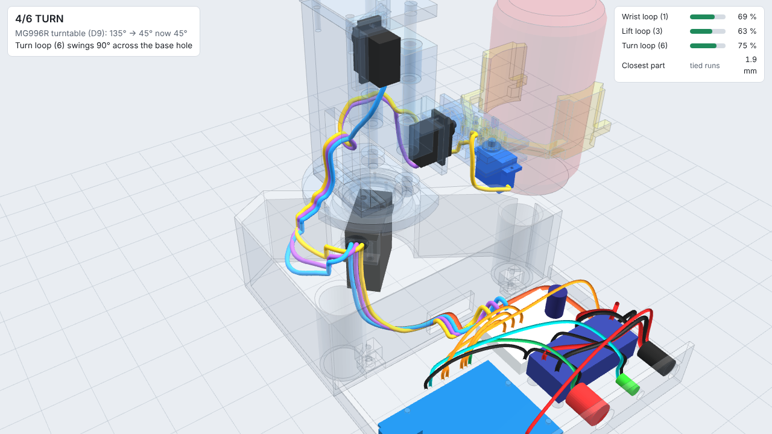
docs/wiring/motion/turn_end.png
