jackpham-rgb/MEproject2026F/docs/wiring/wiring_3d_column_clean.png

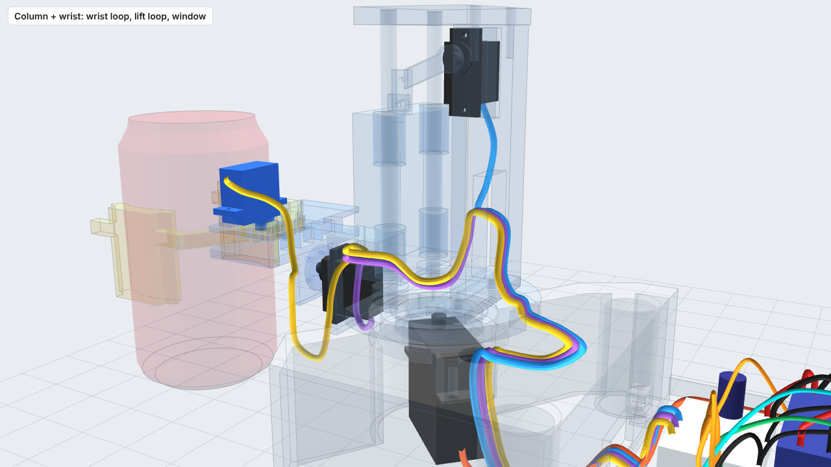
docs/wiring/wiring_3d_column_clean.png
