jackpham-rgb/MEproject2026F/docs/wiring/wiring_3d_tray_clean.png

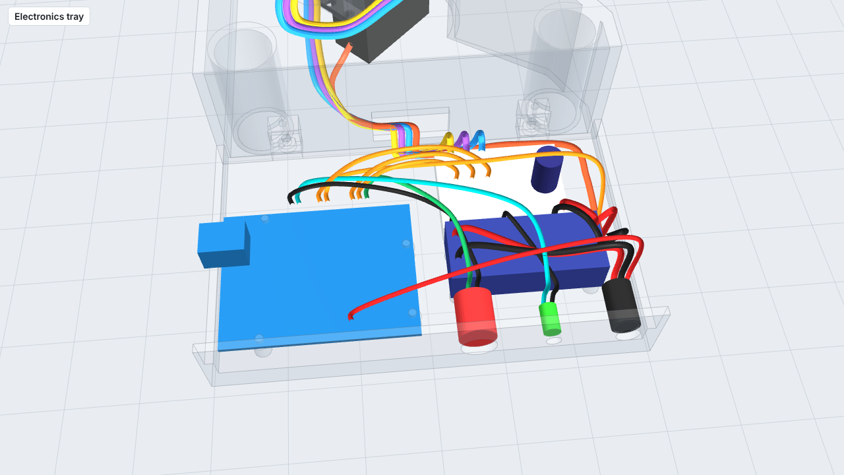
docs/wiring/wiring_3d_tray_clean.png
