jackpham-rgb/MEproject2026F/docs/drawings/CA-000_assembly.pdf

# CA-000 Concept A assembly, HOME pose (arm at START)

## PARTS LIST (full BOM: docs/05_bom.md)

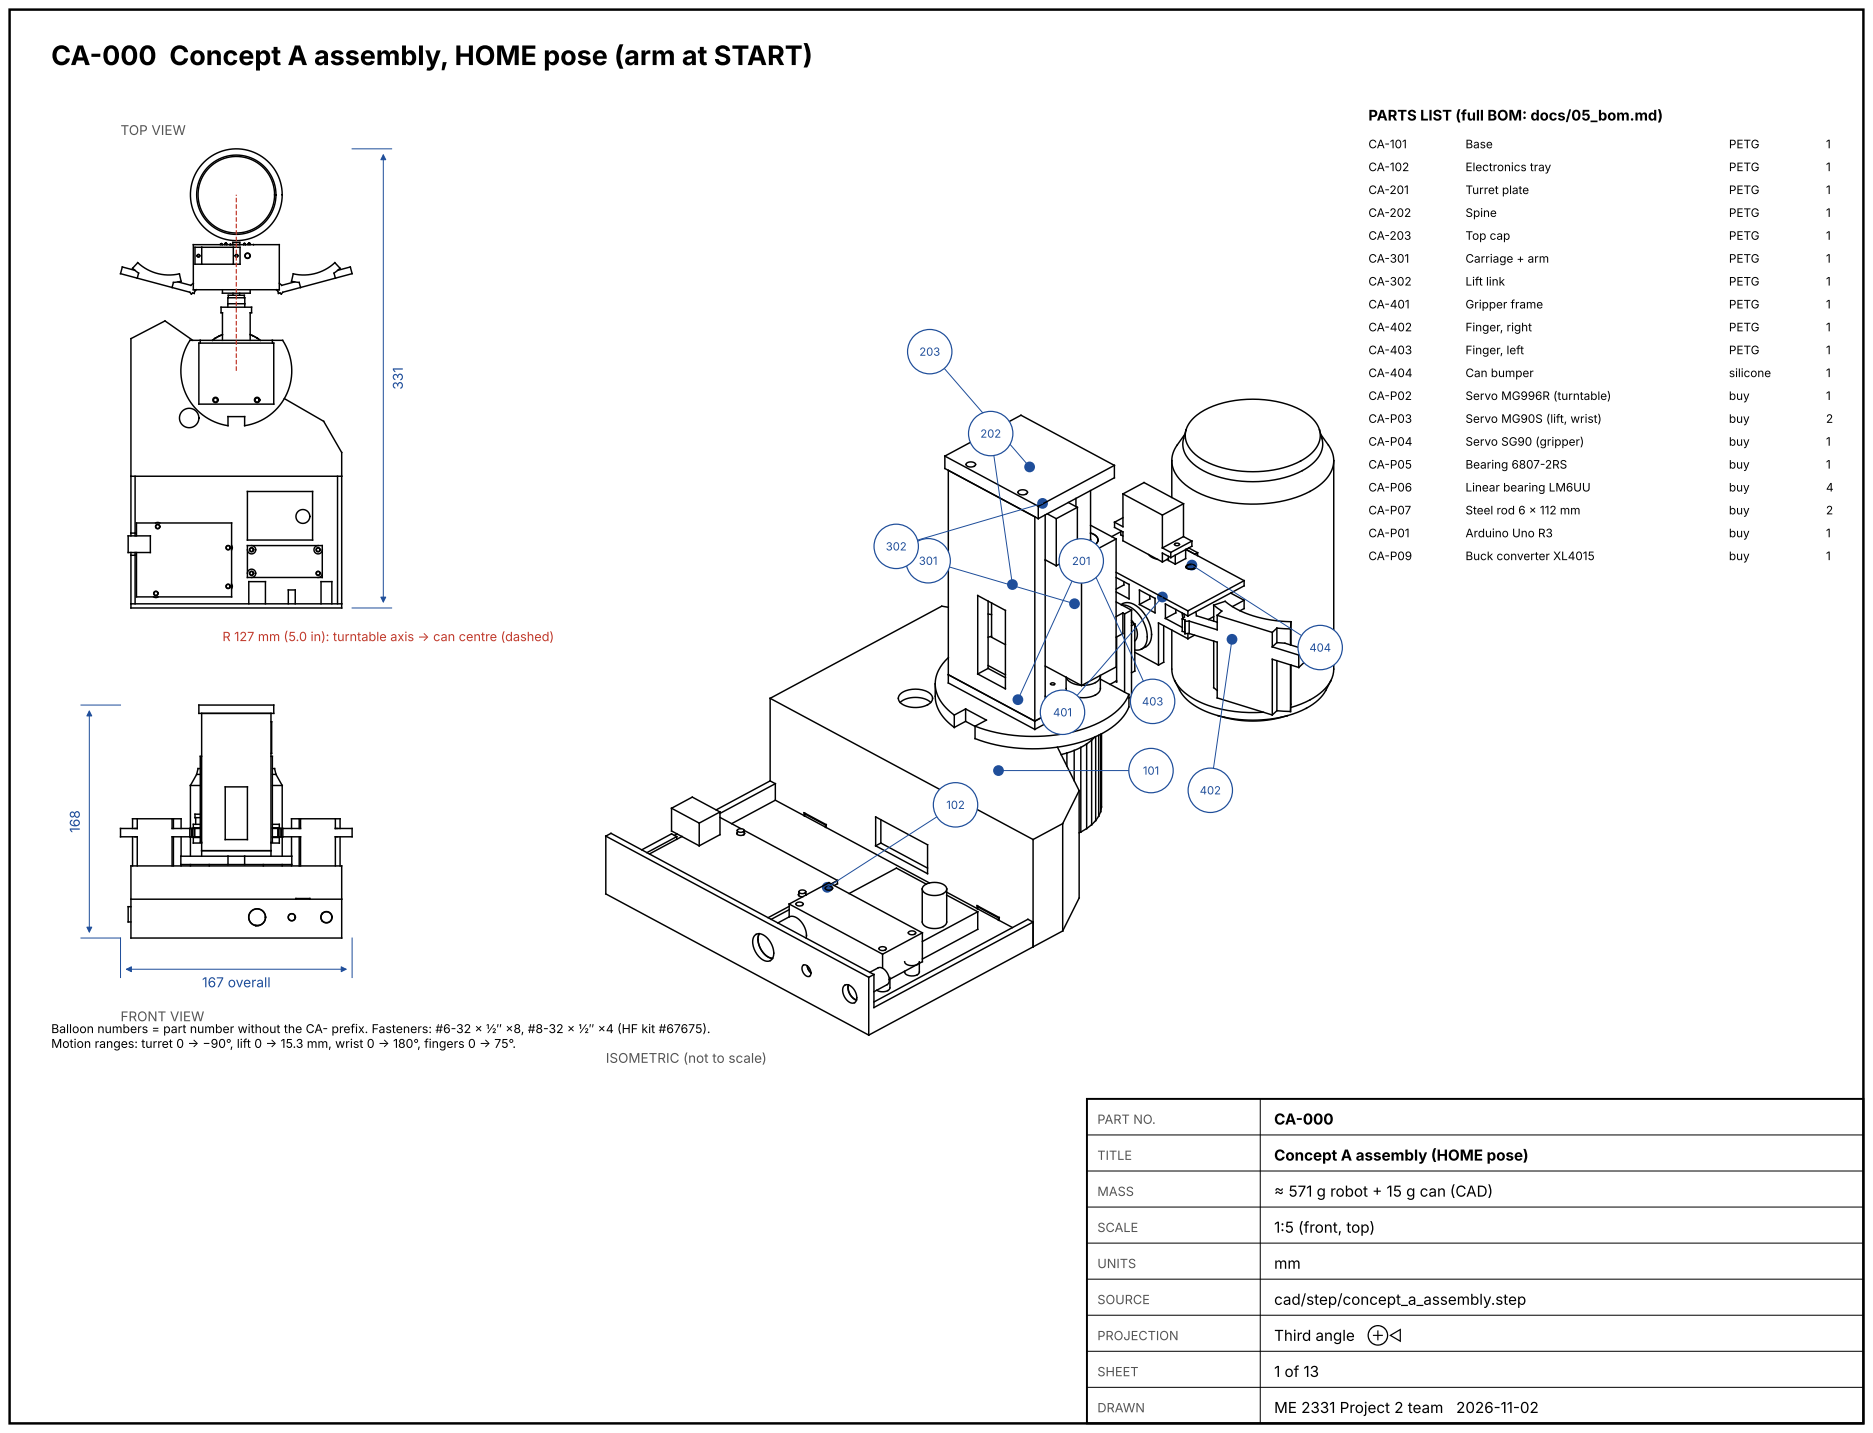
[picture p123: page 1]
DRAWN; ME 2331 Project 2 team 2026-11-02; SHEET; PROJECTION; Third angle ⊕◁; SOURCE; cad/step/concept_a_assembly.step; UNITS; SCALE; 1:5 (front, top); MASS; ≈ 571 g robot + 15 g can (CAD); TITLE; Concept A assembly (HOME pose); PART NO.; FRONT VIEW; TOP VIEW; 167 overall; Base; PETG; Electronics tray; Turret plate; Spine; Top cap; Carriage + arm; Lift link; Gripper frame; Finger, right; Finger, left; Can bumper; silicone; Servo MG996R (turntable); buy; Servo MG90S (lift, wrist)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

R 127 mm (5.0 in): turntable axis → can centre (dashed)

Balloon numbers = part number without the CA- prefix. Fasteners: #6-32 × ½″ ×8, #8-32 × ½″ ×4 (HF kit #67675).
Motion ranges: turret 0 → −90°, lift 0 → 15.3 mm, wrist 0 → 180°, fingers 0 → 75°.

ISOMETRIC (not to scale)
