jackpham-rgb/MEproject2026F/docs/drawings/CA-102_electronics_tray.pdf

# CA-102 Electronics tray

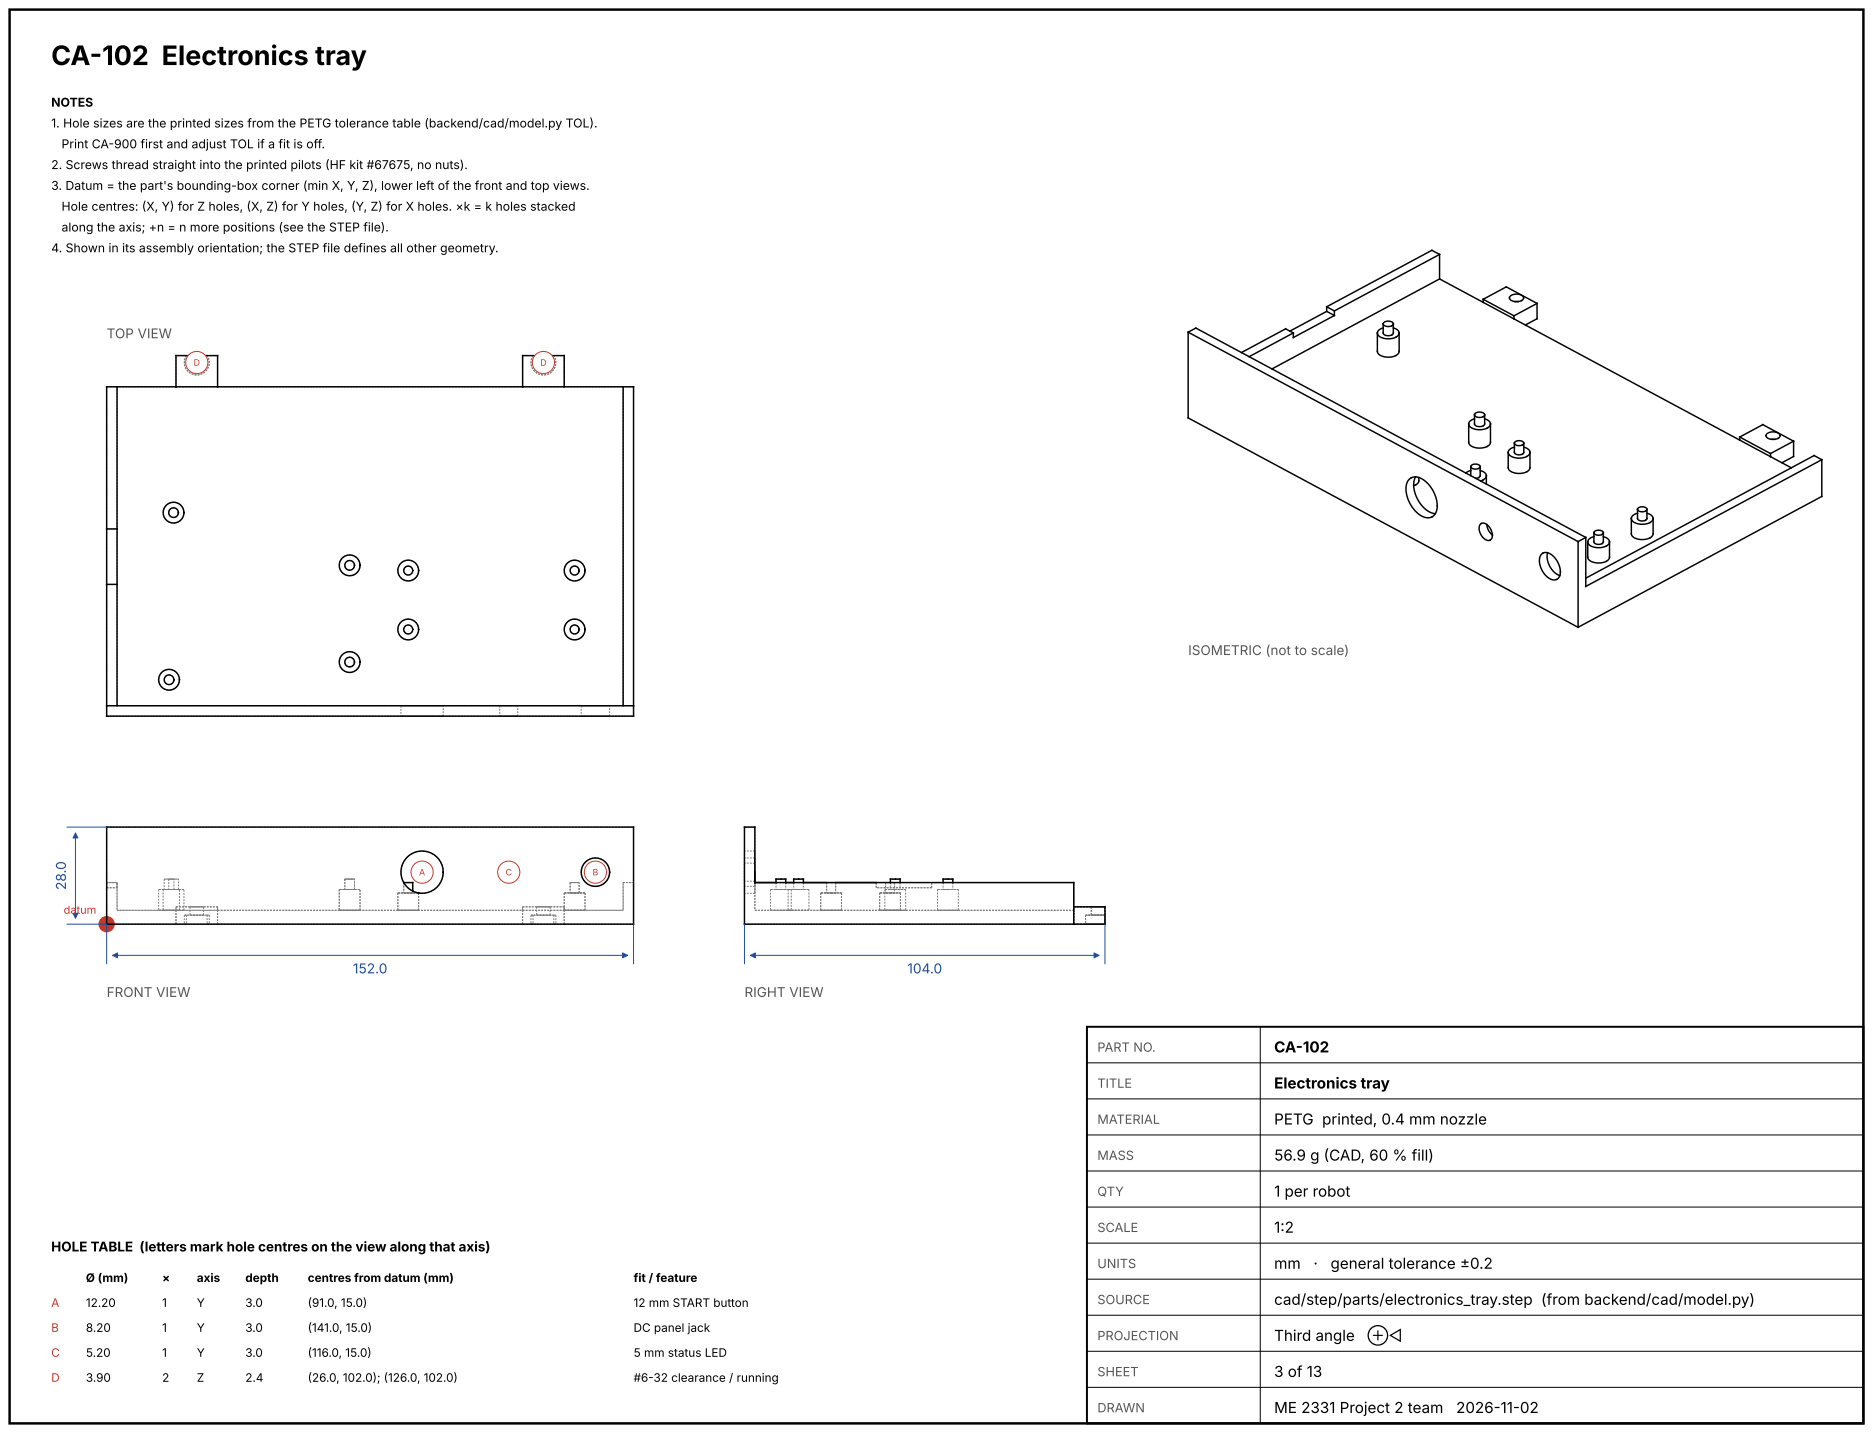
[picture p124: page 1]
DRAWN; ME 2331 Project 2 team 2026-11-02; SHEET; PROJECTION; Third angle ⊕◁; SOURCE; cad/step/parts/electronics_tray.step (from backend/cad/model.py); UNITS; mm · general tolerance ±0.2; SCALE; QTY; 1 per robot; MASS; 56.9 g (CAD, 60 % fill); MATERIAL; PETG printed, 0.4 mm nozzle; TITLE; Electronics tray; PART NO.; FRONT VIEW; TOP VIEW; RIGHT VIEW; axis; depth; centres from datum (mm); fit / feature; 12 mm START button; DC panel jack; 5 mm status LED; #6-32 clearance / running; datum

NOTES
1. Hole sizes are the printed sizes from the PETG tolerance table (backend/cad/model.py TOL).

Print CA-900 first and adjust TOL if a fit is off.
2. Screws thread straight into the printed pilots (HF kit #67675, no nuts).
3. Datum = the part's bounding-box corner (min X, Y, Z), lower left of the front and top views.
Hole centres: (X, Y) for Z holes, (X, Z) for Y holes, (Y, Z) for X holes. ×k = k holes stacked

along the axis; +n = n more positions (see the STEP file).

4. Shown in its assembly orientation; the STEP file defines all other geometry.

ISOMETRIC (not to scale)

HOLE TABLE (letters mark hole centres on the view along that axis)
