jackpham-rgb/MEproject2026F/docs/drawings/all_drawings.pdf

# CA-000 Concept A assembly, HOME pose (arm at START)

DRAWN; ME 2331 Project 2 team 2026-11-02; SHEET; PROJECTION; Third angle ⊕◁; SOURCE; cad/step/concept_a_assembly.step; UNITS; SCALE; 1:5 (front, top); MASS; ≈ 571 g robot + 15 g can (CAD); TITLE; Concept A assembly (HOME pose); PART NO.; FRONT VIEW; TOP VIEW; 167 overall; Base; PETG; Electronics tray; Turret plate; Spine; Top cap; Carriage + arm; Lift link; Gripper frame; Finger, right; Finger, left; Can bumper; silicone; Servo MG996R (turntable); buy; Servo MG90S (lift, wrist)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

PARTS LIST (full BOM: docs/05_bom.md)

R 127 mm (5.0 in): turntable axis → can centre (dashed)

Balloon numbers = part number without the CA- prefix. Fasteners: #6-32 × ½″ ×8, #8-32 × ½″ ×4 (HF kit #67675).
Motion ranges: turret 0 → −90°, lift 0 → 15.3 mm, wrist 0 → 180°, fingers 0 → 75°.

ISOMETRIC (not to scale)

# CA-101 Base

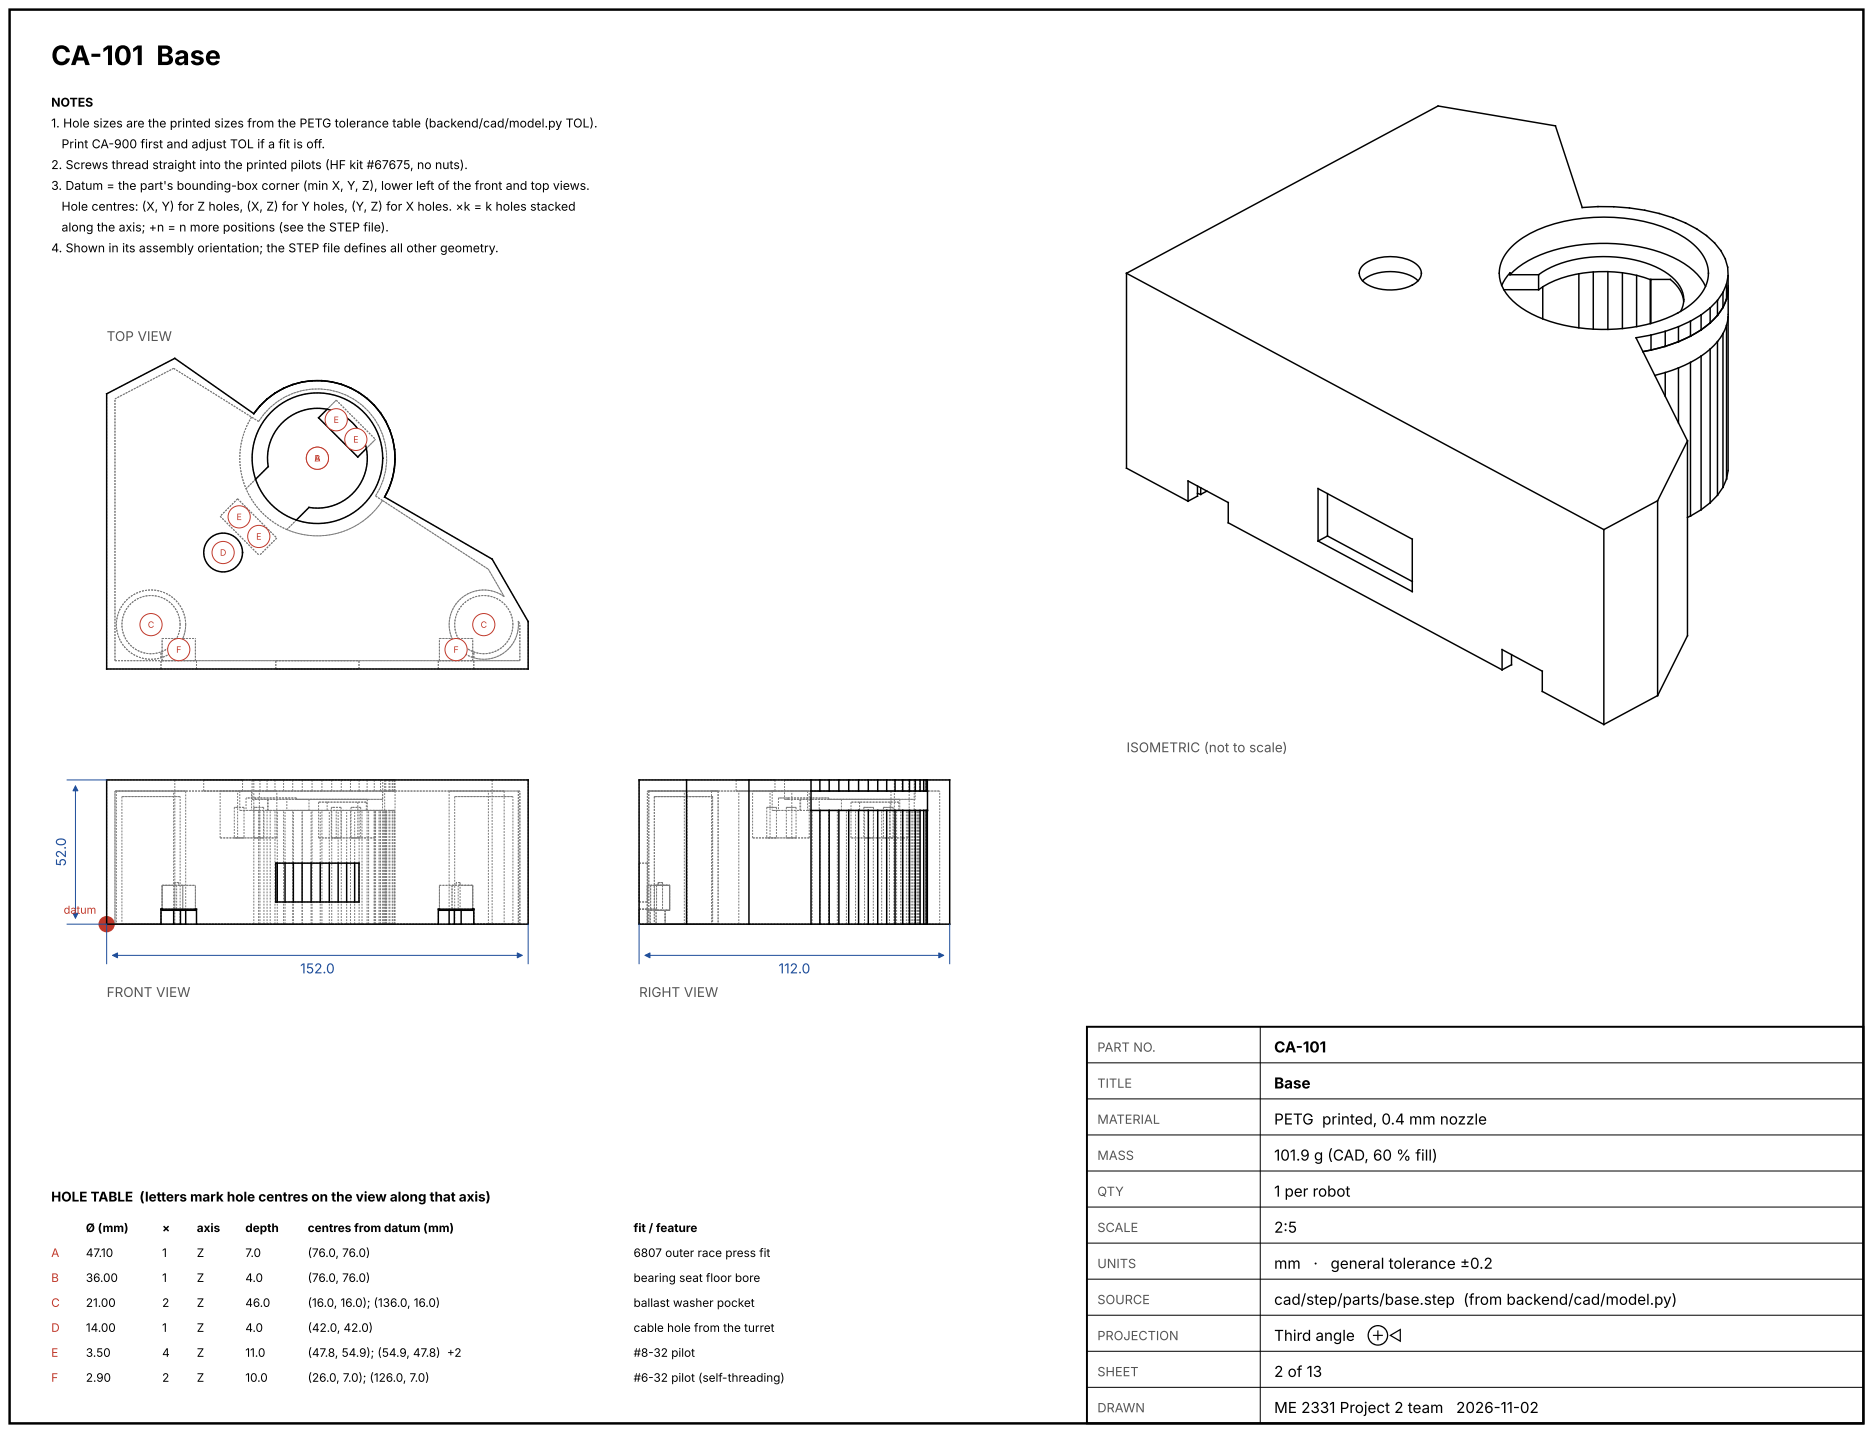
[picture p125: page 2]
PROJECTION; Third angle ⊕◁; SOURCE; cad/step/parts/base.step (from backend/cad/model.py); UNITS; mm · general tolerance ±0.2; SCALE; QTY; 1 per robot; MASS; 101.9 g (CAD, 60 % fill); MATERIAL; PETG printed, 0.4 mm nozzle; TITLE; Base; PART NO.; FRONT VIEW; TOP VIEW; RIGHT VIEW; axis; depth; centres from datum (mm); fit / feature; 6807 outer race press fit; bearing seat floor bore; ballast washer pocket; cable hole from the turret; #8-32 pilot; #6-32 pilot (self-threading); datum

NOTES
1. Hole sizes are the printed sizes from the PETG tolerance table (backend/cad/model.py TOL).

Print CA-900 first and adjust TOL if a fit is off.
2. Screws thread straight into the printed pilots (HF kit #67675, no nuts).
3. Datum = the part's bounding-box corner (min X, Y, Z), lower left of the front and top views.
Hole centres: (X, Y) for Z holes, (X, Z) for Y holes, (Y, Z) for X holes. ×k = k holes stacked
along the axis; +n = n more positions (see the STEP file).

4. Shown in its assembly orientation; the STEP file defines all other geometry.

ISOMETRIC (not to scale)

HOLE TABLE (letters mark hole centres on the view along that axis)

# CA-102 Electronics tray

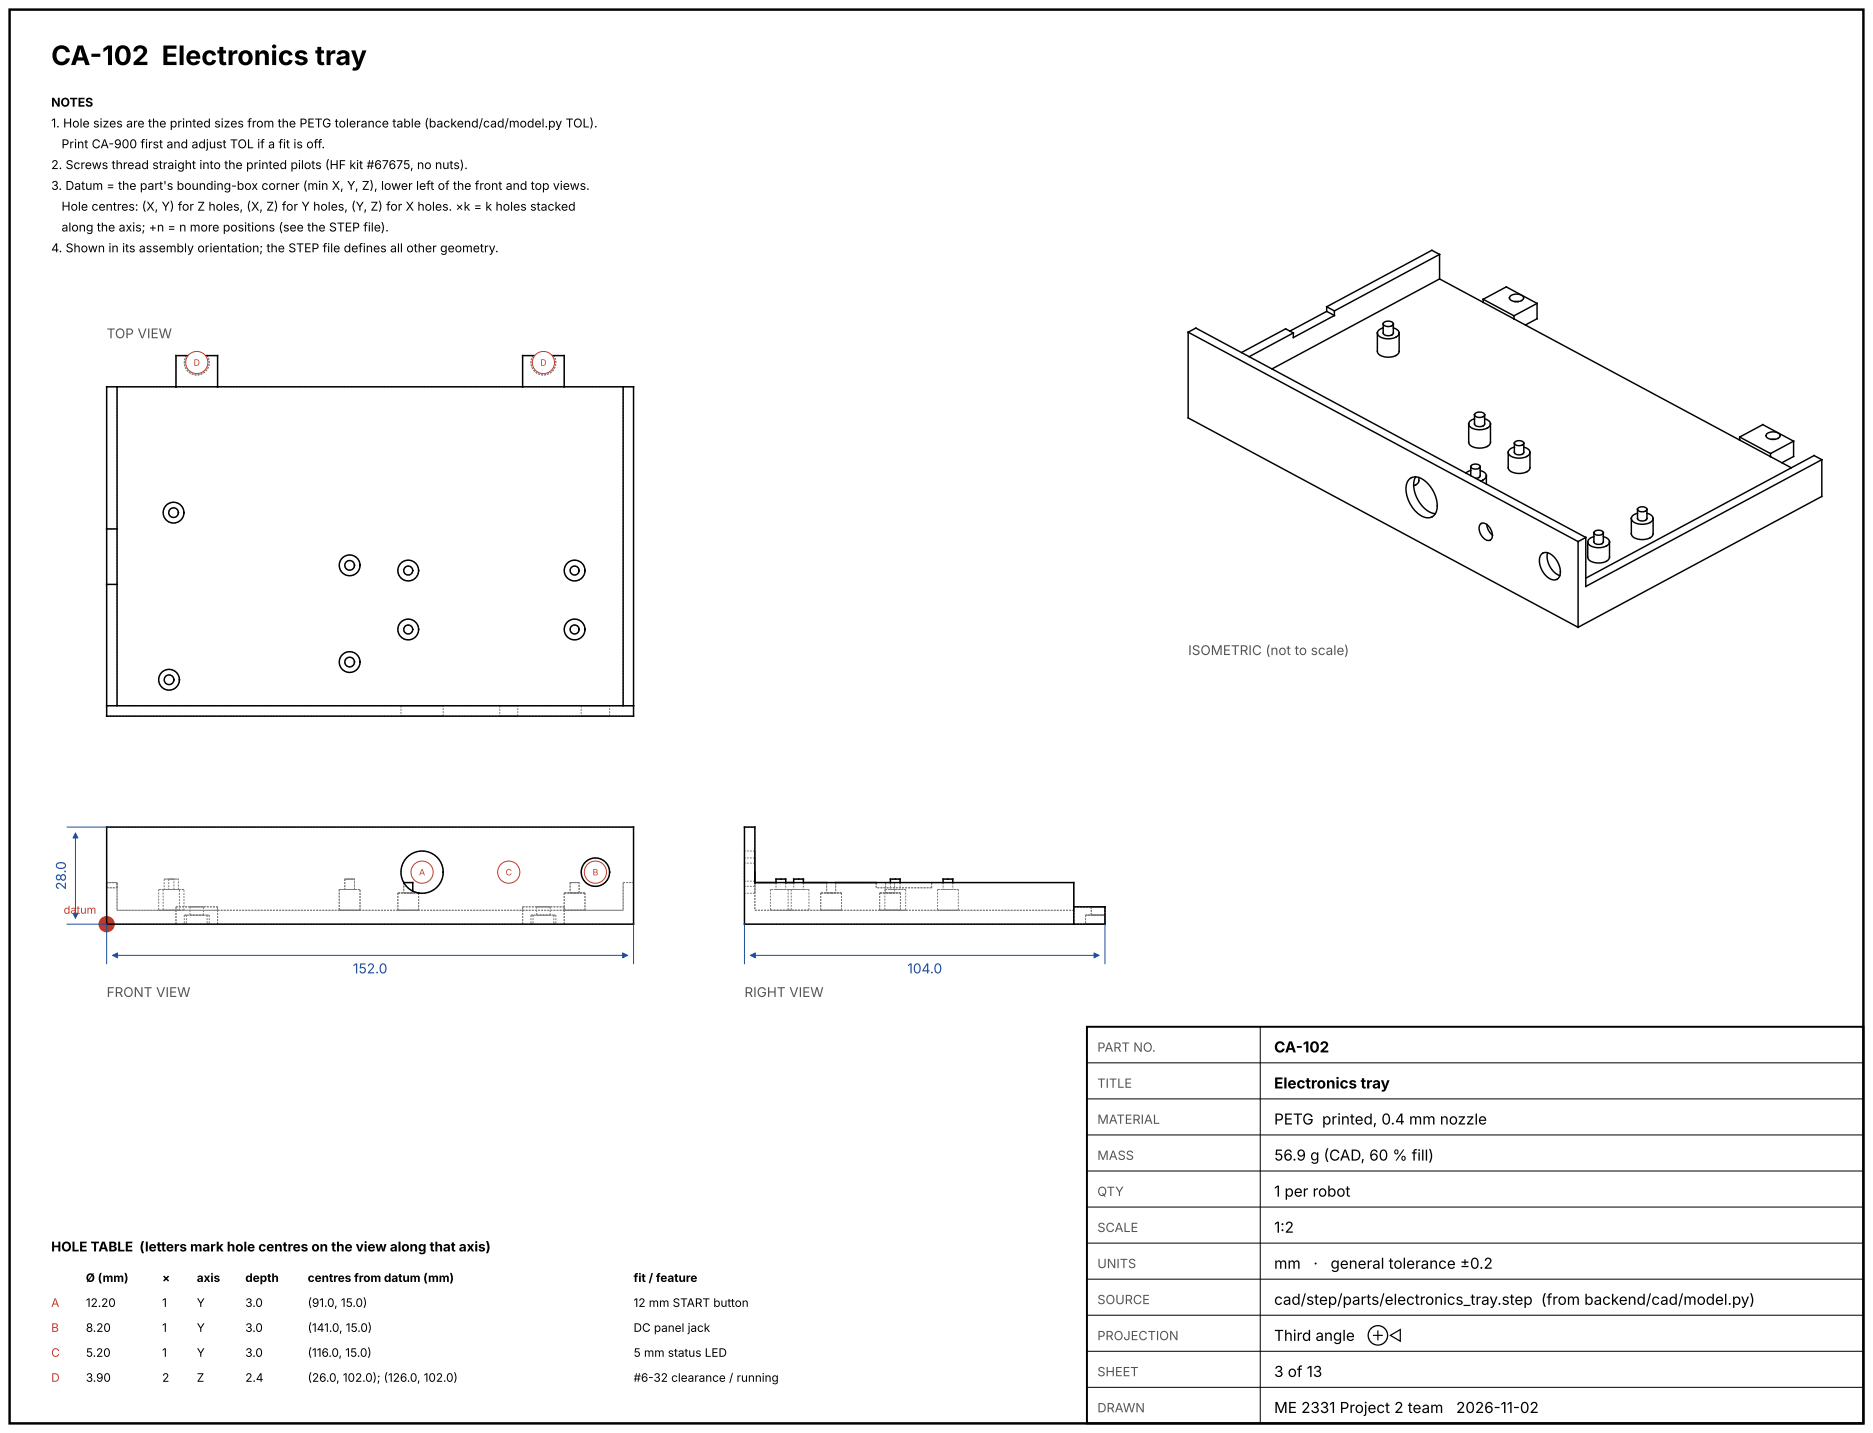
[picture p126: page 3]
PROJECTION; Third angle ⊕◁; SOURCE; cad/step/parts/electronics_tray.step (from backend/cad/model.py); UNITS; mm · general tolerance ±0.2; SCALE; QTY; 1 per robot; MASS; 56.9 g (CAD, 60 % fill); MATERIAL; PETG printed, 0.4 mm nozzle; TITLE; Electronics tray; PART NO.; FRONT VIEW; TOP VIEW; RIGHT VIEW; axis; depth; centres from datum (mm); fit / feature; 12 mm START button; DC panel jack; 5 mm status LED; #6-32 clearance / running; datum

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

4. Shown in its assembly orientation; the STEP file defines all other geometry.

ISOMETRIC (not to scale)

HOLE TABLE (letters mark hole centres on the view along that axis)

# CA-201 Turret plate

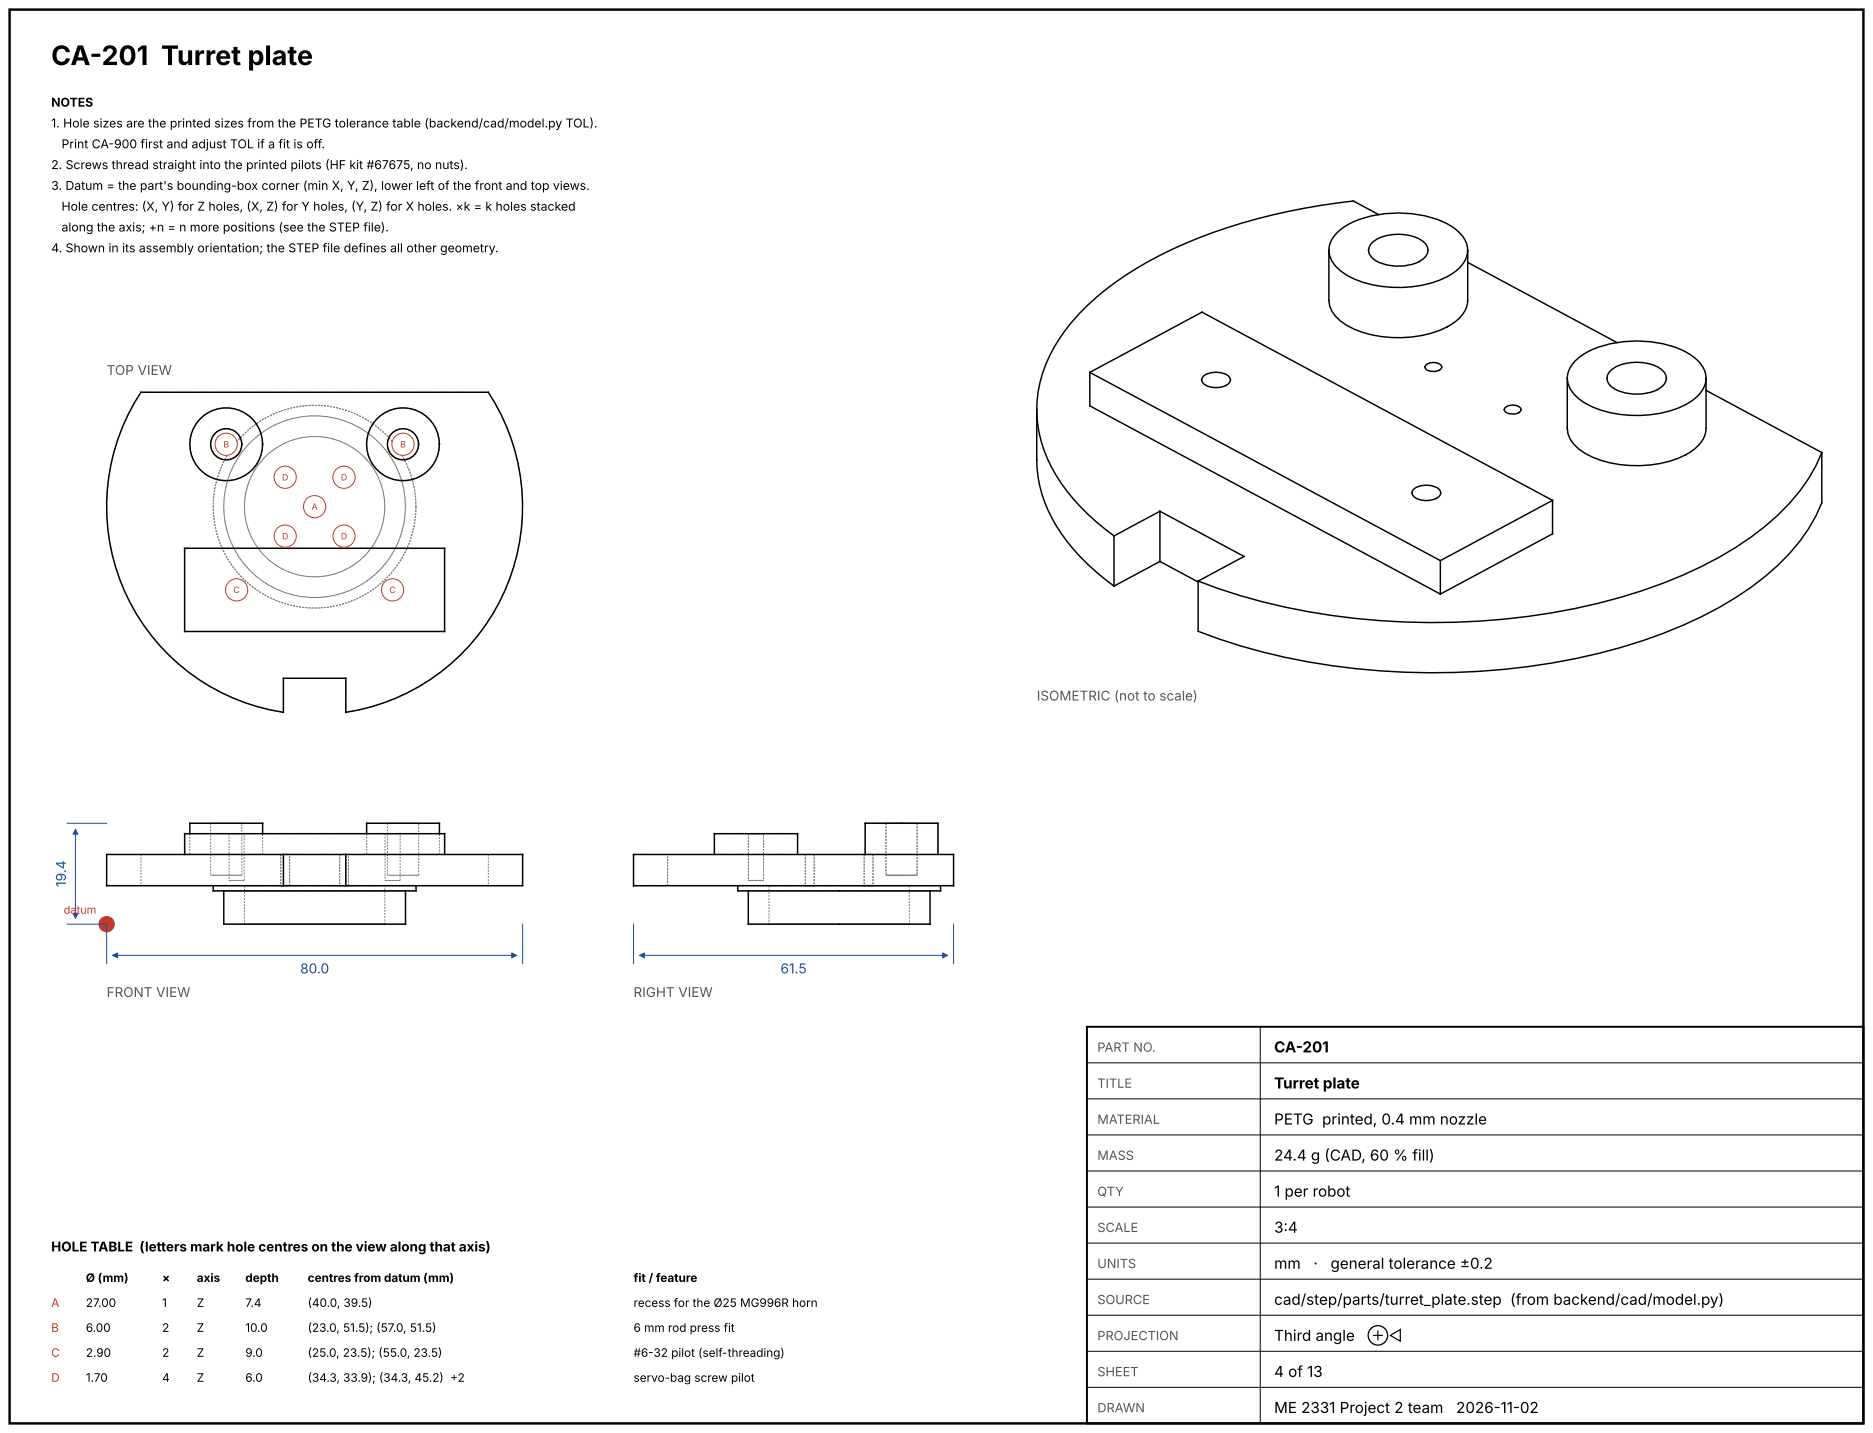
[picture p127: page 4]
PROJECTION; Third angle ⊕◁; SOURCE; cad/step/parts/turret_plate.step (from backend/cad/model.py); UNITS; mm · general tolerance ±0.2; SCALE; QTY; 1 per robot; MASS; 24.4 g (CAD, 60 % fill); MATERIAL; PETG printed, 0.4 mm nozzle; TITLE; Turret plate; PART NO.; FRONT VIEW; TOP VIEW; RIGHT VIEW; axis; depth; centres from datum (mm); fit / feature; recess for the Ø25 MG996R horn; 6 mm rod press fit; #6-32 pilot (self-threading); servo-bag screw pilot; datum

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

4. Shown in its assembly orientation; the STEP file defines all other geometry.

ISOMETRIC (not to scale)

HOLE TABLE (letters mark hole centres on the view along that axis)

# CA-202 Spine

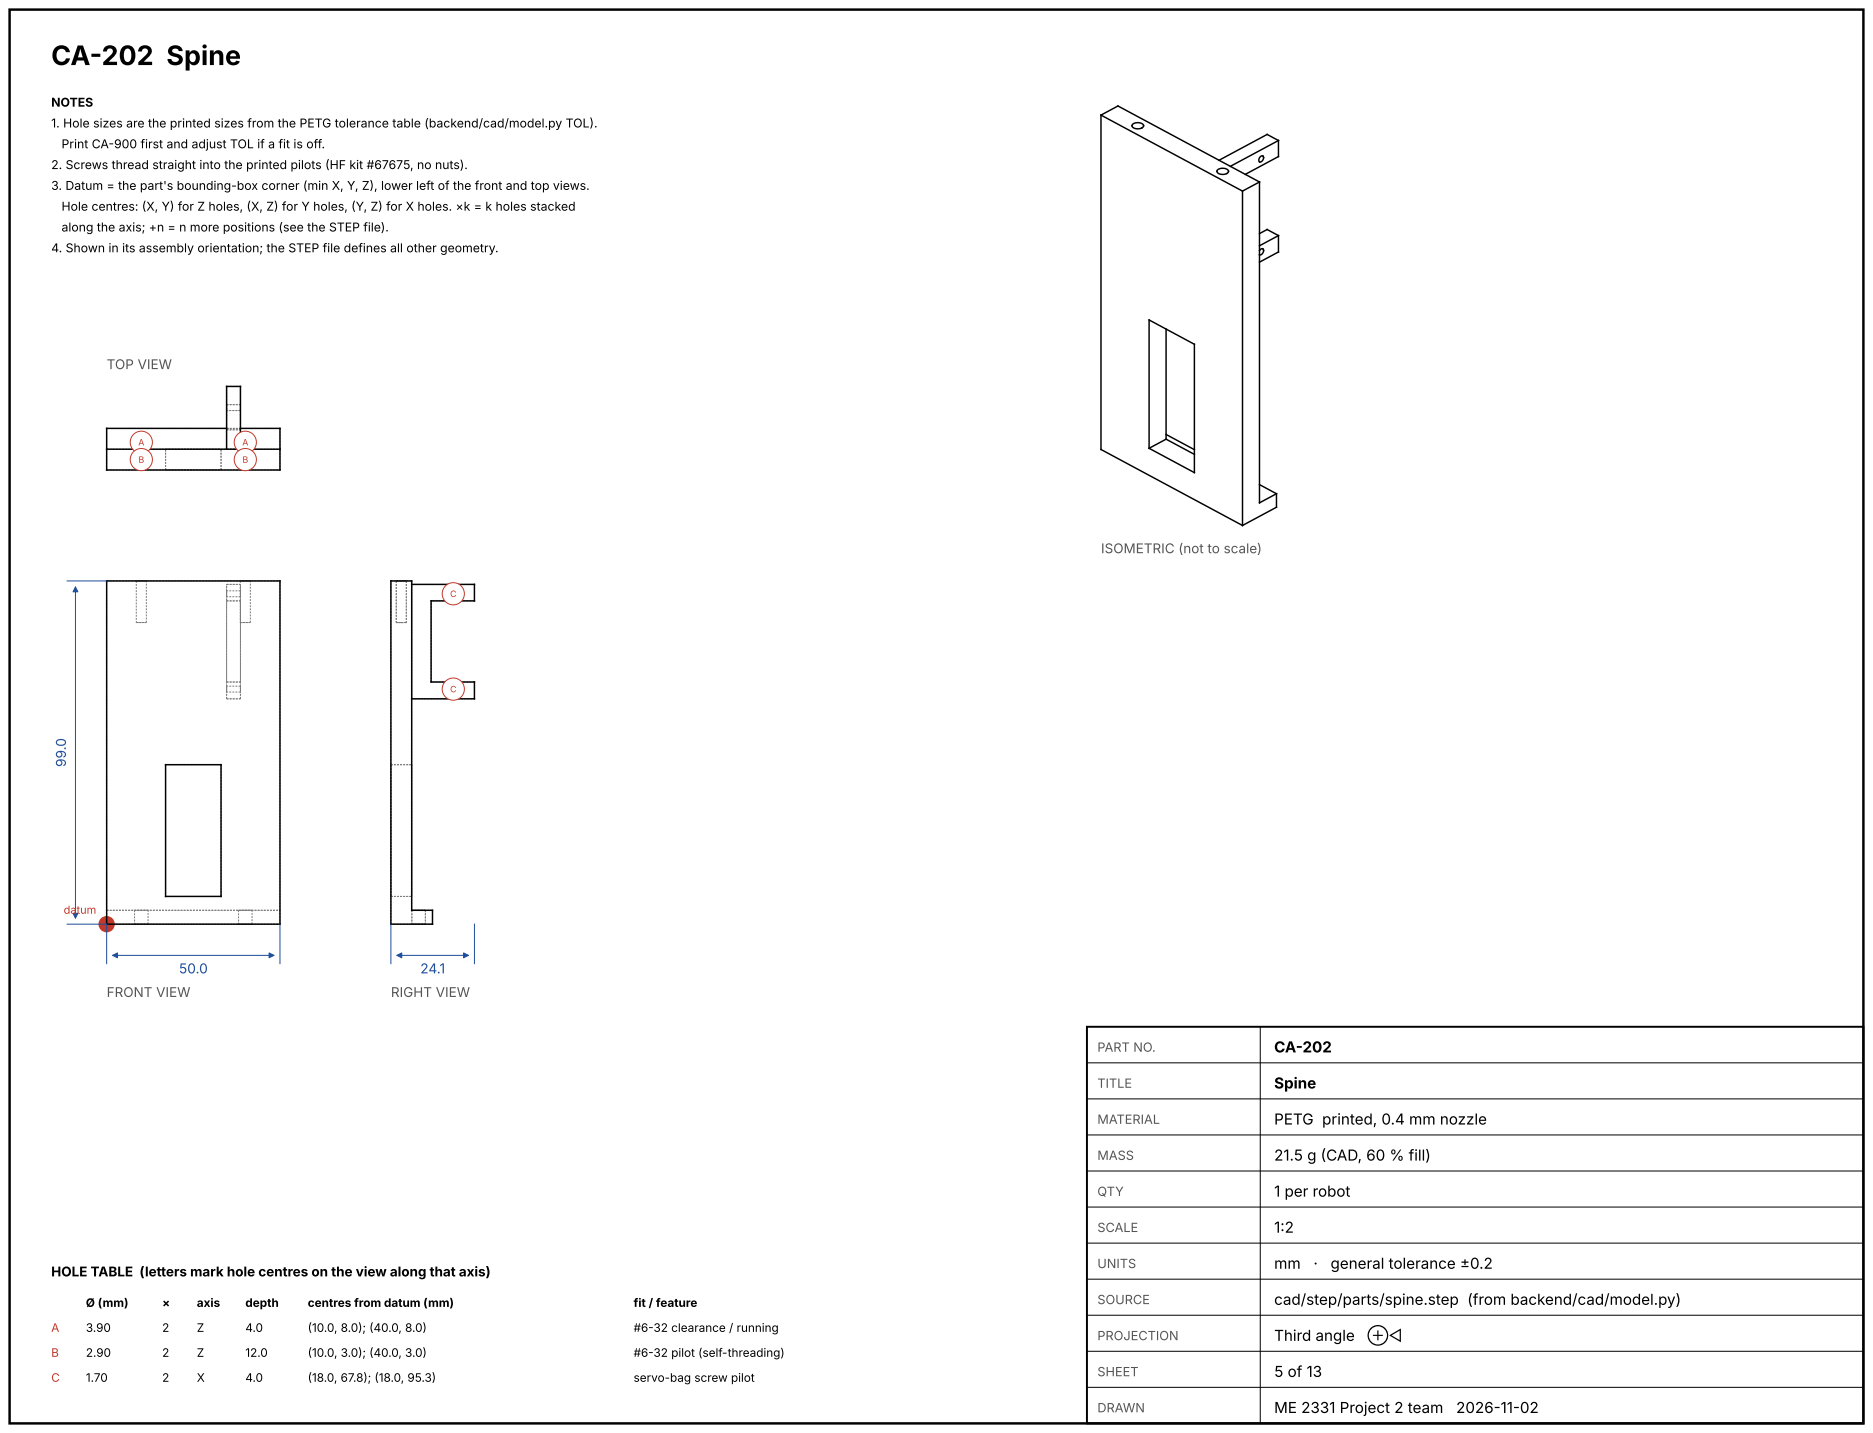
[picture p128: page 5]
PROJECTION; Third angle ⊕◁; SOURCE; cad/step/parts/spine.step (from backend/cad/model.py); UNITS; mm · general tolerance ±0.2; SCALE; QTY; 1 per robot; MASS; 21.5 g (CAD, 60 % fill); MATERIAL; PETG printed, 0.4 mm nozzle; TITLE; Spine; PART NO.; FRONT VIEW; TOP VIEW; RIGHT VIEW; axis; depth; centres from datum (mm); fit / feature; #6-32 clearance / running; #6-32 pilot (self-threading); servo-bag screw pilot; datum

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

4. Shown in its assembly orientation; the STEP file defines all other geometry.

ISOMETRIC (not to scale)

HOLE TABLE (letters mark hole centres on the view along that axis)

# CA-203 Top cap

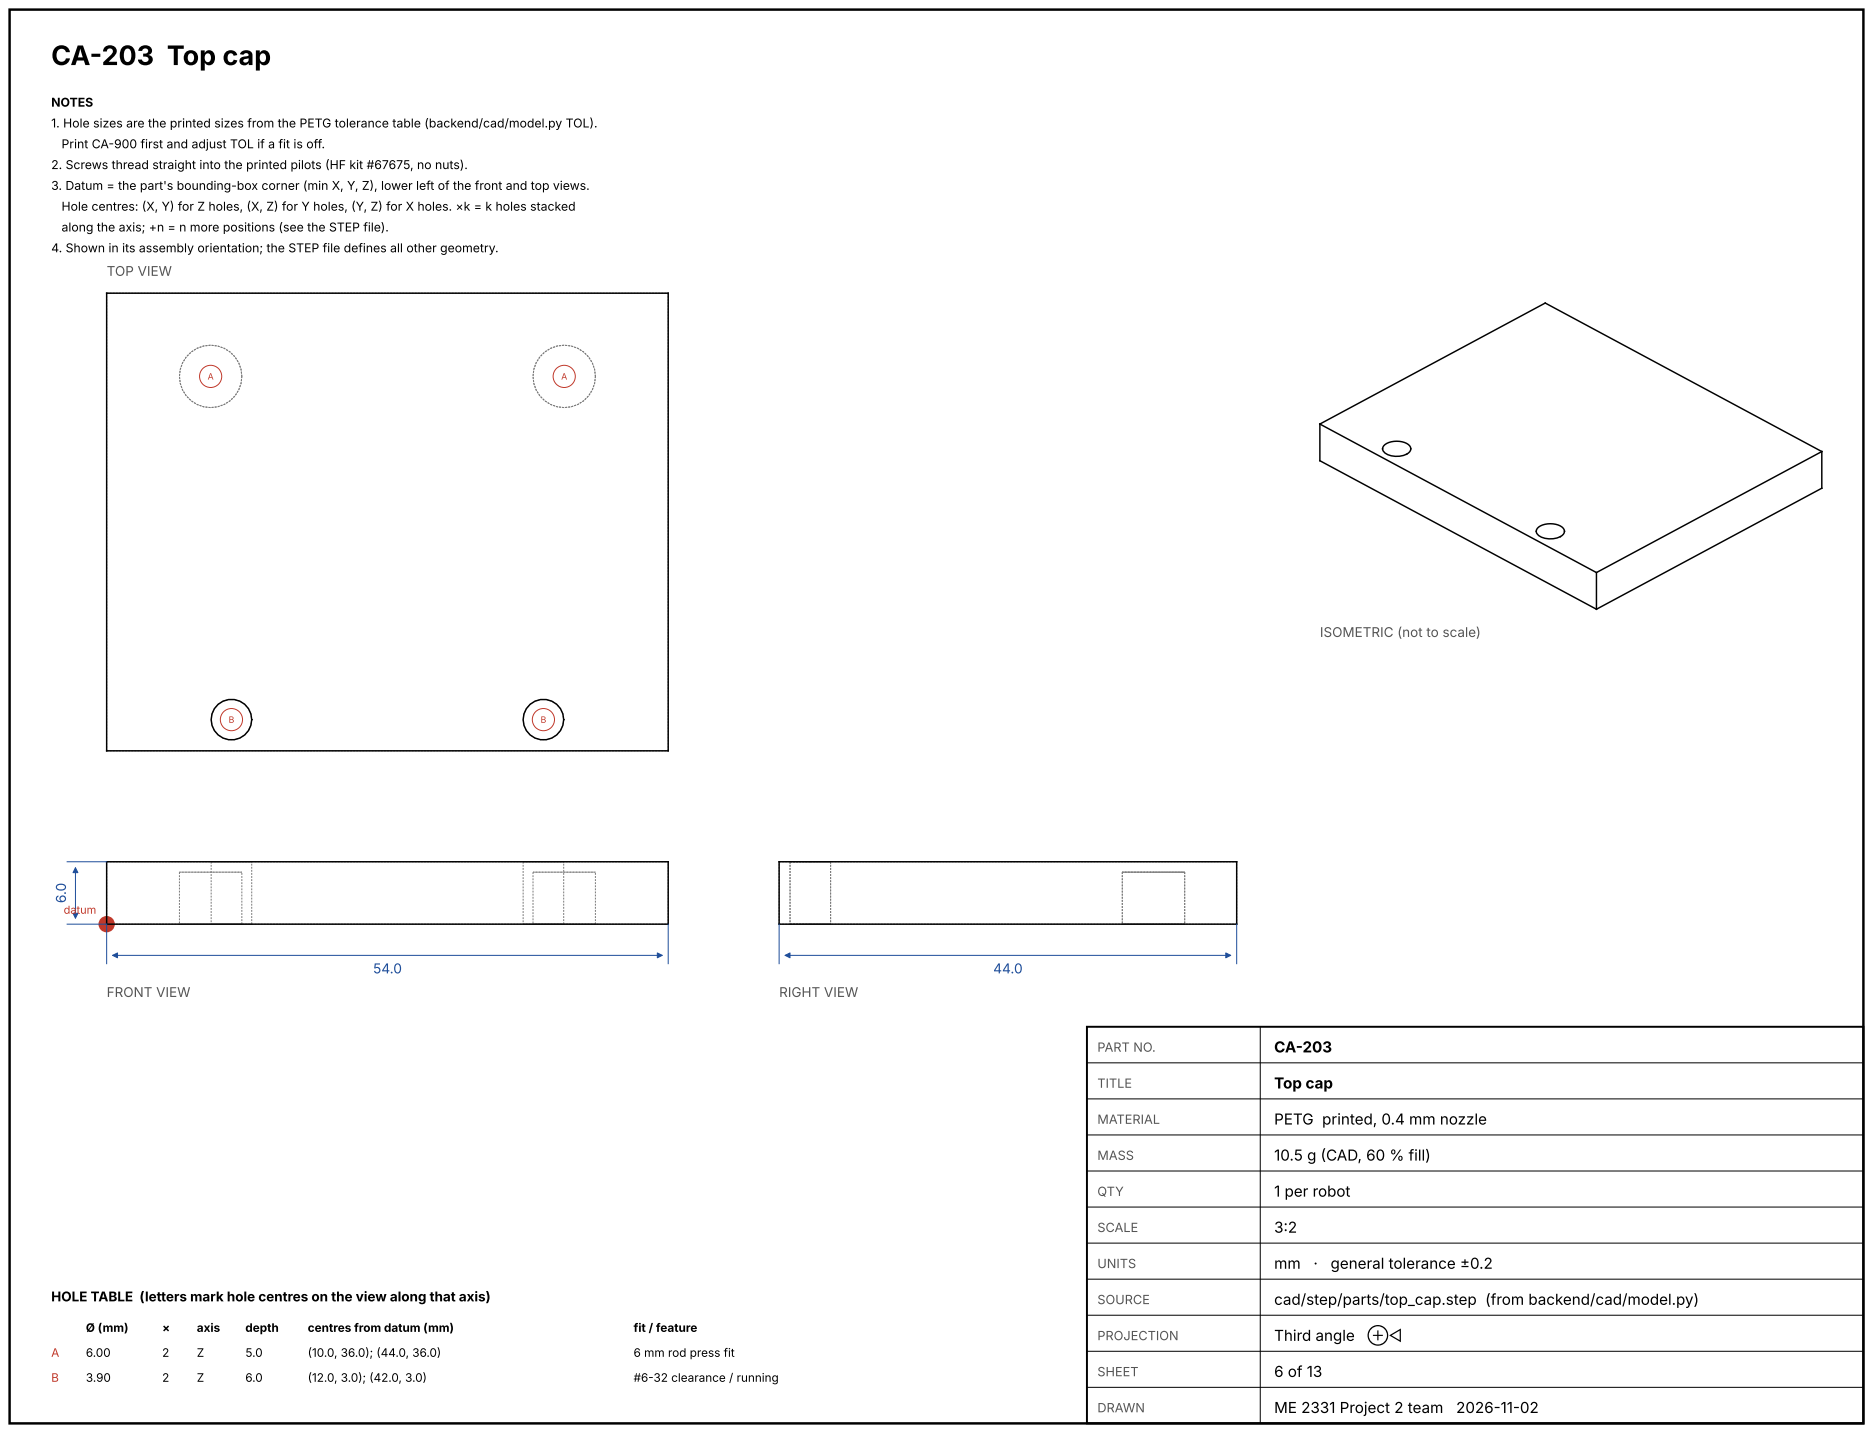
[picture p129: page 6]
PROJECTION; Third angle ⊕◁; SOURCE; cad/step/parts/top_cap.step (from backend/cad/model.py); UNITS; mm · general tolerance ±0.2; SCALE; QTY; 1 per robot; MASS; 10.5 g (CAD, 60 % fill); MATERIAL; PETG printed, 0.4 mm nozzle; TITLE; Top cap; PART NO.; FRONT VIEW; TOP VIEW; RIGHT VIEW; axis; depth; centres from datum (mm); fit / feature; 6 mm rod press fit; #6-32 clearance / running; datum

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

4. Shown in its assembly orientation; the STEP file defines all other geometry.

ISOMETRIC (not to scale)

HOLE TABLE (letters mark hole centres on the view along that axis)

# CA-301 Carriage + arm

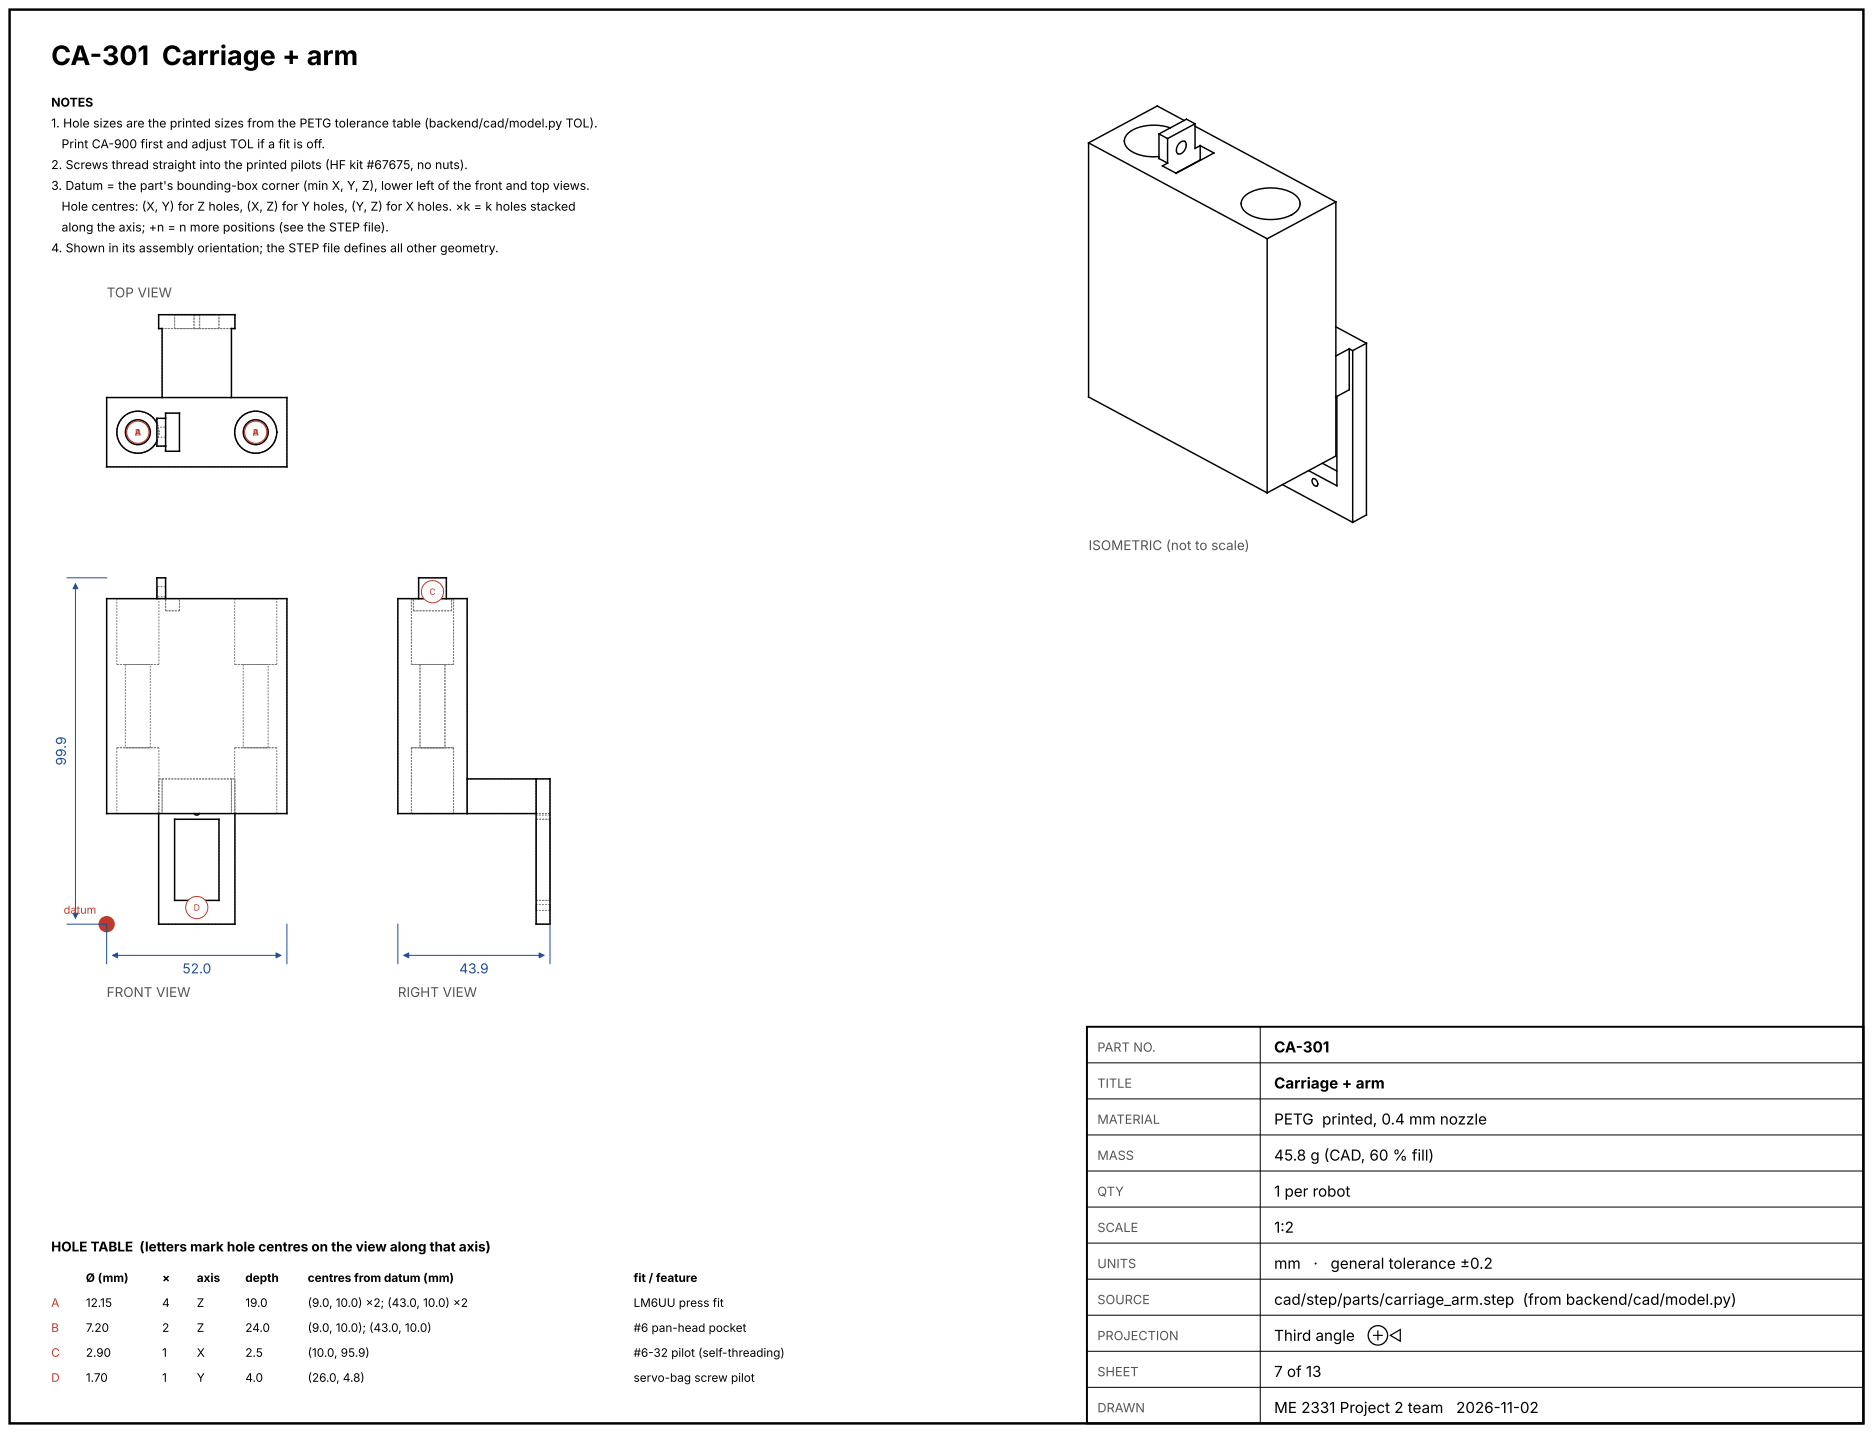
[picture p130: page 7]
PROJECTION; Third angle ⊕◁; SOURCE; cad/step/parts/carriage_arm.step (from backend/cad/model.py); UNITS; mm · general tolerance ±0.2; SCALE; QTY; 1 per robot; MASS; 45.8 g (CAD, 60 % fill); MATERIAL; PETG printed, 0.4 mm nozzle; TITLE; Carriage + arm; PART NO.; FRONT VIEW; TOP VIEW; RIGHT VIEW; axis; depth; centres from datum (mm); fit / feature; LM6UU press fit; #6 pan-head pocket; #6-32 pilot (self-threading); servo-bag screw pilot; datum

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

4. Shown in its assembly orientation; the STEP file defines all other geometry.

ISOMETRIC (not to scale)

HOLE TABLE (letters mark hole centres on the view along that axis)

# CA-302 Lift link

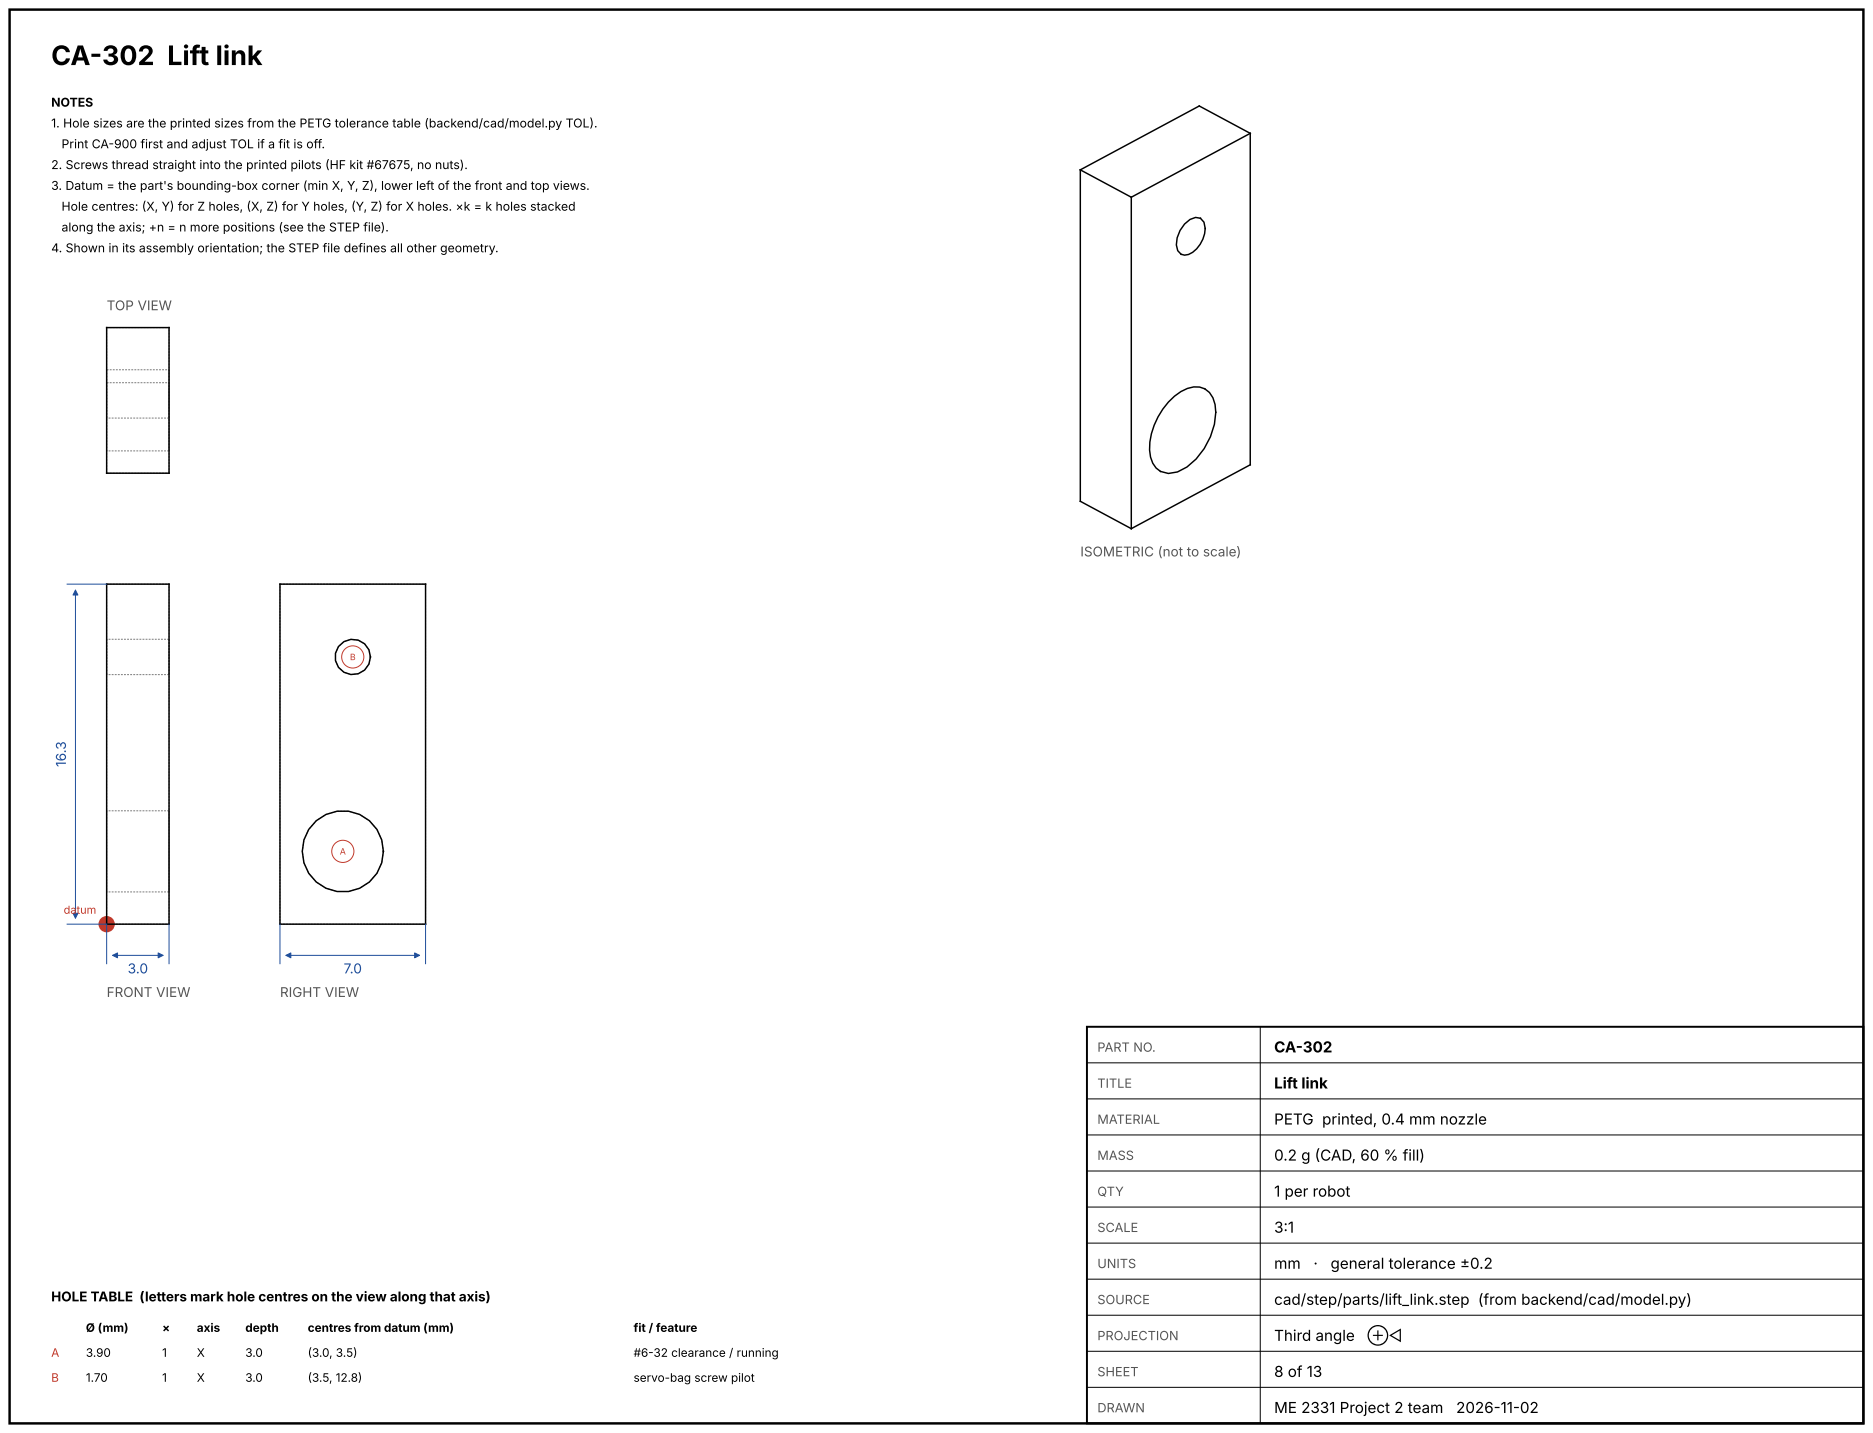
[picture p131: page 8]
PROJECTION; Third angle ⊕◁; SOURCE; cad/step/parts/lift_link.step (from backend/cad/model.py); UNITS; mm · general tolerance ±0.2; SCALE; QTY; 1 per robot; MASS; 0.2 g (CAD, 60 % fill); MATERIAL; PETG printed, 0.4 mm nozzle; TITLE; Lift link; PART NO.; FRONT VIEW; TOP VIEW; RIGHT VIEW; axis; depth; centres from datum (mm); fit / feature; #6-32 clearance / running; servo-bag screw pilot; datum

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

4. Shown in its assembly orientation; the STEP file defines all other geometry.

ISOMETRIC (not to scale)

HOLE TABLE (letters mark hole centres on the view along that axis)

# CA-401 Gripper frame

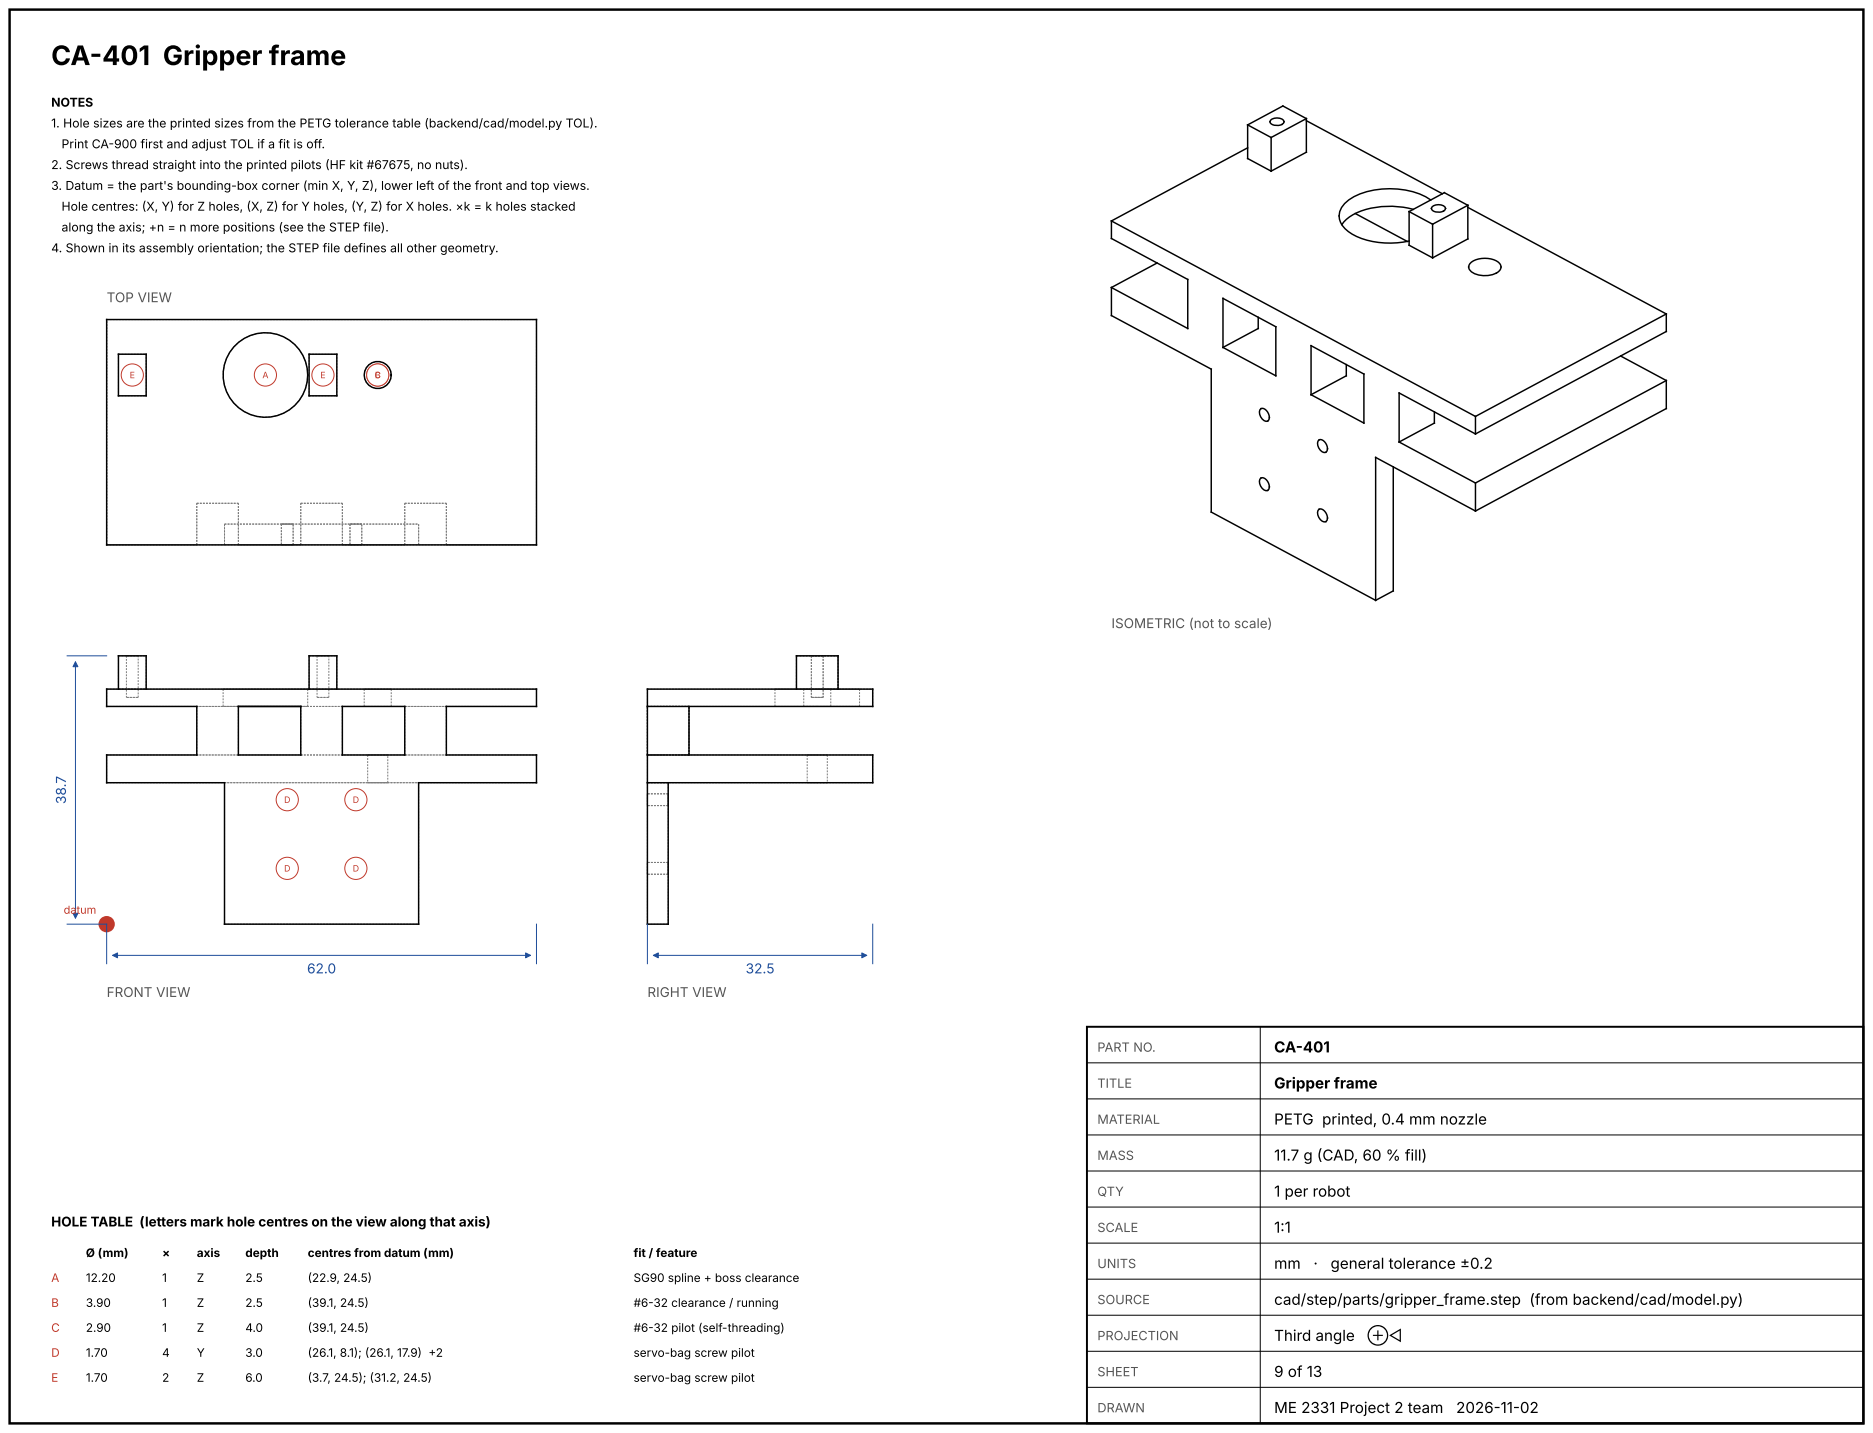
[picture p132: page 9]
PROJECTION; Third angle ⊕◁; SOURCE; cad/step/parts/gripper_frame.step (from backend/cad/model.py); UNITS; mm · general tolerance ±0.2; SCALE; QTY; 1 per robot; MASS; 11.7 g (CAD, 60 % fill); MATERIAL; PETG printed, 0.4 mm nozzle; TITLE; Gripper frame; PART NO.; FRONT VIEW; TOP VIEW; RIGHT VIEW; axis; depth; centres from datum (mm); fit / feature; SG90 spline + boss clearance; #6-32 clearance / running; #6-32 pilot (self-threading); servo-bag screw pilot; datum

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

4. Shown in its assembly orientation; the STEP file defines all other geometry.

ISOMETRIC (not to scale)

HOLE TABLE (letters mark hole centres on the view along that axis)

# CA-402 Finger, right

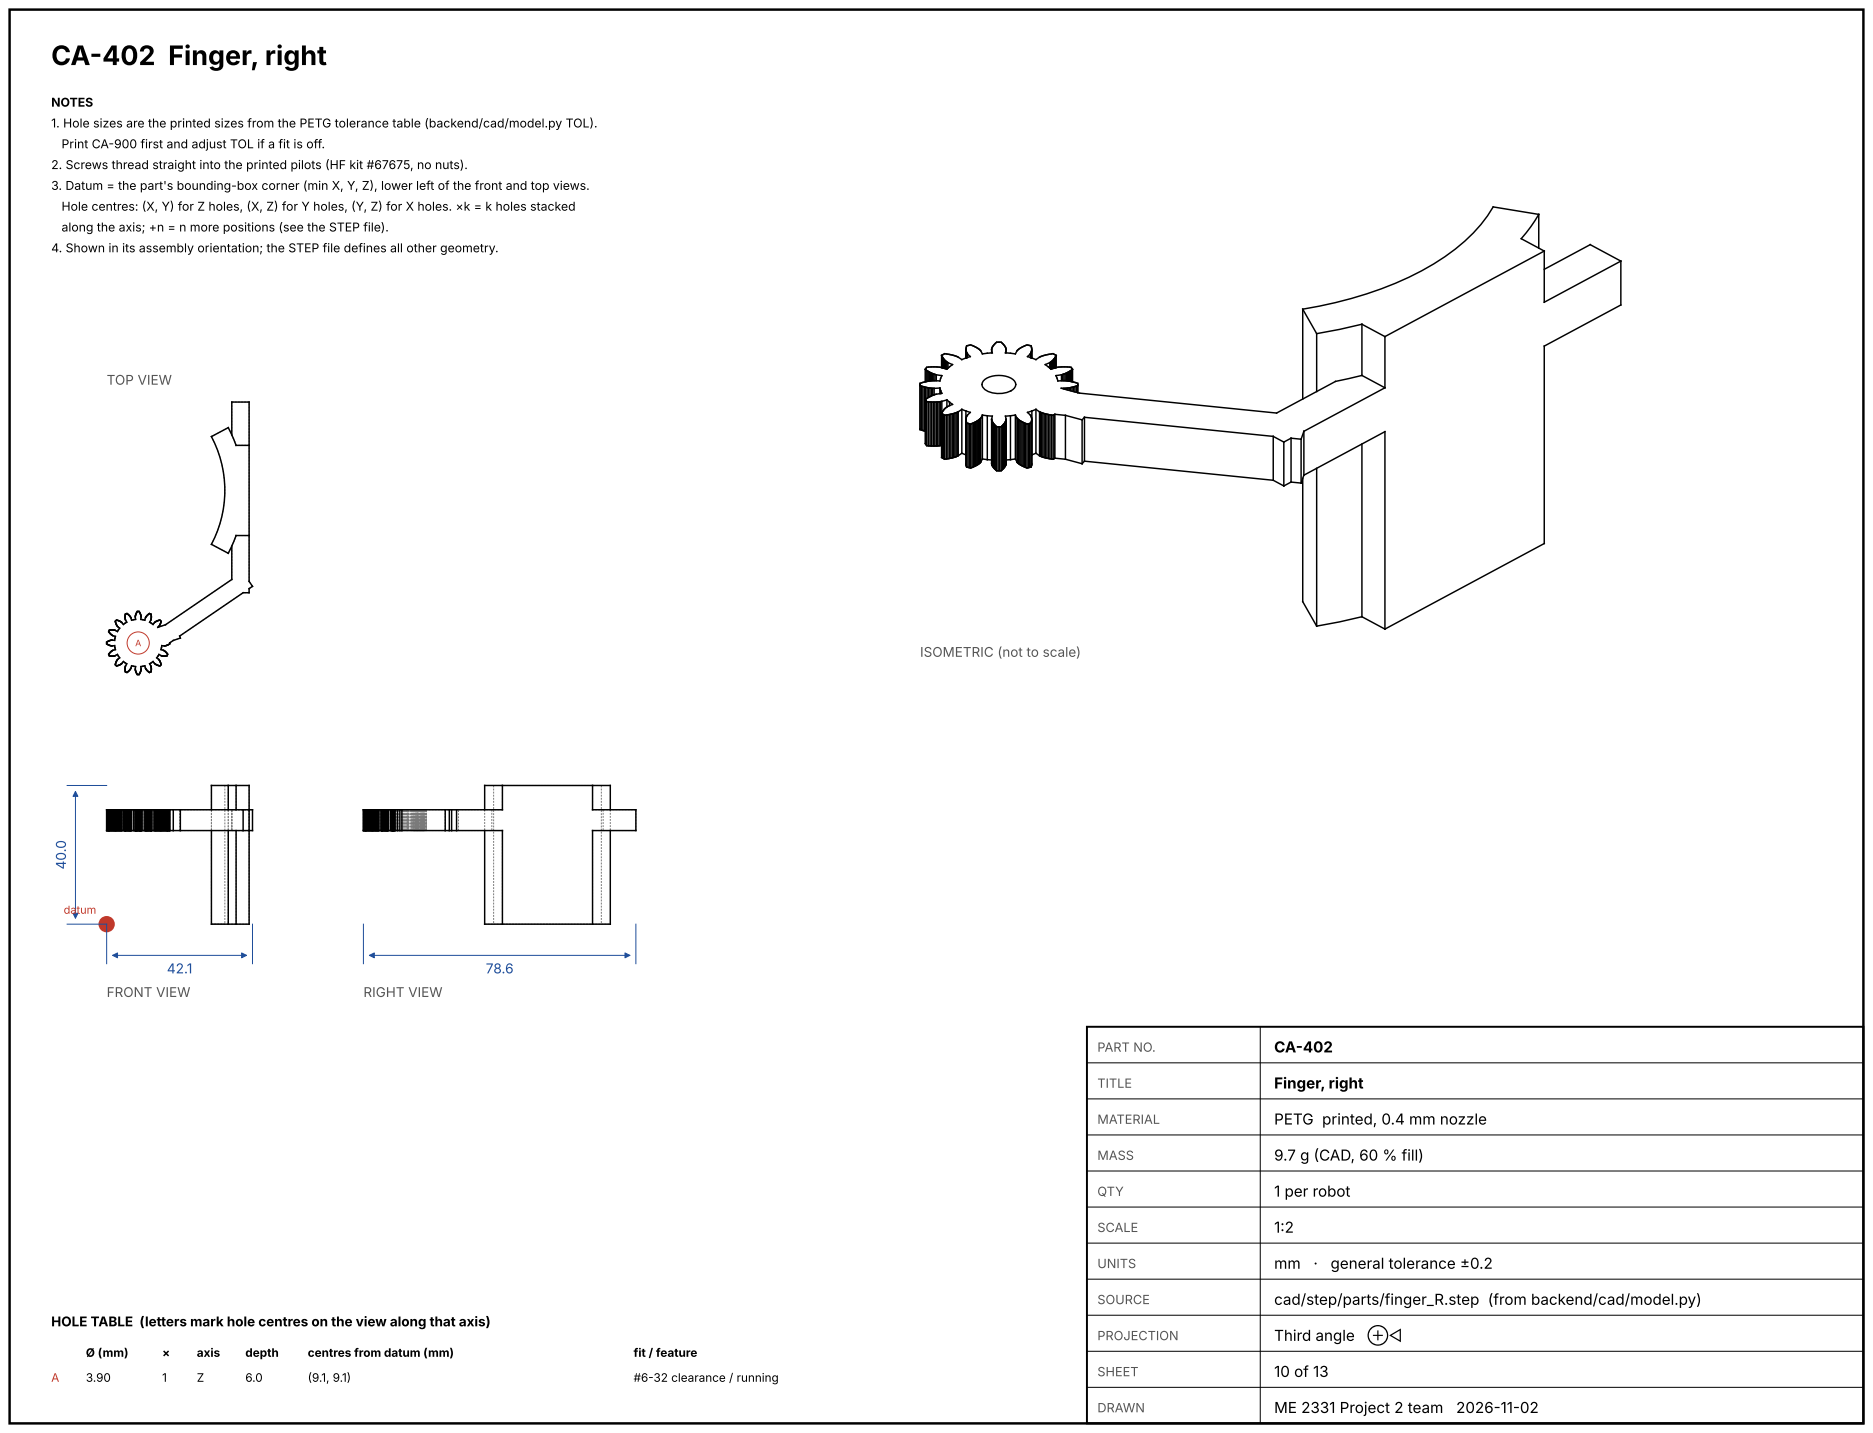
[picture p133: page 10]
PROJECTION; Third angle ⊕◁; SOURCE; cad/step/parts/finger_R.step (from backend/cad/model.py); UNITS; mm · general tolerance ±0.2; SCALE; QTY; 1 per robot; MASS; 9.7 g (CAD, 60 % fill); MATERIAL; PETG printed, 0.4 mm nozzle; TITLE; Finger, right; PART NO.; FRONT VIEW; TOP VIEW; RIGHT VIEW; axis; depth; centres from datum (mm); fit / feature; #6-32 clearance / running; datum

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

4. Shown in its assembly orientation; the STEP file defines all other geometry.

ISOMETRIC (not to scale)

HOLE TABLE (letters mark hole centres on the view along that axis)

# CA-403 Finger, left

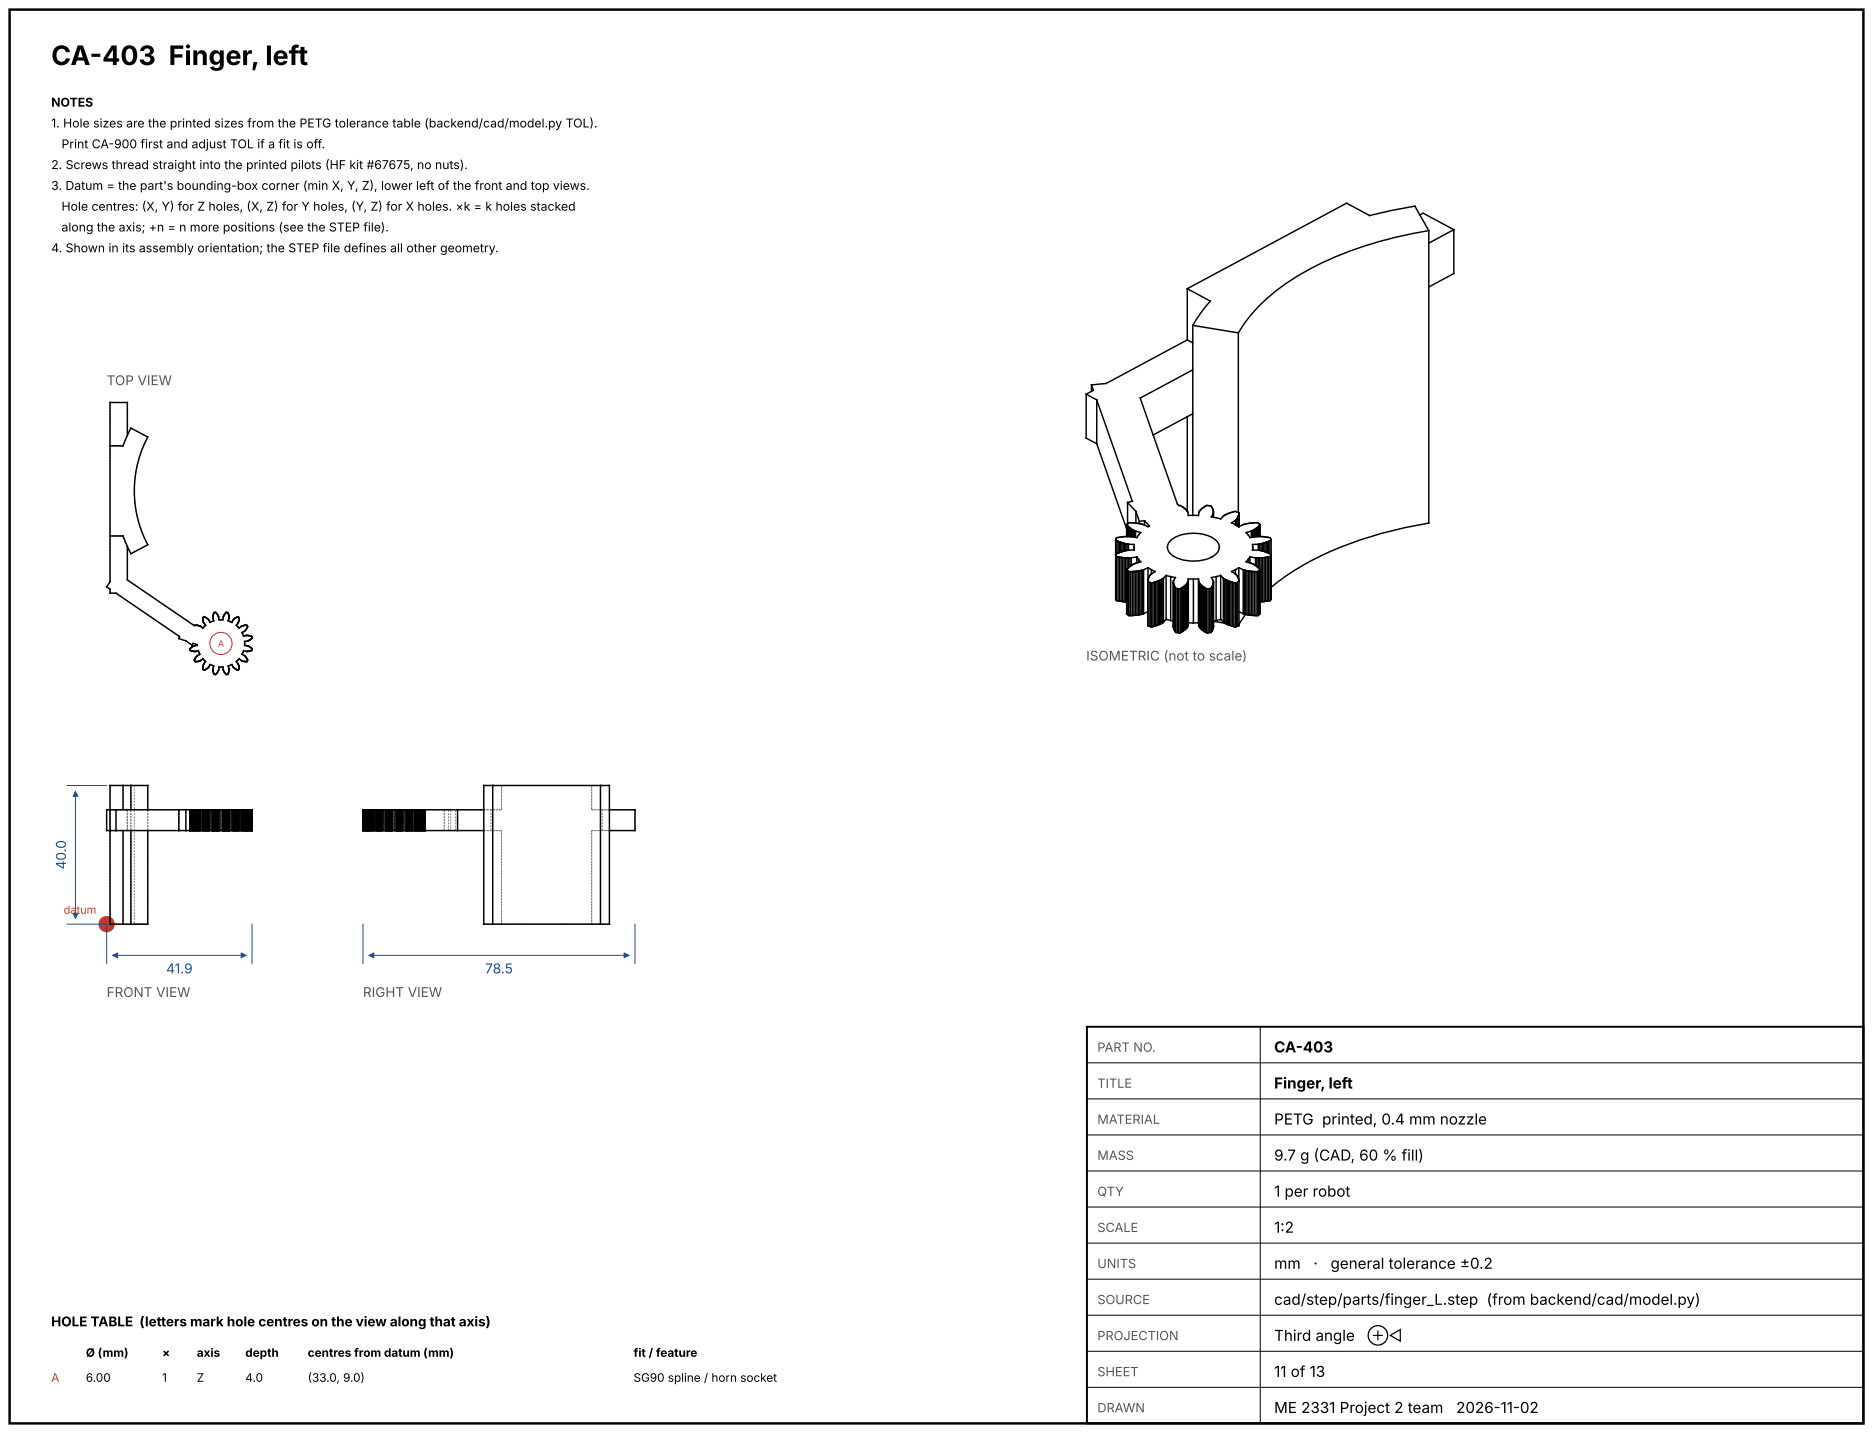
[picture p134: page 11]
PROJECTION; Third angle ⊕◁; SOURCE; cad/step/parts/finger_L.step (from backend/cad/model.py); UNITS; mm · general tolerance ±0.2; SCALE; QTY; 1 per robot; MASS; 9.7 g (CAD, 60 % fill); MATERIAL; PETG printed, 0.4 mm nozzle; TITLE; Finger, left; PART NO.; FRONT VIEW; TOP VIEW; RIGHT VIEW; axis; depth; centres from datum (mm); fit / feature; SG90 spline / horn socket; datum

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

4. Shown in its assembly orientation; the STEP file defines all other geometry.

ISOMETRIC (not to scale)

HOLE TABLE (letters mark hole centres on the view along that axis)

# CA-404 Can bumper

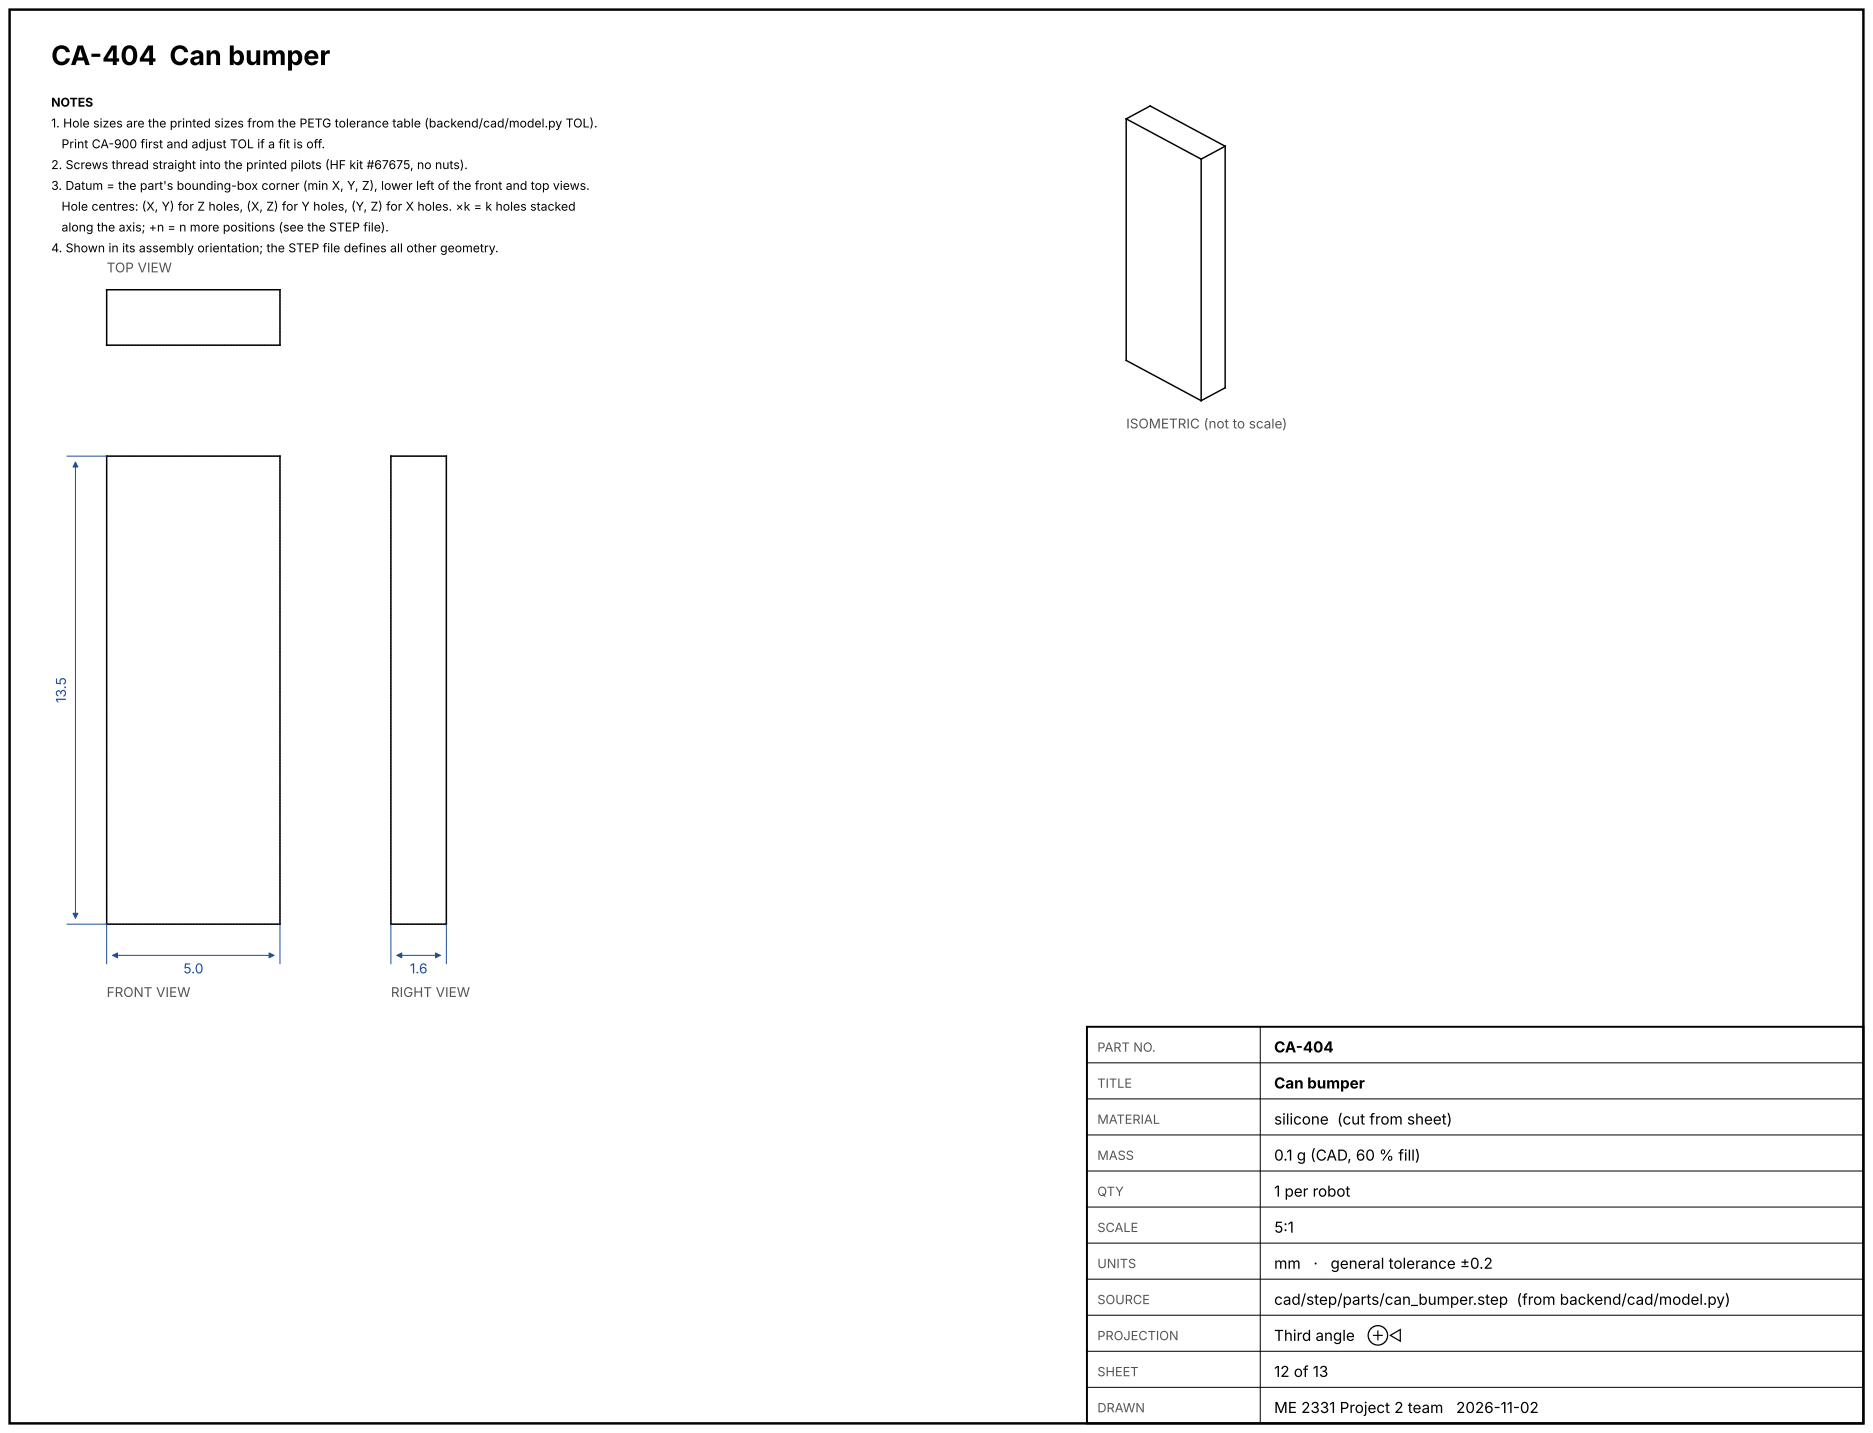
[picture p135: page 12]
PROJECTION; Third angle ⊕◁; SOURCE; cad/step/parts/can_bumper.step (from backend/cad/model.py); UNITS; mm · general tolerance ±0.2; SCALE; QTY; 1 per robot; MASS; 0.1 g (CAD, 60 % fill); MATERIAL; silicone (cut from sheet); TITLE; Can bumper; PART NO.; FRONT VIEW; TOP VIEW; RIGHT VIEW

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

4. Shown in its assembly orientation; the STEP file defines all other geometry.

ISOMETRIC (not to scale)

# CA-900 Tolerance coupon

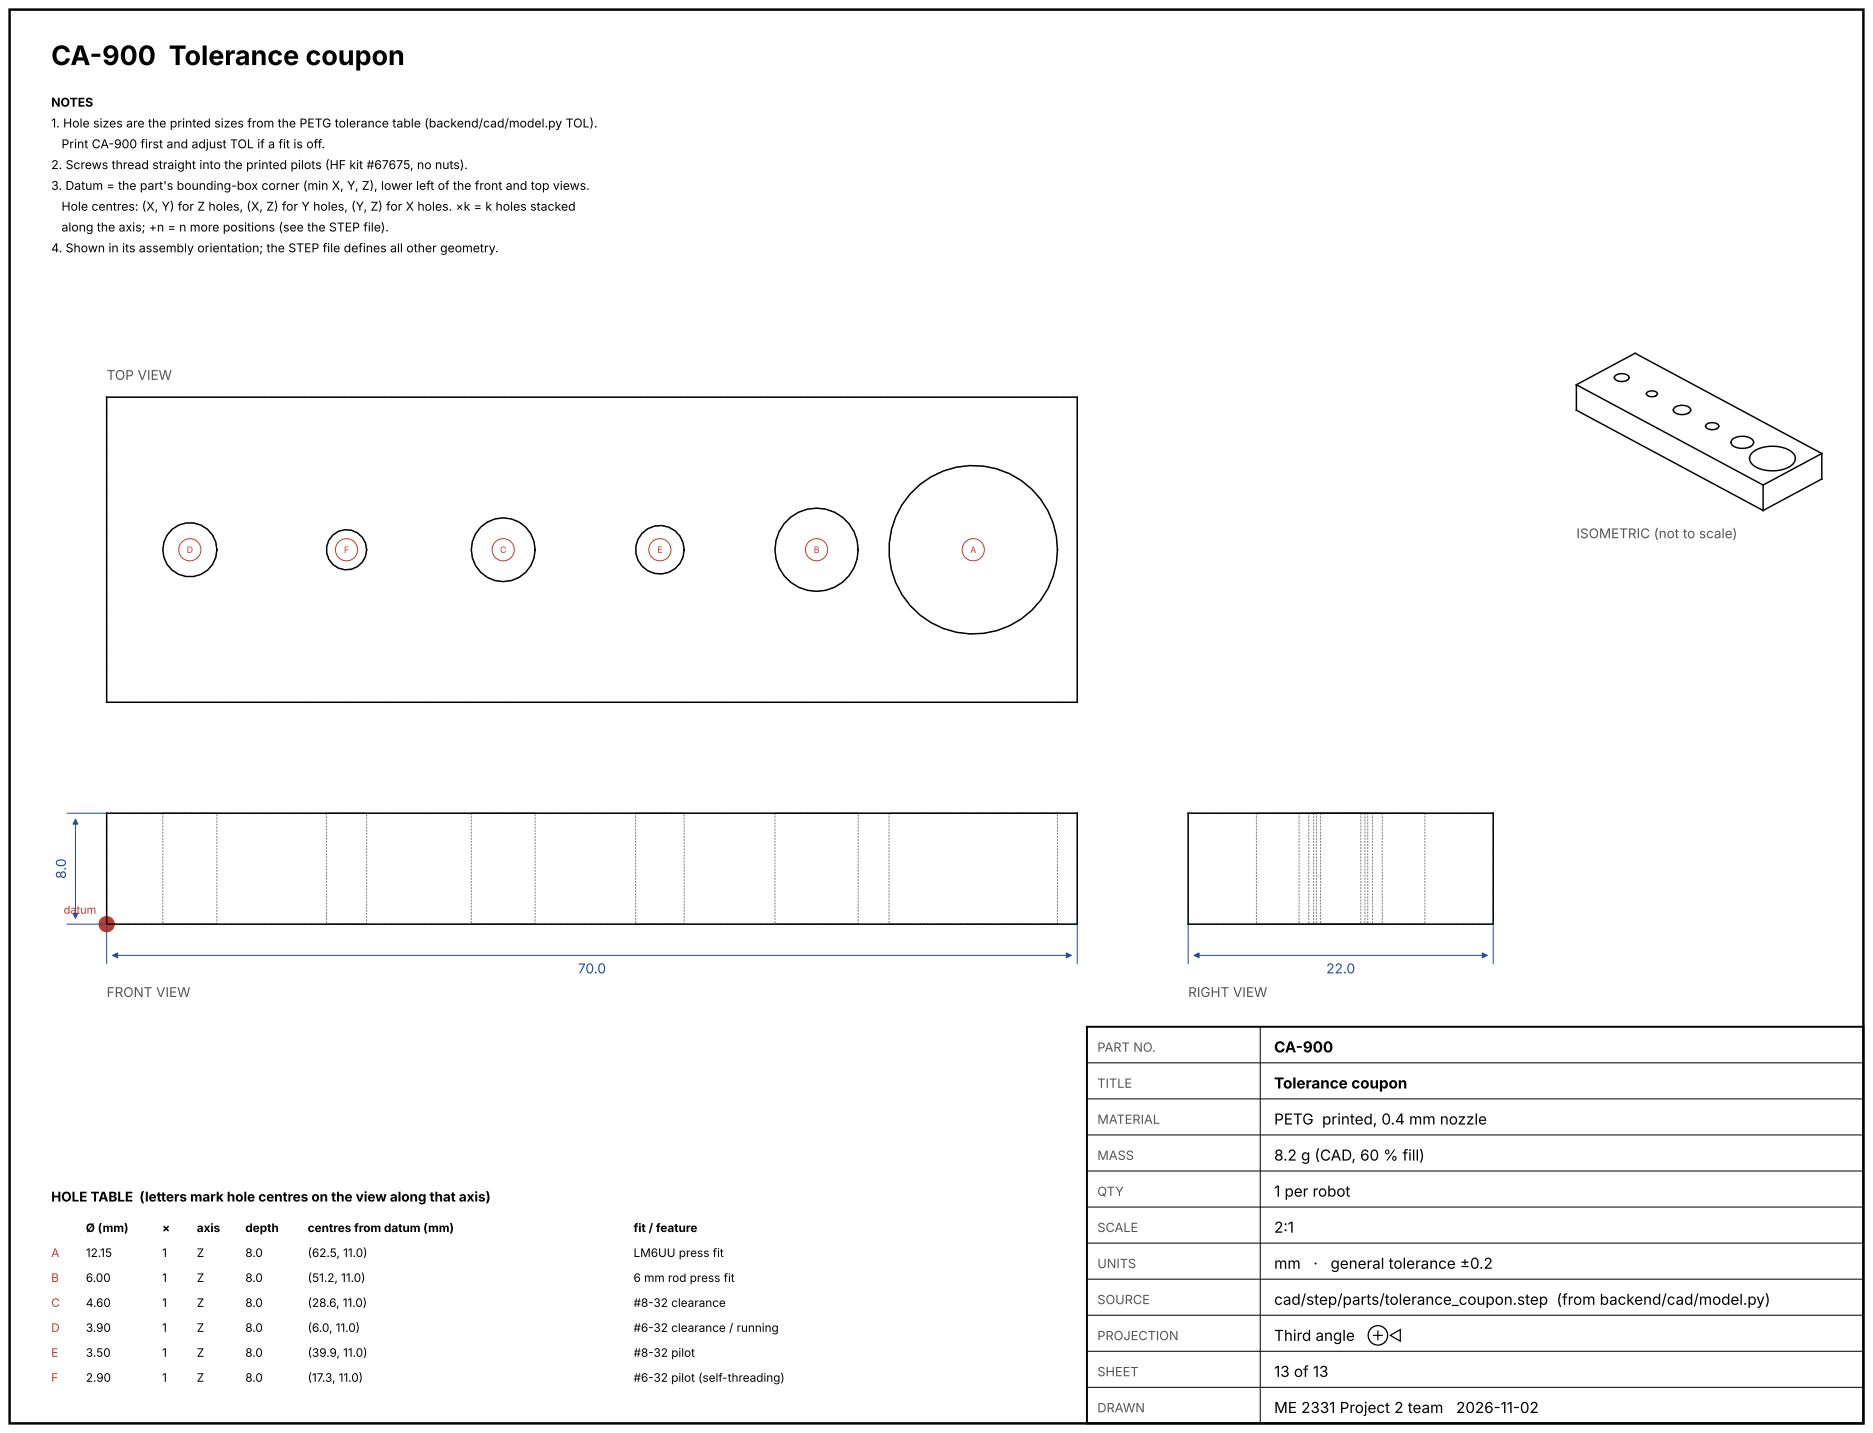
[picture p136: page 13]
PROJECTION; Third angle ⊕◁; SOURCE; cad/step/parts/tolerance_coupon.step (from backend/cad/model.py); UNITS; mm · general tolerance ±0.2; SCALE; QTY; 1 per robot; MASS; 8.2 g (CAD, 60 % fill); MATERIAL; PETG printed, 0.4 mm nozzle; TITLE; Tolerance coupon; PART NO.; FRONT VIEW; TOP VIEW; RIGHT VIEW; axis; depth; centres from datum (mm); fit / feature; LM6UU press fit; 6 mm rod press fit; #8-32 clearance; #6-32 clearance / running; #8-32 pilot; #6-32 pilot (self-threading); datum

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

4. Shown in its assembly orientation; the STEP file defines all other geometry.

ISOMETRIC (not to scale)

HOLE TABLE (letters mark hole centres on the view along that axis)
