jackpham-rgb/MEproject2026F/EE/ltspice/concept_a.asc

CRAIL: cap; 1000u
DLED: diode; YLED
I_grip: current; PWL file=pwl/i_grip.txt
I_lift: current; PWL file=pwl/i_lift.txt
I_turn: current; PWL file=pwl/i_turn.txt
I_wrist: current; PWL file=pwl/i_wrist.txt
ISTALL: current; PULSE(0 {2.5*STALL} 4.8 1m 1m 0.5 100)
IUNO: current; 0.045
LCORD: ind; 1.5e-06
R13: res; 220
RADP: res; 0.15
RBOUT: res; 0.03
RCORD: res; 0.1
RESR: res; 0.08
RIN_D5: res; 10k
RIN_D6: res; 10k
RIN_D9: res; 10k
RIN_D10: res; 10k
RJACK: res; 0.01
RL_grip: res; 0.13
RL_lift: res; 0.13
RL_turn: res; 0.08
RL_wrist: res; 0.13
RPIN13: res; 25
RPIN_D5: res; 25
RPIN_D6: res; 25
RPIN_D9: res; 25
RPIN_D10: res; 25
RPU: res; 35k
RRAIL: res; 0.05
RVIN: res; 0.05
VADP: voltage; 12.0
VBTN: voltage; PWL file=pwl/btn_ctrl.txt
VLED_D13: voltage; PWL file=pwl/led_D13.txt
VSIG_D5: voltage; PWL file=pwl/sig_D5.txt
VSIG_D6: voltage; PWL file=pwl/sig_D6.txt
VSIG_D9: voltage; PWL file=pwl/sig_D9.txt
VSIG_D10: voltage; PWL file=pwl/sig_D10.txt
Named nets: adp, 0, n1, n2, n3, vin, bo2, bk, bkr, rail, nc, v_turn, v_lift, v_wrist, v_grip, vinu, pin_d9_src, d9, pin_d10_src, d10, pin_d6_src, d6, pin_d5_src, d5, d13src, d13, led_a, uno5v, d4, btnc
BBUCK bo 0 V=5.8
VSENSE bo bo2 0
BBIN vin 0 I=5.8*I(VSENSE)/(0.9*max(V(vin),1))
XL4015 buck (averaged model): 5.8 V out, input current = Pout / (eff x Vin)
CIN vin cinn 220u IC=12
RCIN cinn 0 0.1
VRAIL bk bkr 0
Turntable MG996R
Lift MG90S
Wrist MG90S
Gripper SG90
BREG uno5v 0 V=min(5.0,V(vinu)-2.1)
RREGL uno5v 0 1meg
Uno on VIN: M7 diode + NCP1117 regulator
D9: Turntable MG996R
D10: Lift MG90S
D6: Wrist MG90S
D5: Gripper SG90
SBTN d4 0 btnc 0 SWBTN
START button = switch d4 -> GND, closed while V(btnc) > 0.5 V
.model YLED D(IS=4e-19 N=2 RS=2)
.model SWBTN SW(Ron=0.1 Roff=1e9 Vt=0.5 Vh=0.1)
.tran 1m 16.520 0 2m uic
.step param STALL list 0 1
Concept A, power design B (12 V adapter, XL4015 buck 5.8 V for the servos, Uno on VIN) + servo PWM pulses (D9, D10, D6, D5 back to back each 20 ms) in firmware order. STALL=1 adds a 0.5 s MG996R stall in the middle of TURN. Generated by backend/ee/ee_calcs.py.
Plot: V(rail), V(uno5v), V(d9), V(d10), V(d6), V(d5), V(d13), V(d4), I(I_turn)+I(I_lift)+I(I_wrist)+I(I_grip)
