jackpham-rgb/MEproject2026F/(commit log)

2026-09-25 Phase 1 (laptop-only) design package for Project 2 can flipper
    - Four concepts + weighted decision matrix; selects a mirror-flip design
    (one 180 deg turn about a 45 deg horizontal axis flips and relocates the can)
    - Python geometry/clearance sweep, flip-axis plant + pole-placement PID with
    feedforward, grip-force loop sim, telemetry plotter
    - Uno firmware: 200 Hz Timer2 tick, quadrature ISR, state machine with fault
    handling, CSV telemetry, system-ID mode; hardware-free core tested on host
    - Host regression test (nominal, parameter spread, fault injection) and an
    avr-gcc + simavr script that runs the real AVR binary against a plant model
    - Draft RVTM, BOM, pin map, SolidWorks CAD bri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
    [simavr_sim_plant_run.csv]
2026-09-25 Add 3D viewer, concept CAD export, part-collision check; move can sensor
    - sim/mechanism.py: block-level part geometry (single source) and a 0-180 deg
    part-vs-part collision sweep. It found the counterweight path crossing the
    home post and the under-arm HC-SR04; home stop moved to a hub tab by the
    tower, can detection moved to an IR proximity sensor in the palm (D11)
    - cad/build_cad.py: CadQuery STEP assembly (fixed + flip_arm groups) and
    per-part STEP/STL; cad/README.md has Fusion 360 / SolidWorks motion steps
    - viewer/: interactive three.js replay of the firmware's simulated run with
    synced telemetry charts, wiring diagram and plots (tools/build_viewer.py)
    - Docs, Wokwi diagram a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
    [arm.step, arm.stl, base_plate.step, base_plate.stl, can_flipper_assembly.step, counterweight.step, counterweight.stl, cw_arm.step]
2026-09-25 Add animated four-concept comparison page; redefine Concept B
    Concept B (tip twice, then slide) displaced the can past the robot, so it is
    now a cradle that flips in place and drags the can 90 deg on the table; matrix
    rescored (B 2.30, D still selected). Can top material fixed in both viewers.
    Claude-Session: https://claude.ai/code/session_019RiFonUX9C1wD2R3xZiymF
2026-09-29 Add plain student-notes Word doc (how it works, materials, BOM)
    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
2026-09-29 Add Concept A 4-servo firmware, Wokwi diagram and Tinkercad guide
    Single-file sketch (Servo library only) runs grip, lift, flip, turn 90,
    lower, release with eased moves; returns home only after the can is removed.
    Verified on an emulated ATmega328P. Notes doc return step corrected.
    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
    [concept_a.ino]
2026-09-29 Switch the repo to Concept A as the selected design
    - New Concept A design analysis, CAD brief, wiring/BOM, RVTM and PDR plan;
    Concept D docs, Wokwi and notes moved to docs/concept_d and wokwi/concept_d
    - sim/concept_a.py: lift clearance, grip, servo loads, lift jam check
    (printed slide jams, LM6UU fine), error budget, power; reads the firmware
    - cad/build_cad_concept_a.py: STEP assembly with fixed/turret/lift/wrist groups
    - tools/emulate_concept_a.sh: builds and runs the sketch on an emulated Uno
    - Team decision matrix (A 3.85, B 3.30, D 3.00, C 2.75) with the calculation
    - Concepts page defaults to A; README and setup guide point at Concept A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
    [arm.step, arm.stl, arm_L.step, arm_L.stl, arm_R.step, arm_R.stl, base_box.step, base_box.stl]
2026-11-02 Add printable-level Concept A CAD with full motion and collision check
    - cad/concept_a_detail/model.py: every part (real servo/bearing/rod/Uno
    envelopes, holes from a PETG tolerance table, HF #67675 kit screws threaded
    into printed pilots, no nuts) plus the robot kinematics
    - check.py: runs the firmware sequence (289 poses) with solid-boolean
    collision checks, table clearance, can landing, pad contact, tip-over on the
    real footprint, CAD mass and servo loads; all pass
    - Fixes found by the check: 6807 bearing tower instead of the lazy-susan,
    base cut away in the sweep sector, servo turned away from the arm, D turret
    plate, posts moved, hub raised, pads cover the can's middle
    - Fir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
    [LM6UU_L1.step, LM6UU_L2.step, LM6UU_R1.step, LM6UU_R2.step, arduino_uno.step, axle_R.step, base.step, base.stl]
2026-11-02 Coke can, wiring diagram, BOM; reorganize repo to Concept A only
    - Model the standard 12 oz Coke can (66.2 x 122.2 mm, tapered ends); grip axis
    61.1 mm, finger pivots y 83, carriage/lift servo +2 mm, narrower can bumper.
    Full firmware-sequence check passes (no collisions, can lands inverted).
    - Fritzing-style wiring diagram (tools/make_wiring_diagram.py) + docs/04_wiring.md
    - Top-level BOM (tools/make_bom.py -> docs/05_bom.md, docs/bom.csv)
    - Flatten cad/concept_a_detail -> cad/; renumber docs (03 detail design,
    04 wiring, 05 BOM, 06 RVTM, 07 PDR); move the concept notes to docs/draft/
    - Remove Concept D firmware/sims/docs and the block-level CAD (kept in history)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
    [LM6UU_L1.step, LM6UU_L2.step, LM6UU_R1.step, LM6UU_R2.step, arduino_uno.step, arm.step, arm.stl, arm_L.step]
2026-11-02 Regenerate detail CAD GIF with the Coke can
    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
2026-11-02 EE calcs + LTspice, binary decision matrices, BOM reasons; 5 V adapter, no optional parts
    - EE/: servo PWM signals replayed from the firmware in exact order (Timer1 pulses
    D9, D10, D6, D5 per 20 ms frame), current budget, rail voltage in ngspice,
    LTspice netlists/schematic + PWL files, LED/button values
    - Power: one 5 V 4 A wall adapter feeds servos and the Uno 5V pin; buck removed
    from wiring, CAD and BOM (power decision matrix: 8/9 vs 9 V battery 4/9)
    - Removed the optional IR/FSR sensors and the 270-degree wrist option; wrist is
    an MG90S with a 500-2500 us pulse range; Wokwi gets the status LED
    - BOM: why-we-need-it and alternative-rejected columns for every part
    - docs/decision_m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
    [LM6UU_L1.step, LM6UU_L2.step, LM6UU_R1.step, LM6UU_R2.step, arduino_uno.step, axle_R.step, base.step, bearing_6807.step]
2026-11-02 Re-run circuit + CAD checks with power limits; keep the buck converter
    - EE: simulate both power designs (5 V adapter direct vs 12 V adapter + XL4015
    at 5.8 V) in ngspice for a normal run, an MG996R stall, and power-up away
    from home; check every limit (Uno 4.5 V, servo 4.8-6.0 V, adapter/buck
    current, breadboard contact current, regulator heat, USB back-feed)
    - Result: both pass the normal run; only the buck design passes the fault
    cases (Uno 5.00 V vs 4.43 V, servos >= 5.5 V vs 4.25 V) and allows USB
    during calibration -> buck restored (wiring, CAD, BOM, docs)
    - Firmware attaches servos 0.3 s apart (power-up rush 4.7 A -> one servo)
    - MG996R power goes straight to the buck termin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
    [LM6UU_L1.step, LM6UU_L2.step, LM6UU_R1.step, LM6UU_R2.step, arduino_uno.step, axle_R.step, base.step, bearing_6807.step]
2026-11-02 Part C: 2D drawings, engineering report, RVTM update
    - cad/drawings.py: 13 sheets (assembly + every designed part) from hidden-line
    projections of the CAD: third-angle views, overall dimensions, hole tables
    with fits and centre positions, title blocks -> docs/drawings/
    - tools/make_report.js: Part C engineering report (docx) with CAD images, wiring
    diagram, power analysis, code discussion, BOM and RVTM pulled from the repo,
    test plan with pass criteria for the build
    - RVTM updated with detail-design evidence; new derived requirements DR9-DR13
    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
2026-11-02 Build prep: print-ready STLs, build guide, servo setup sketch
    - cad/print_prep.py: every printed part turned to its best bed face (stable
    footprint, press-fit holes vertical where possible, least overhang);
    watertight STLs in print/stl/, orientation preview, print table
    - tools/make_build_guide.py -> docs/08_build_guide.md: shopping list with search
    terms (~$58), print order and PETG settings, tolerance-coupon checks, buck
    setup, step-by-step assembly with fasteners, wiring, calibration, tests
    - firmware/servo_setup: fit horns at HOME and jog servos from the Serial Monitor
    to find calibration angles (compiles, boots on the emulator)
    - Pad liners and can bumper from 1/16 in silicone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
    [CA-101_base.stl, CA-102_electronics_tray.stl, CA-201_turret_plate.stl, CA-202_spine.stl, CA-203_top_cap.stl, CA-301_carriage_arm.stl, CA-302_lift_link.stl, CA-401_gripper_frame.stl]
2026-11-02 Reorganize cad/: CAD files only, code moves to backend/cad/
    - cad/step/: concept_a_assembly.step (SolidWorks / Fusion) + parts/*.step +
    fusion_sequence.json
    - cad/print/: print-ready STLs (moved from print/)
    - cad/check/: collision report and mass table
    - backend/cad/: model, check, export, drawings, print_prep, Fusion script;
    viewer mesh in backend/cad/build/
    - Dropped the duplicate assembly-position STLs (the print-ready ones replace them)
    - cad/README.md: how to open and edit the STEP in SolidWorks; all paths updated
    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
    [CA-101_base.stl, CA-102_electronics_tray.stl, CA-201_turret_plate.stl, CA-202_spine.stl, CA-203_top_cap.stl, CA-301_carriage_arm.stl, CA-302_lift_link.stl, CA-401_gripper_frame.stl]
2026-11-02 Move all code into backend/
    - backend/ee/ee_calcs.py, backend/sim/concept_a.py, backend/tools/* (BOM, wiring
    diagram, viewers, report, build guide, emulator), backend/requirements.txt
    - Output folders keep only results: EE/, sim/ (was sim/out/), docs/, viewer/
    - backend/README.md: every generator, what it makes, and the rebuild order
    - README repo map rewritten by folder; all paths updated; full pipeline re-run
    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
    [decision_matrix_and_bom.xlsx]
2026-11-02 How it moves: motor/claw explanation + guided tour in the Fusion script
    - docs/09_how_it_moves.md: the 4 servos (pin, angles, mechanism), how the geared
    claw closes symmetrically, the sequence and why, how to show it in Fusion
    - fusion_animate.py: asks Guided tour? Yes = explains each motor before its move
    and plays slowly; No = full run with interference check; Play again? at the end
    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
2026-11-02 Claw-only Fusion demo: cad/claw/ + backend/cad/fusion_claw/
    - backend/cad/export_claw.py -> cad/claw/claw.step (gripper frame, SG90, both
    geared arms, can) and claw_sequence.json (precomputed arm motion: open, close
    on the can, hold, release 25 deg, open; firmware angles, eased, slowed down)
    - backend/cad/fusion_claw/: Fusion script with an explanation box, step + servo
    angle in the progress bar, and Play again
    - cad/claw/README.md with the open / closed / release preview
    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
    [claw.step]
2026-11-02 fusion_claw: compute arm rotations in the script (fix Fusion 'invalid argument')
    Fusion rejected the precomputed, rounded matrices as Occurrence.transform. The
    script now builds each arm's rotation about its pivot at full precision (same
    math as the model, verified to 0.0007 mm), checks setWithArray, and falls back
    to transform2 if transform is refused.
    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
    [claw.step]
2026-11-03 Real involute gears, base tips removed, full engineering check (43/43 pass)
    - Claw gears: 16T m1 20deg involute, profile shift +0.1 each (below the 17T
    undercut limit; fits the 16.2 mm pivots), 0.2 mm backlash. CAD: no overlap and
    a constant 0.1 mm flank gap over the full 75 deg; gears now checked as a pair
    - Can bumper narrowed to 5 mm so the tooth tips clear it (0.67 mm)
    - Base: the two sharp tips left by the sweep cut are chamfered with walls
    - backend/mech/mech_checks.py: inverse dynamics of all 4 servos from CAD masses
    and inertias, exact lift slider-crank (link tilt and real-pose clearance),
    gear contact ratio/undercut/Lewis, can friction through every acceleration,
    dynamic Z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
    [CA-101_base.stl, CA-402_finger_R.stl, CA-403_finger_L.stl, LM6UU_L1.step, LM6UU_L2.step, LM6UU_R1.step, LM6UU_R2.step, arduino_uno.step]
2026-11-04 Wire routing in 3D: 360 view, routing check, legend toggle, site index
    - backend/cad/wiring.py: every servo lead, jumper and power wire as a tube through the
    spine window, turret notch and base hole, with wrist / lift / turn service loops.
    Checked against all parts in 6 poses, loop slack >= 1.25x, lead lengths: all pass.
    Writes cad/wiring/wiring_harness.step + wiring_report.txt.
    - viewer/wiring_360.html: orbitable 360 view with a Legend on/off button;
    docs/wiring/ 360 GIF/MP4 with and without the legend, plus stills.
    - Tray: buck moved 12 mm back and breadboard 4 mm back (the START button and DC jack
    bodies were 7 mm from the buck); button, LED, jack and 1000 uF capacitor added to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
    [CA-102_electronics_tray.stl, LM6UU_L1.step, LM6UU_L2.step, LM6UU_R1.step, LM6UU_R2.step, arduino_uno.step, axle_R.step, base.step]
2026-11-04 Live-site links in the README; fix charset on the detail and concepts viewers
    The two viewer templates had no doctype or charset, so the degree and multiply signs showed
    as mojibake (Â°). README gets a table of the GitHub Pages links and the wiring GIF.
    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
2026-11-04 Viewers load three.js from the repo; fix mobile layout and the Legend toggle
    - viewer/lib/: three.js r128 + OrbitControls (MIT, license included). All three viewers
    load it from the site itself, CDN only as a fallback. On a phone the CDN did not load,
    so the 3D view showed 'did not load' and no button worked.
    - wiring_360: no sideways scroll on narrow screens; Legend now hides the route list too
    (an inline style kept it visible).
    - Tested on an emulated Pixel 7 with every outside host blocked: all viewers render,
    buttons work, no horizontal overflow.
    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
2026-11-04 WIP: per-move wiring animations (motion check + renderer)
    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
    [wiring_harness.step]
2026-11-04 Wiring through each move: one see-through animation per action
    - backend/cad/wiring_motion.py: the 3 column leads through GRIP, LIFT, FLIP, TURN, LOWER,
    RELEASE. Tied runs move with their part; each loop is draped with its real cable length
    under gravity and settled onto any part it meets. Slack used per loop (<= 80 %) and
    clearance every 3rd frame: all pass (worst: wrist loop 79 % at the end of the flip).
    - backend/tools/render_wiring_motion.js -> viewer/wiring_motion.html (play each move or
    all six, slack bars) and docs/wiring/motion/1_GRIP..6_RELEASE.gif + all_moves.mp4
    - Scene.push in wiring.py: contact for draped loops
    - docs/10 section, README and site links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
2026-11-04 All six moves as one GIF (docs/wiring/motion/all_moves.gif)
    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
2026-11-05 Shopping list: must-buy vs household swaps
    Build guide section 1 now splits the purchases: must buy (servos, 6807, LM6UU + 6 mm
    rod, buck) with why there is no substitute, and items that can come from home (old 12 V
    adapter, salvaged jack, jumper chains, twist ties/tape, inner-tube or rubber-band pads,
    rocks/pennies glued in as ballast, hot-glue feet) with what to check for each.
    Assembly step: glue the ballast in (the pockets are open underneath).
    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
    [make_build_guide.py]
2026-11-05 Prototype v1 BOM: already have / must buy / find at home
    docs/11_bom_prototype_v1.md: must-buy items with the actual cart listings, prices
    ($52.57) and links; household items free if found, with a buy option; the LIZVOR
    adjustable adapter replaces the 12 V adapter and its terminal-block tip the panel jack;
    what the weekend test decides. Linked from the README and the build guide.
    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
    [make_build_guide.py]
2026-11-05 Final build package: physics recheck, print plates + settings, IKEA-style manual, bench test
    Physics (backend/mech/mech_checks.py, 53/53 PASS): new prototype-v1 section for the parts
    actually bought and the household swaps: Adeept 996R / Miuzei MG90S torque needed, rubber
    pads at mu 0.35 (3.8x), tip-over with no ballast (37 mm), LIZVOR 2 A adapter (0.42 A run,
    1.60 A with the MG996R stalled), jumper-chain drop (0.19 V), h8 rod wobble (0.15 mm).
    Assembly check (backend/tools/make_manual.py): every part slid in along its arrow against
    everything already built, plus a scan of parts that move together (the motion check skips
    those). Found and fixed in the CAD: spine foot inside the turret plate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
    [CA-101_base.stl, CA-102_electronics_tray.stl, CA-202_spine.stl, CA-301_carriage_arm.stl, CA-401_gripper_frame.stl, LM6UU_L1.step, LM6UU_L2.step, LM6UU_R1.step]
2026-11-05 Manual: PART E with the circuit and the electronics bench test
    The assembly manual now opens with PART E (the electronics, done first): the full wiring
    diagram, E1 every connection (from docs/04_wiring.md), E2 power bring-up, E3 one servo at a
    time with firmware/bench_test, E4 troubleshooting, E5 the jumper-chain dry run, each row with
    a checkbox; then PART M, the mechanical steps. Pulled from the source docs so it can't drift.
    Wire list: gripper on a 500 mm extension, LIZVOR terminal-block tip as the jack.
    CLAUDE.md records the rule that the manual must include the electronics.
    Claude-Session: https://claude.ai/code/session_019RiFonUX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
2026-11-08 Print settings for the Creality CR-6 SE
    235 x 235 bed (plates fit), PTFE-lined hotend: nozzle max 240 C (first layer 238), Bowden
    retraction 5 mm, glue stick as a release layer on the carborundum glass, clean nozzle before
    auto-levelling, short G-code file names.
    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
2026-11-08 Print plates carry their per-part settings; every plate test-sliced in PrusaSlicer
    - The .3mf files now include PrusaSlicer per-object settings: supports only on the base,
    turret plate, carriage arm and fingers; fingers at 100 % infill; 5 mm brim on the lift link.
    Verified by slicing each plate with PrusaSlicer 2.7 and reading the G-code (support moves only
    on those parts, ~5x infill in the fingers, brim present only with the setting).
    - Plates re-packed for the Creality CR-6 SE (235 x 235) with 14 mm between parts. The fingers
    are on different plates: PrusaSlicer 2.7 reports a false G-code path conflict and crashes
    when the supported left finger shares a plate with the right finge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
    [plate0_coupon.3mf, plate0_coupon.stl, plate1_base.3mf, plate1_base.stl, plate2_tray_spine.3mf, plate2_tray_spine.stl, plate3_arm_claw.3mf, plate3_arm_claw.stl]
2026-11-08 Plan P quick prototype + CR-6 SE print troubleshooting
    - docs/14_plan_p_quick_prototype.md + docs/plan_p/plan_p.png (backend/tools/make_plan_p.py):
    cardboard / foam-board version with the real dimensions (61.1 mm grip height, 5 in radius,
    wrist axis through the can, 20 mm crank, 11.4 mm link), the keep-clear sweep, staged tests
    P0-P5 with pass criteria, a no-print claw fallback, what it does and doesn't prove.
    - Only the claw is printed: cad/print/plates/planP_1_claw (frame + right finger, ~3.9 h) and
    planP_2_finger (left finger + coupon, ~3.3 h), both test-sliced in PrusaSlicer.
    - docs/15_cr6se_print_troubleshooting.md: pre-print checklist, symptom -> cause -> fix for
    adhesion, wa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
    [planP_1_claw.3mf, planP_1_claw.stl, planP_2_finger.3mf, planP_2_finger.stl, plate0_coupon.3mf, plate1_base.3mf, plate2_tray_spine.3mf, plate3_arm_claw.3mf]
2026-11-10 Uno on its own 9 V battery; standard schematic; power re-simulated
    - Power: the 9 V battery powers only the Uno (barrel jack or VIN); the 12 V adapter feeds only
    the XL4015 buck for the servos; grounds joined. backend/ee/power_final.py simulates it in
    ngspice (normal, MG996R stall, power-up; fresh and nearly flat battery; with and without the
    1000 uF capacitor, plus a fast-inrush case): Uno 5.00 V (4.92 V on a flat battery), servos
    >= 5.51 V, adapter <= 1.69 A. The capacitor is optional while testing (worst inrush 4.65 V /
    6.6 V without, 5.11 V / 6.15 V with). Battery life ~9 h.
    - docs/wiring/schematic.svg/.png (backend/ee/schematic.py): standard symbols and net labels.
    - Wiring di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
    [make_wiring_diagram.py, mech_checks.py, power_final.py, schematic.py]
2026-11-10 Laptop control panel: drive each servo, HOME, START and STOP over USB
    - firmware/concept_a/concept_a.ino: serial commands next to the button: s (START), t/l/w/g <angle>
    (eased single-servo moves inside safe limits), h (home one servo at a time), x (stop), ? (status);
    live '@ MODE STEP t l w g' reports. START (button or laptop) only runs from HOME, because the first
    step would otherwise move several servos at once from an unknown pose. Compiles: 26.7 % flash.
    - viewer/control_panel.html: Web Serial page (Chrome / Edge): connect, a card per servo (slider,
    +/-5, working-angle presets), START / HOME / STOP (Esc), live angles, serial log, raw commands.
    - Tests without hardware: backend/to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
2026-11-10 Fix Arduino IDE compile error: types before the first function
    The Arduino IDE inserts a prototype for every function above the first function in the sketch.
    makePose() came before struct Step and enum Mode, so the prototypes for startSteps(Step*, int, Mode)
    and modeName(Mode) referred to types not declared yet ('Mode' was not declared in this scope).
    All structs and the enum now sit above the first function.
    backend/tools/arduino_build_check.py reproduces the IDE's prototype step and compiles all three
    sketches for the Uno: it fails on the old file and passes now (concept_a 26.7 %, servo_setup
    19.4 %, bench_test 15.0 % flash). Firmware host test 15/15 and control-panel test 11/11 still pas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
    [arduino_build_check.py, concept_a.ino]
2026-11-10 Calibration from the laptop: panel Calibration section + firmware reports its constants
    - concept_a.ino: prints its 9 calibration constants and the laptop-move limits at power-up and on 'c'
    ('= TURN_START 135 ... LIM_g 10 100'). IDE-style build check passes (27.7 % flash); host test 16/16.
    - control_panel.html: presets, sliders and the HOME check follow the firmware's reported values; +/-1
    buttons; Calibration table (what each angle should look like, firmware vs yours, Use current angle,
    Test), values kept in the browser, generated code block with Copy for concept_a.ino.
    - End-to-end panel test against the live firmware: 15/15 (adds calibration: values from 'c', +/-1
    nudge, capture i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
2026-11-10 Slower, smoother base: TURN 2.5 s, laptop base moves 18 ms/deg, microsecond steps
    - concept_a.ino: sequence TURN 1.5 -> 2.5 s (run 7.4 s); laptop moves per servo: base 18 ms/deg
    (90 deg in ~1.6 s), others 8; during a move every servo gets its in-between angle in
    microseconds (~10 us per degree) instead of whole degrees, so slow moves glide.
    - IDE-style build: 29.1 % flash. Firmware host test 20/20 (adds: 90 deg base move 1.63 s,
    < 1 deg per update, sequence 7.4 s). Panel end-to-end 15/15. Engineering checks 54/54 with the
    new timing (MG996R peak speed 19 % of no-load, turntable reaction 0.83 % of foot friction).
    - Run time updated in README, docs 02 / 09, report, Fusion script text.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
2026-11-10 Fallback kit for no 3D printer: options guide, 1:1 cut templates, STL zips + print-service order sheet
2026-11-14 Economy printing: draft / standard / detail profile per part, eco plates, fix-up guide, manual PART P
    [economy.csv, planP_1_claw_eco.3mf, planP_2_finger_eco.3mf, plate0_coupon_eco.3mf, plate1_base_eco.3mf, plate2_tray_spine_eco.3mf, plate3_arm_claw_eco.3mf]
2026-11-14 Economy printing by hand: 5 plates with one setting each, no .ini, no new 3D files; manual PART P updated
    [economy.csv, economy_plates.csv, planP_1_claw_eco.3mf, planP_2_finger_eco.3mf, plate0_coupon_eco.3mf, plate1_base_eco.3mf, plate2_tray_spine_eco.3mf, plate3_arm_claw_eco.3mf]
